Pete30/3dtiskarna/Home.md

Welcome to the **i3 Berlin** wiki!

These pages contain the full assembly manual to build and adjust your i3 Berlin through the following chapters:  

[**Introduction**](https://github.com/laydrop/i3-Berlin/wiki/Section-1-Introduction) About the history of this design and the power of open hardware.

[**Assembly of the Y-Unit**](https://github.com/laydrop/i3-Berlin/wiki/Section-2-Assembly-of-the-Y-Unit) The lower unit which holds the print platform.

[**Assembly of the XZ-Unit**](https://github.com/laydrop/i3-Berlin/wiki/Section-3-Assembly-of-the-XZ-Unit) The vertical part that holds the extruder.  

[**Wiring**](https://github.com/laydrop/i3-Berlin/wiki/Section-4-Wiring) All the wires and where to put them, and you will join the two units.

[**Calibration**](https://github.com/laydrop/i3-Berlin/wiki/Section-5-Calibration) See if everything works correctly and adjust it perfectly.

[**Printing**](https://github.com/laydrop/i3-Berlin/wiki/Section-6-Printing) How to use your printer and some tips to get started.
