Pete30/3dtiskarna/Section-6.1-FilamentHolder.asciidoc

link:Section-6.2-Cura[Next]

|====
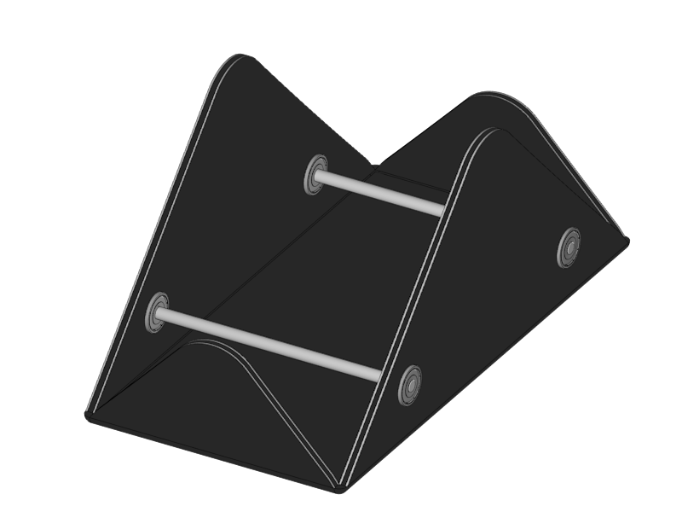
[picture p1: media/Section_6_0021.png]
1.3+||
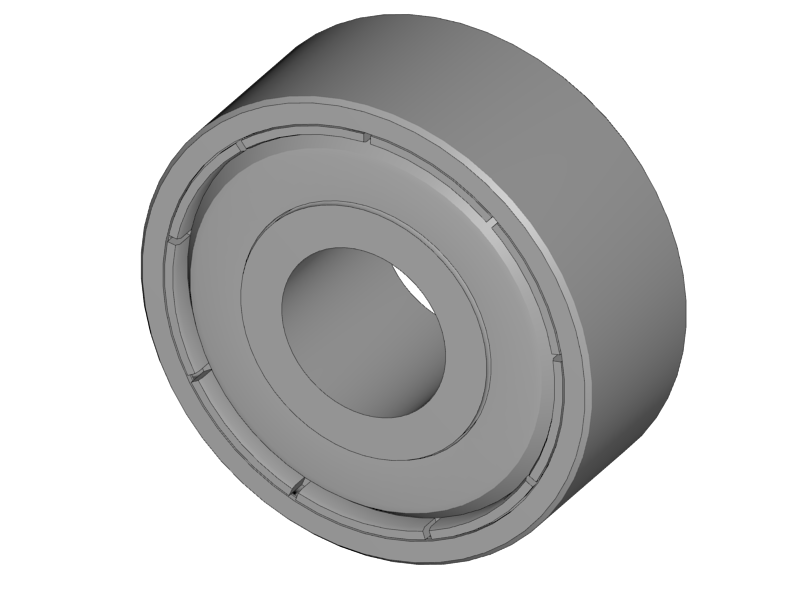
[picture p2: media/Section_1_0001.png]
 +
4x 624 Ball Bearing
|
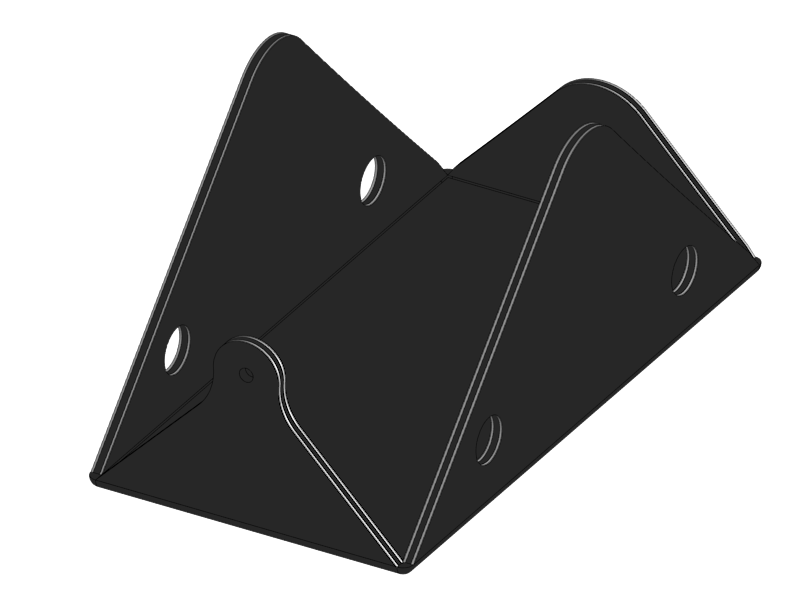
[picture p3: media/Section_1_0156.png]
 +
2x 4mm Rod
|
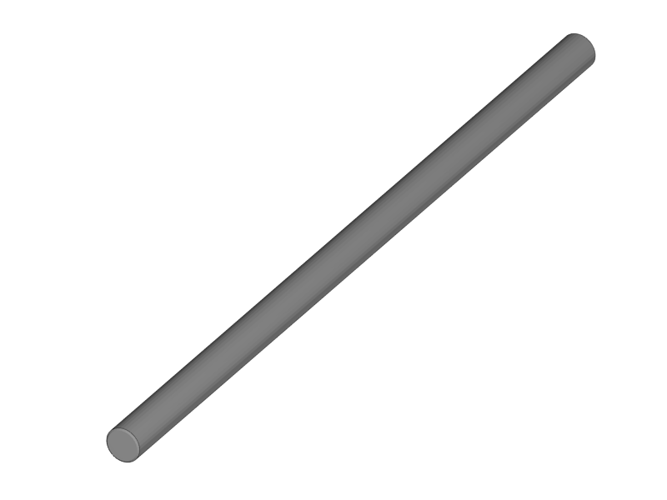
[picture p4: media/Section_1_0157.png]
 +
1x Filament Holder
|====

* Bend the sides of Filament Holder sandwich plate over the grooves. 
* Put the bearings on the 4mm rods
* Put the bearings into the holes of the filament holder
** Secure them with a drip of superglue.

''''''
<<<<<

|====
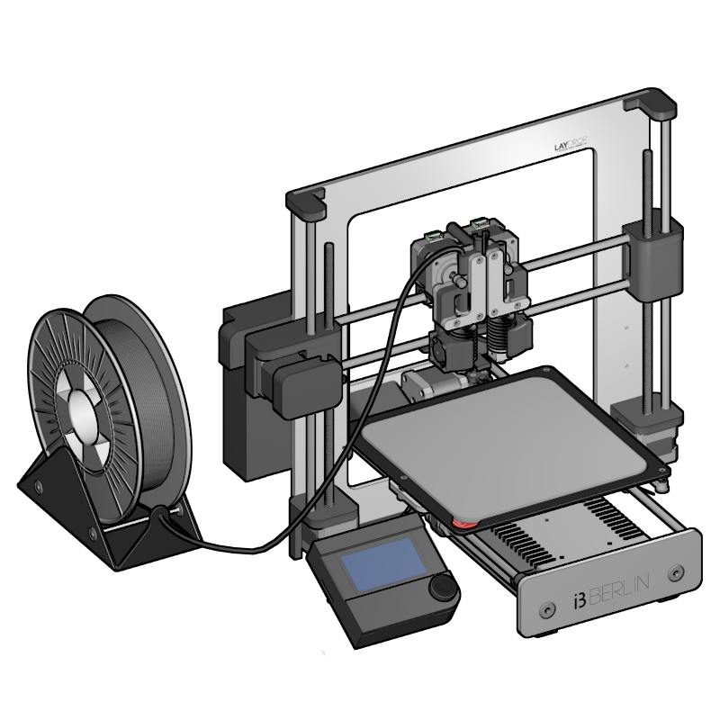
[picture p5: media/Section_6_0020.png]
1.1+||
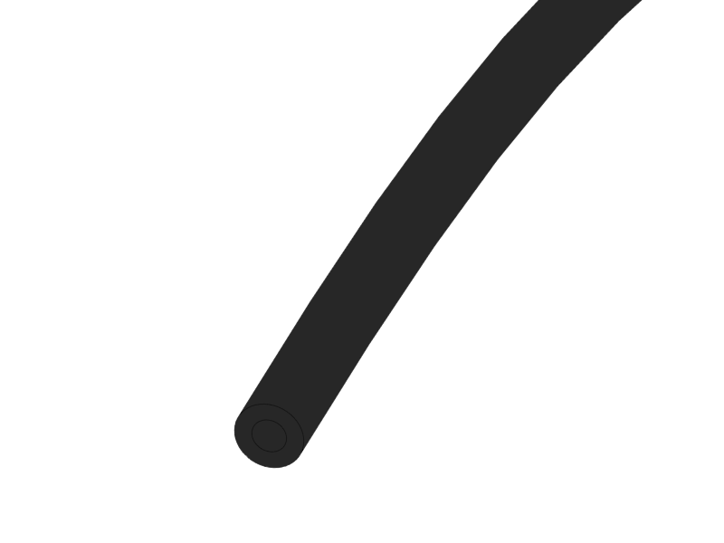
[picture p6: media/Section_1_0158.png]
 +
1x Teflon Hose
|====

* This is how the print set up should be. 
* Put the filament holder at a convenient position. Put the filament roll on top of the rods. Put the filament through the hole in the holder and through the Teflon pipe. 

link:Section-6.2-Cura[Next]
