Pete30/3dtiskarna/Section-4.8-Mounting-the-Heatbed.asciidoc

link:Section-5-Calibration[Next]

|====
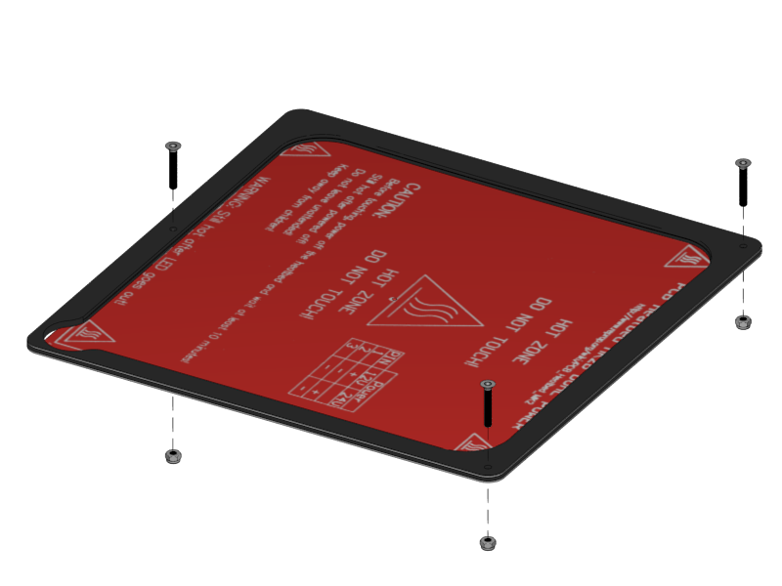
[picture p7: media/Section_4_0041.png]
1.4+||
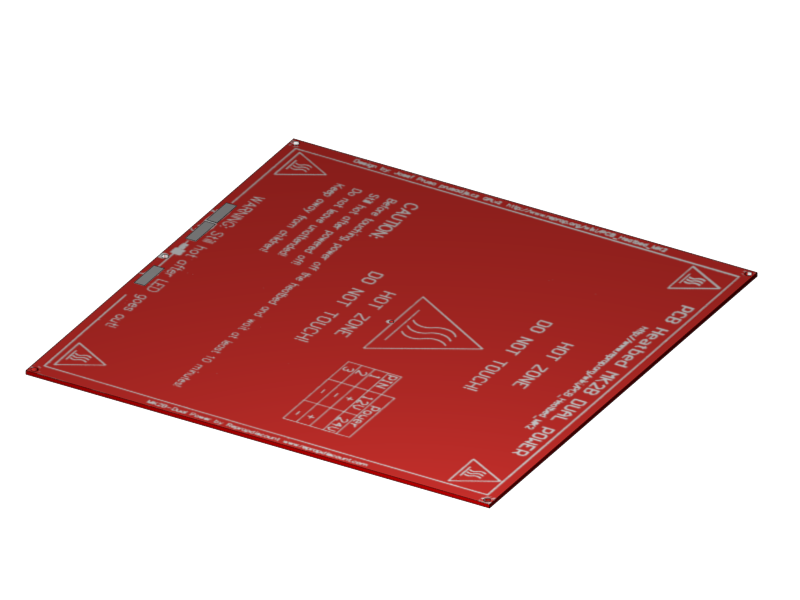
[picture p8: media/Section_1_0007.png]
 +
1x Heatbed
|
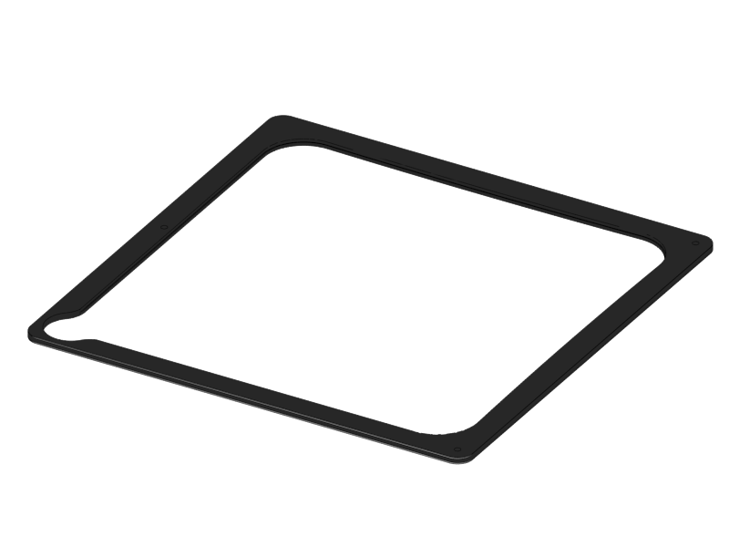
[picture p9: media/Section_1_0148.png]
 +
1x Mirror Clamp
|
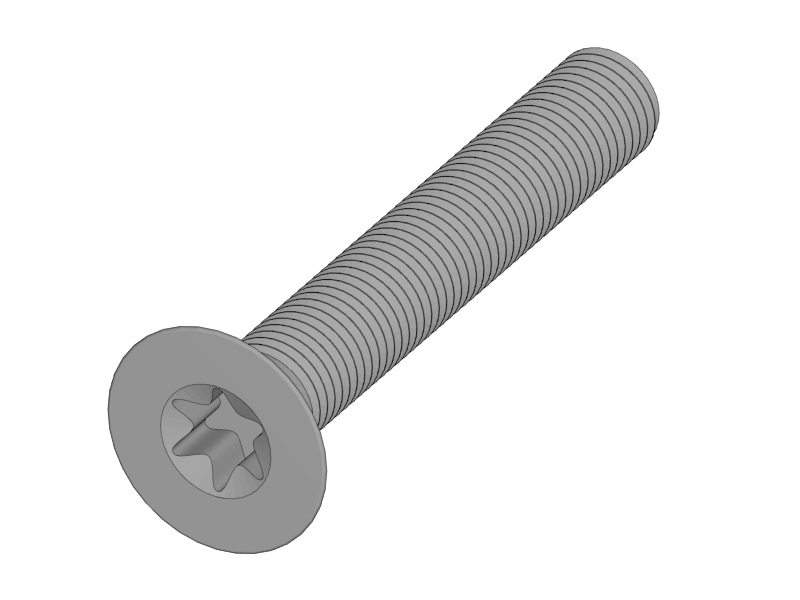
[picture p10: media/Section_1_0021.png]
 +
3x M3x20 CounterSunk
|
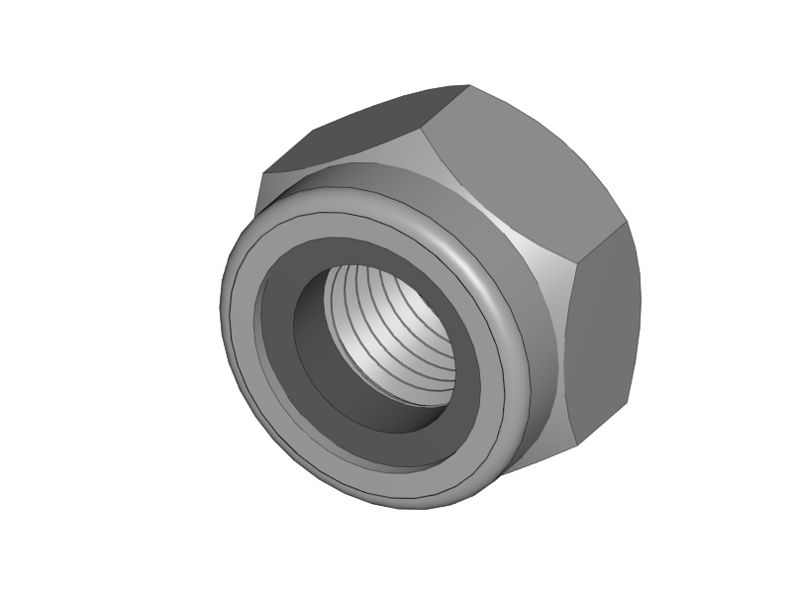
[picture p11: media/Section_1_0026.png]
 +
3x Lock Nut
|====

* Mount the Mirror Clamp onto the Heatbed with the screws and nuts.
** The matte side is mounted on top.
* Tighten the nuts until the head of the screws is being pulled smoothly into the material of the mirror clamp. 

''''
<<<<

|====
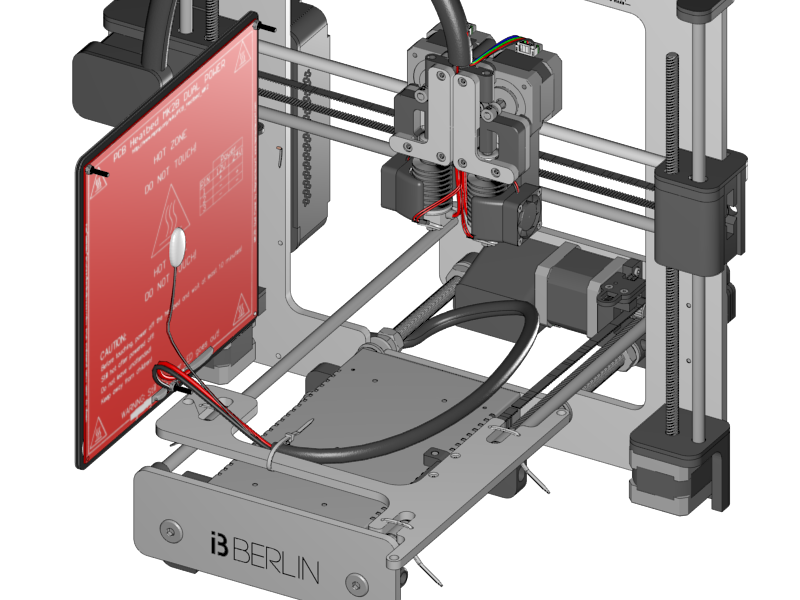
[picture p12: media/Section_4_0042.png]
1.1+||
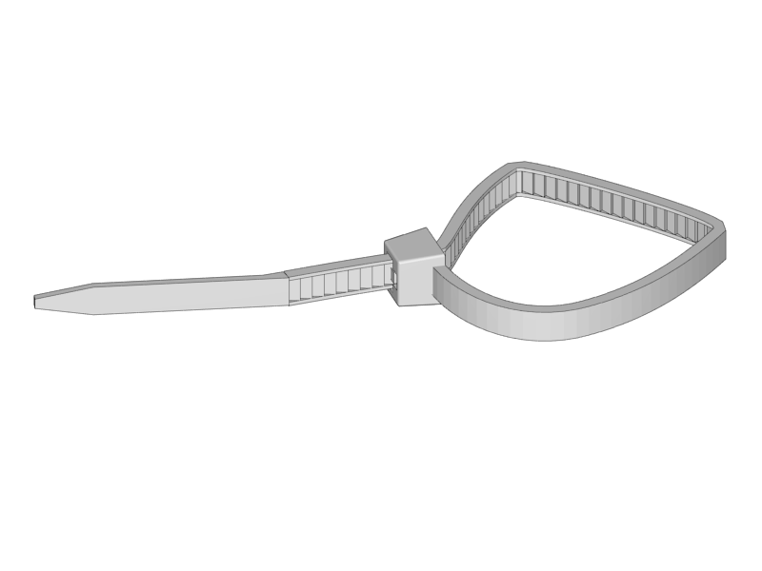
[picture p13: media/Section_1_0041.png]
 +
1x Ziptie
|====

* Hold the heatbed on the left side of the y-carriage as shown in the picture above
* Fix the braided sleeve of the heatbed cable to the back of the y-carriage with a zip tie
* Lay down the heatbed and organize the cable so that the wires are neatly underneath the heatbed. 

''''
<<<<

|====
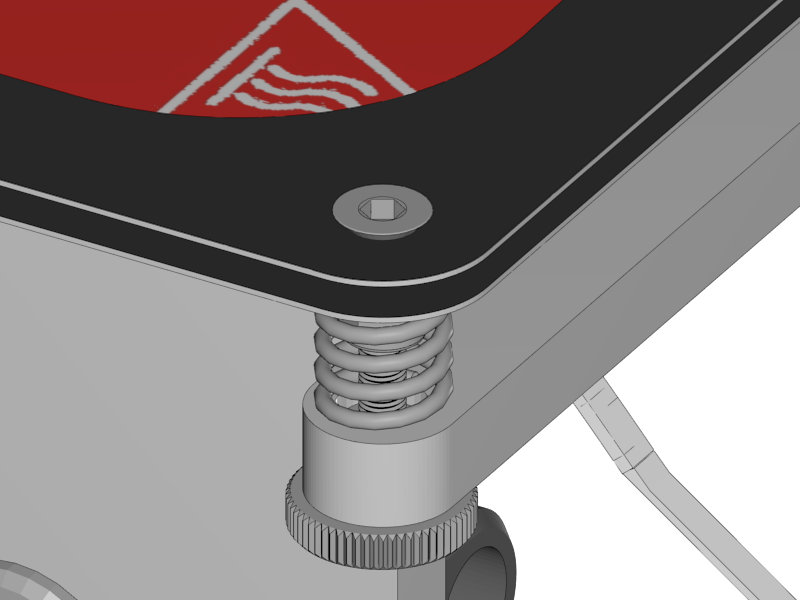
[picture p14: media/Section_4_0043.png]
1.2+||
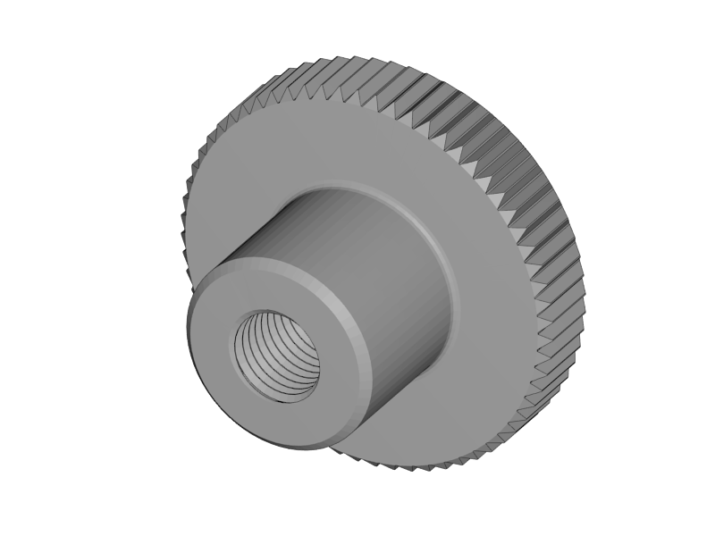
[picture p15: media/Section_1_0147.png]
 +
3x M3 Knurled Nut
|
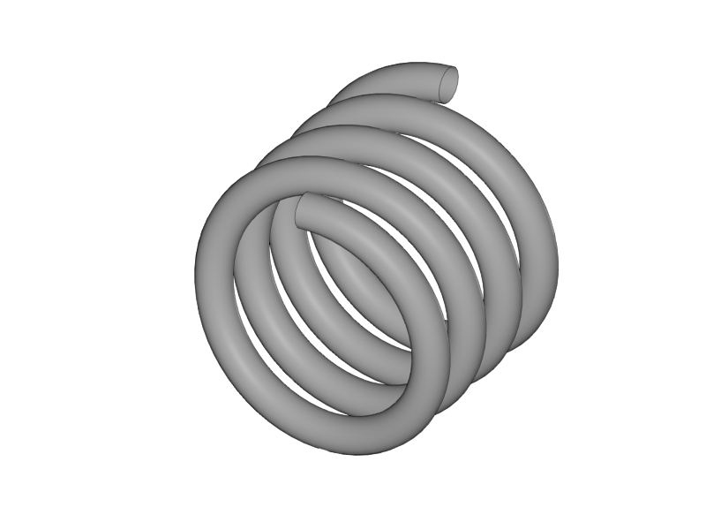
[picture p16: media/Section_1_0146.png]
 +
3x Spring
|====

* Put the springs over the screws.
* Tighten them with the knurled nuts.
* The adjusting of the heatbed happens in the next chapter so don't bother about it now.

''''
<<<<

|====
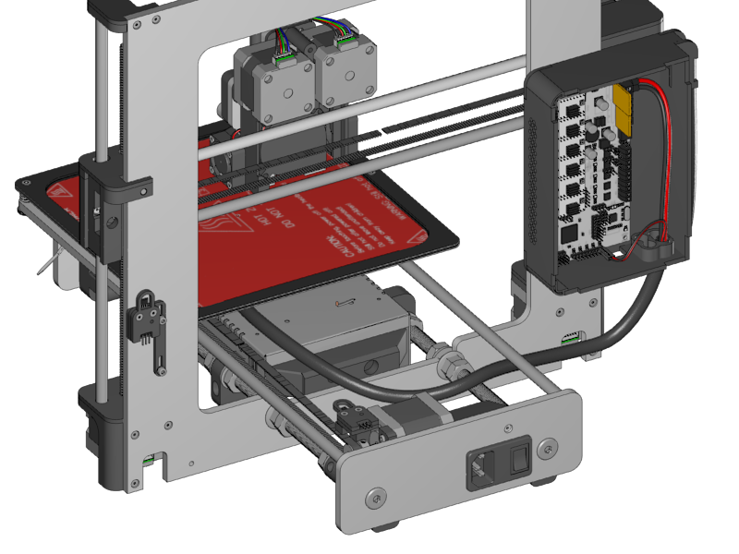
[picture p17: media/Section_4_0044.png]
1.2+||
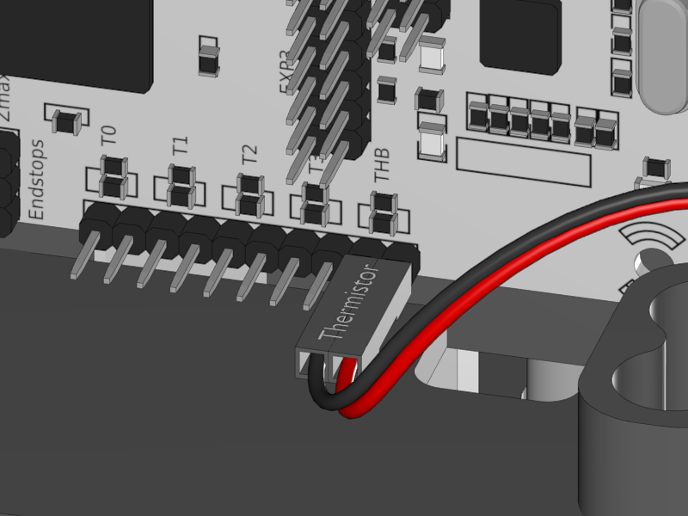
[picture p18: media/Section_4_0045.png]
 +
Heatbed Thermistor Connection
|
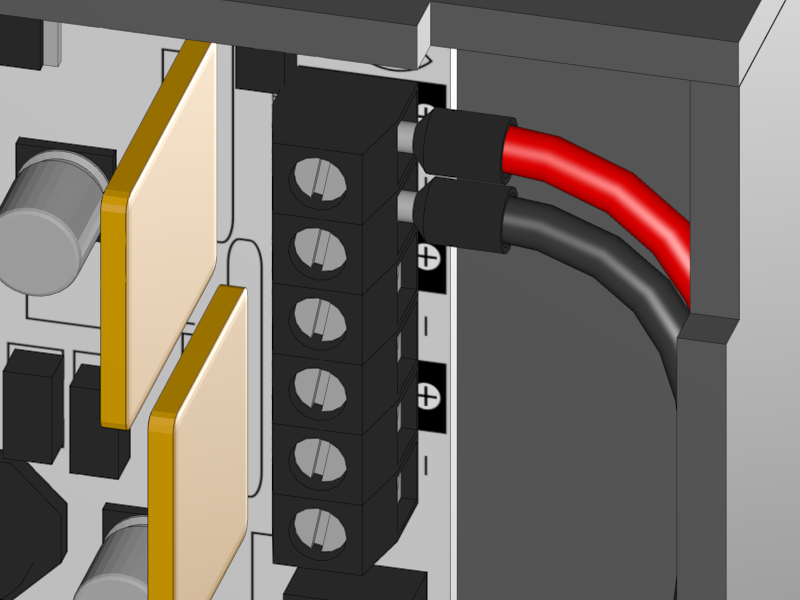
[picture p19: media/Section_4_0046.png]
 +
Heatbed Power Connection
|====

* Connect the heatbed to the RUMBA
** Fix the cable in such a way that it does not obstruct the movement of the Y-Axis. 
** The cable probably runs smoothest if guided between the M10 rod and the smooth rod. 
** Experiment with how to fix the cable with zipties for optimal movement. 

link:Section-5-Calibration[Next]
