Pete30/3dtiskarna/Section-1.3-Preparing-Casings.asciidoc

link:Section-2-Assembly-of-the-Y-Unit[Next]

link:Section-1-Introduction[Section Menu]

|====
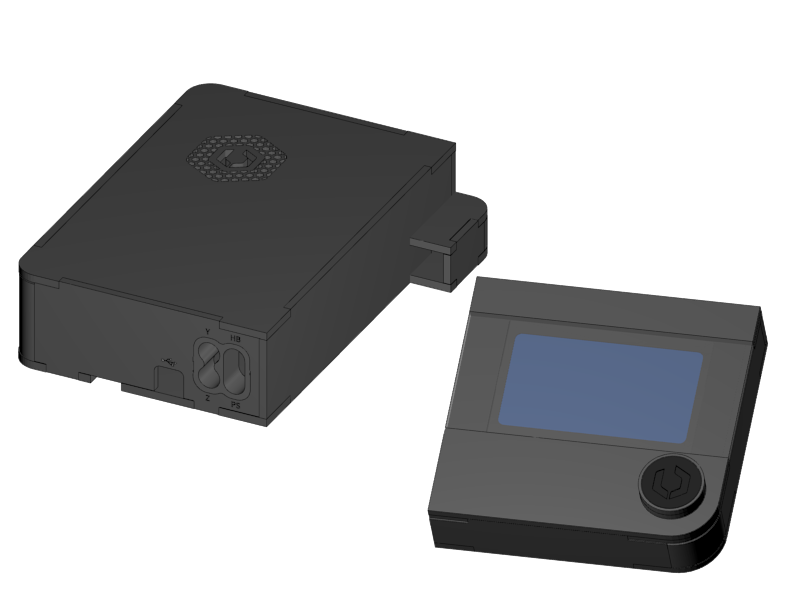
[picture p24: media/Section_6_0008.png]
|
|====

You will start the assembly with glueing the casings for the RUMBA controller electronics and the display. Since the glue needs time to dry it's to best to have this done now. 

Please don't use 1 second cyano-acrylat superglue for glueing the acrylic and printed parts, because they will probably cause ugly white stains.

''''
<<<<

|====
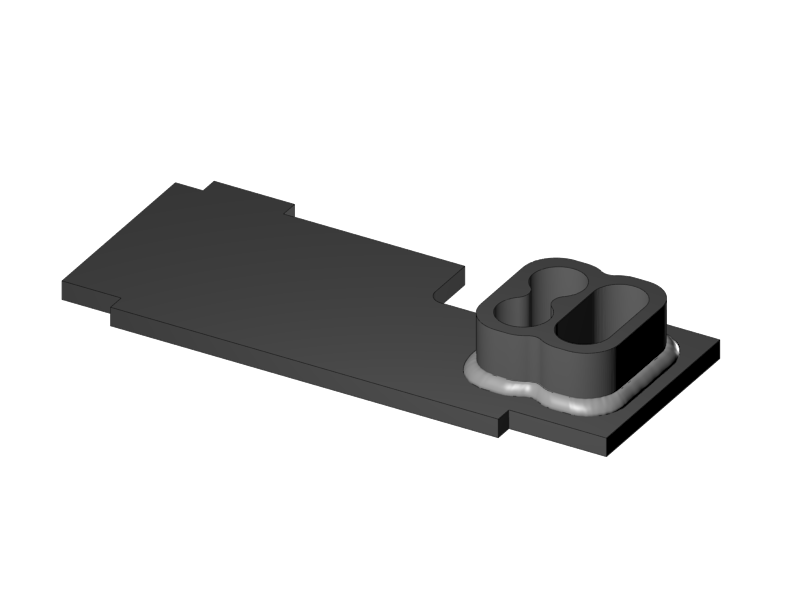
[picture p25: media/Section_6_0001.png]
1.2+||
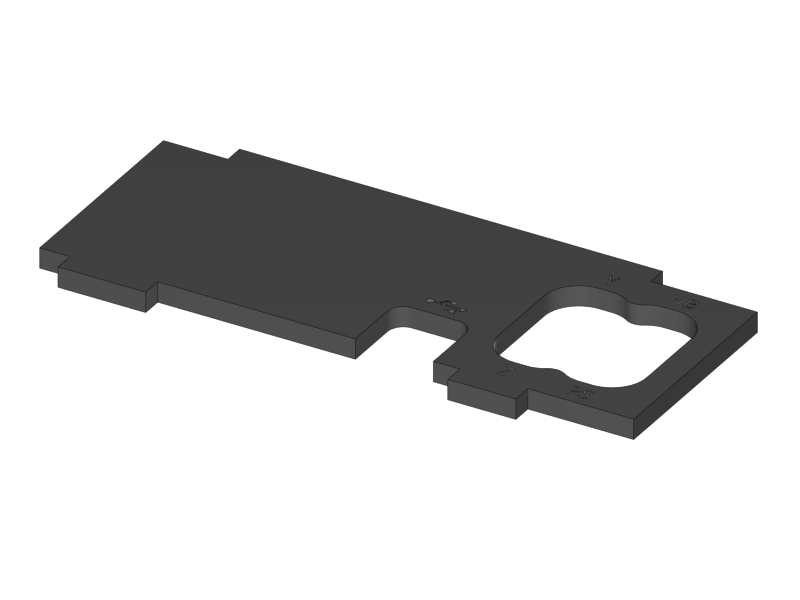
[picture p26: media/Section_1_0130.png]
 +
1x RUMBA Case Bottom
|
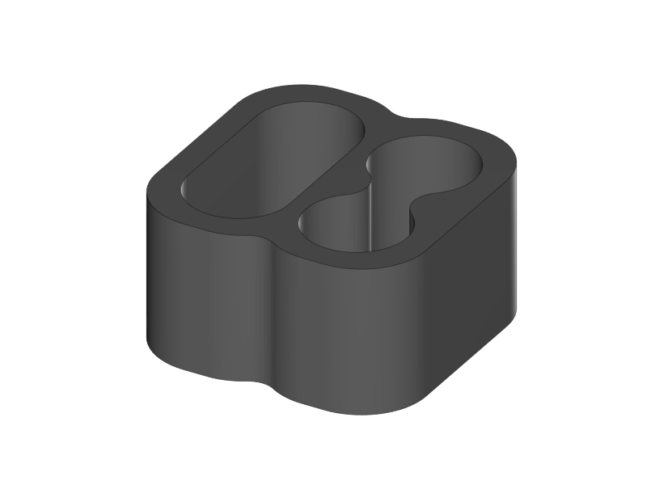
[picture p27: media/Section_1_0131.png]
 +
1x RUMBA Case Cable Inlet
|====

* Look for the RUMBA Case Bottom part in the bag of acrylic parts.
** Remove the protective film on the shiny side of the acrylic.
* The Cable Inlet can be found in the bag of printed parts. 
* Stick the parts together in such a way that the printed part is flush with the engraved side of the acrylic part. 
* If the parts are not fixed well, apply some plastic glue in the corners. 
** Mind that the matte side of the acrylic is going to be the visual outside of the casing, so prevent glue stains here. 

'''''
<<<

|====
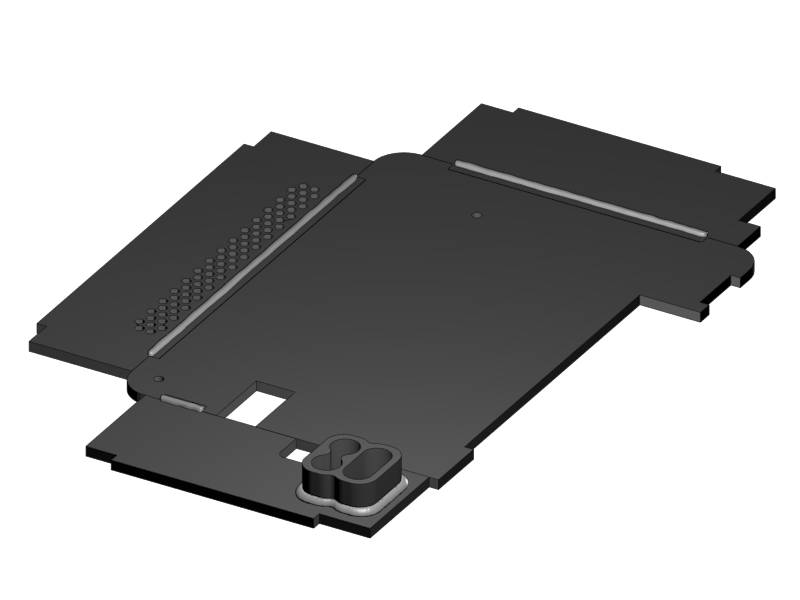
[picture p28: media/Section_6_0003.png]
1.3+||
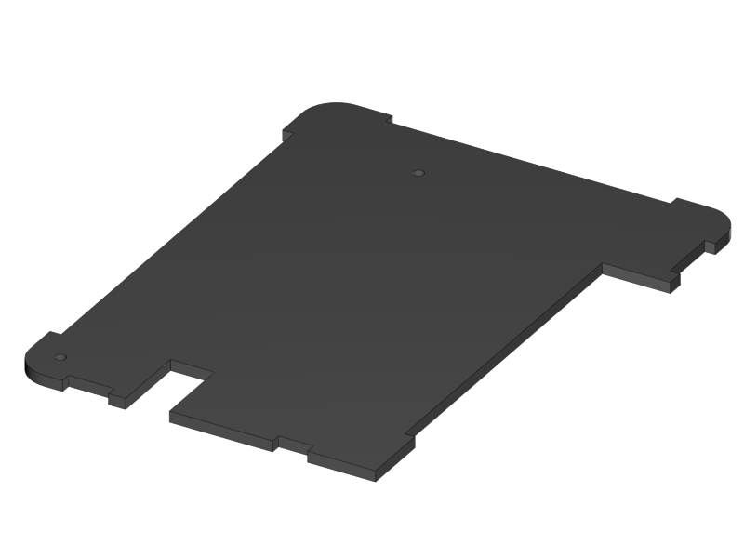
[picture p29: media/Section_1_0129.png]
 +
1x RUMBA Case Base
|
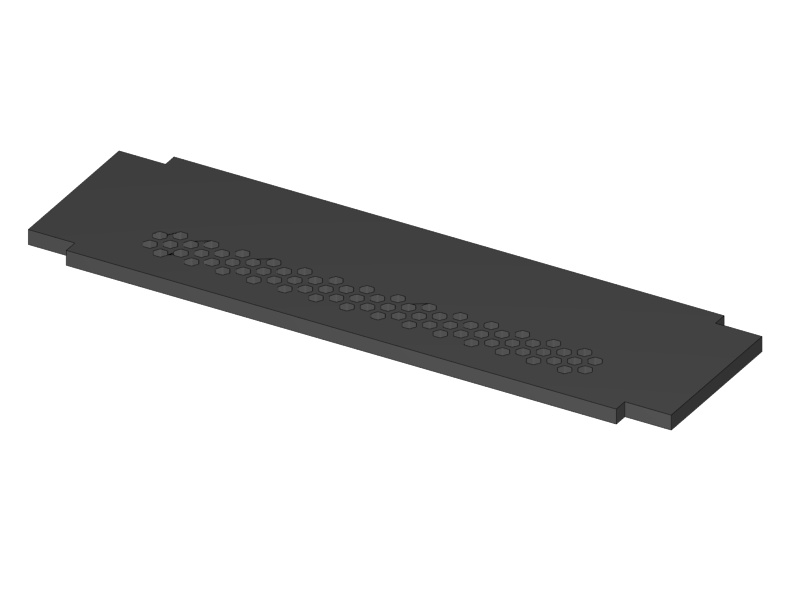
[picture p30: media/Section_1_0133.png]
 +
1x RUMBA Case Left Side
|
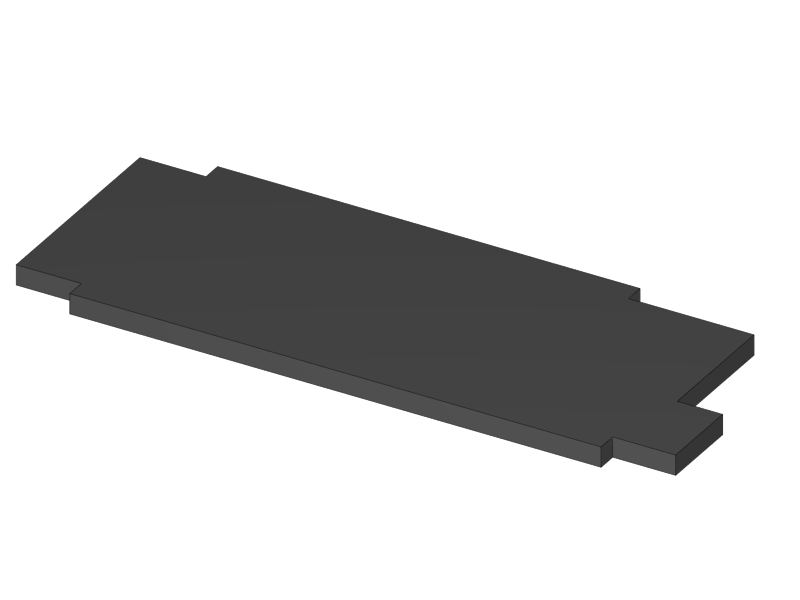
[picture p31: media/Section_1_0139.png]
 +
1x RUMBA Case Top
|====

* Remove the protection film on the shiny side of the acrylic.
** Leave the protection film of the matte side in place as much a possible to prevent scratches and glue stains.
* Connect the parts as shown above with the shiny part on top.
* Take a good look at the image. Apply a line of glue in such a way that it will always stay inside of the casing to prevent stains. 

''''
<<<

|====
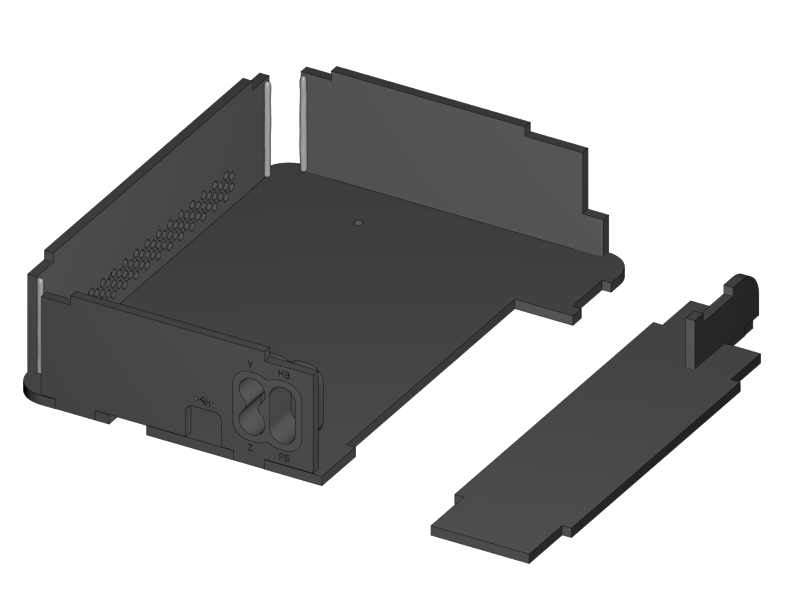
[picture p32: media/Section_6_0004.png]
1.1+||
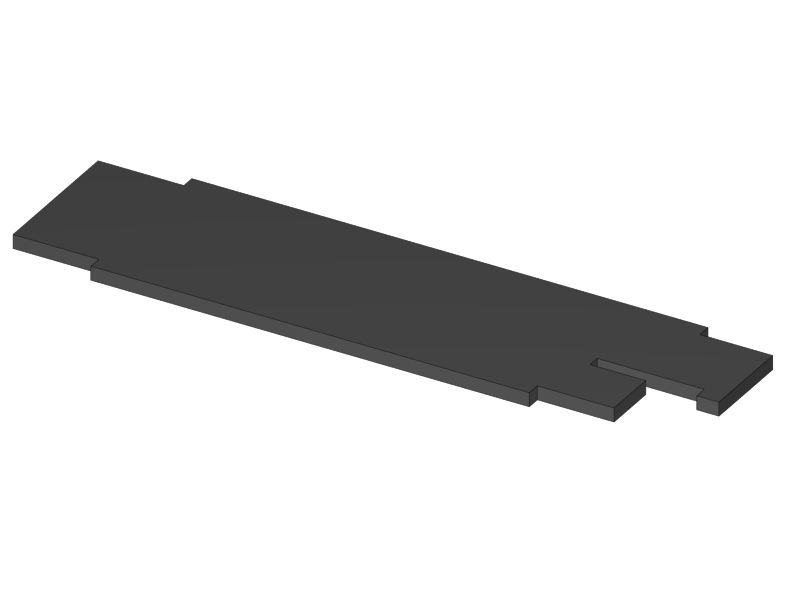
[picture p33: media/Section_1_0135.png]
 +
1x RUMBA Case Right Side
|
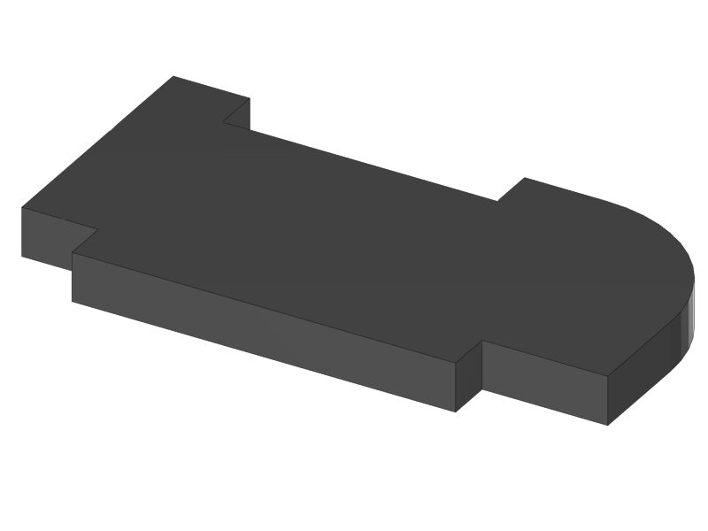
[picture p34: media/Section_1_0137.png]
 +
1x RUMBA Case Side Top
|====

* Flip up the 3 sides as shown in the picture above, and push them well in place. 
* Prepare a line of glue on the two left corners.
* Remove the protective film of the acrylic parts.
* Push in the small piece as shown.
** Apply glue if necessary.
* Put 3 lines of glue on the shiny side of the big part as preparation. 

''''
<<<<

|====
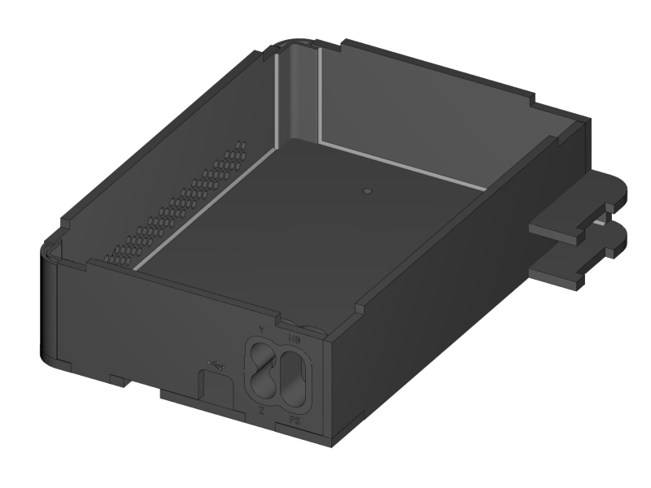
[picture p35: media/Section_6_0005.png]
1.1+||
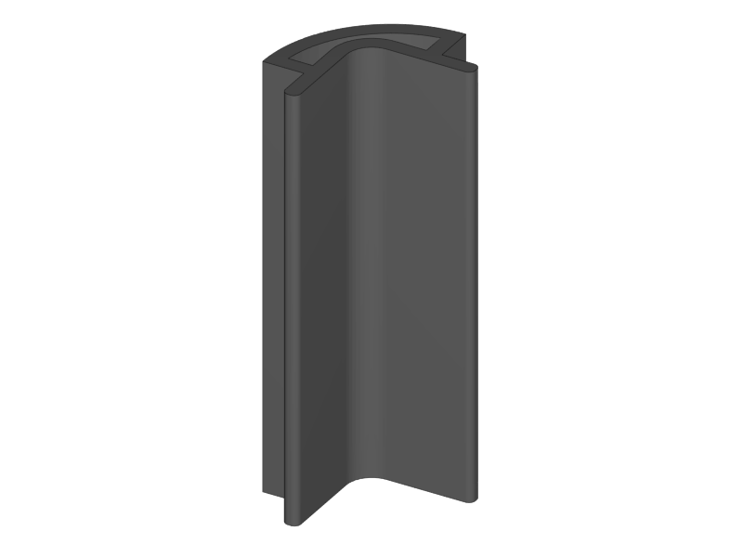
[picture p36: media/Section_1_0132.png]
 +
2x RUMBA Case Corner
|====

* Put the Right Side of the case into position
** It's done easiest by placing the lower corner in position first and then turning the part in a counter clockwise direction looking from the top. 
* Slide in the 3D printed corners. 
* Put extra glue into all the corners to secure strength.
* Fix all the parts with some tape where needed and leave it to dry. 

''''
<<<<

|====
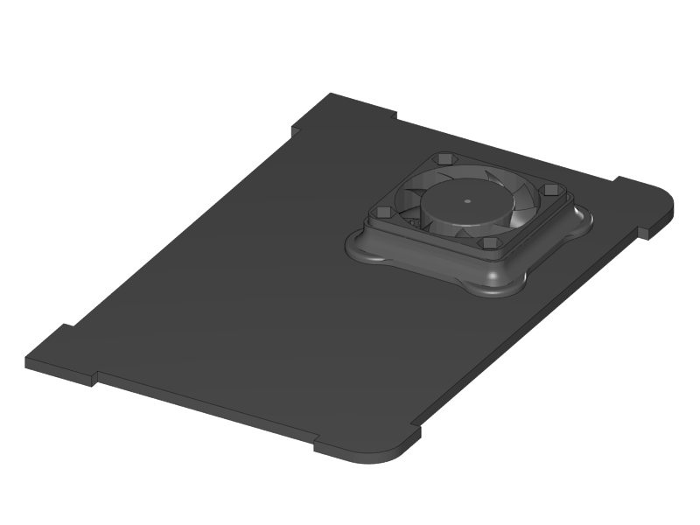
[picture p37: media/Section_6_0006.png]
1.3+||
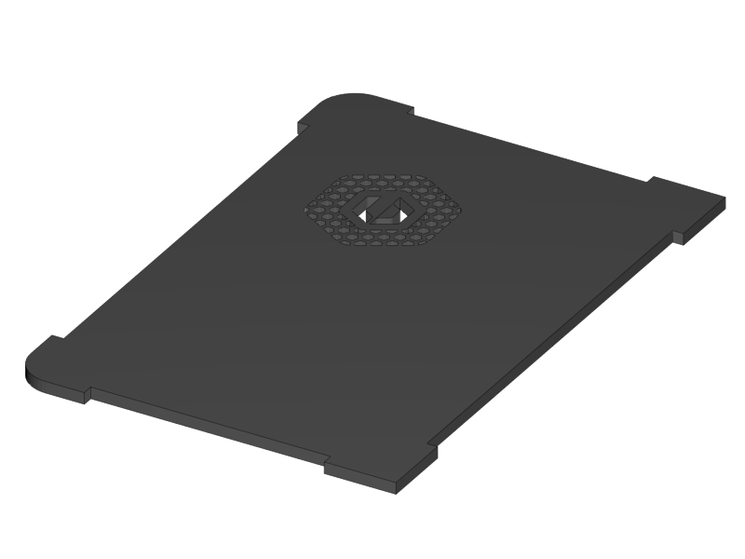
[picture p38: media/Section_1_0134.png]
 +
1x RUMBA Case Lid
|
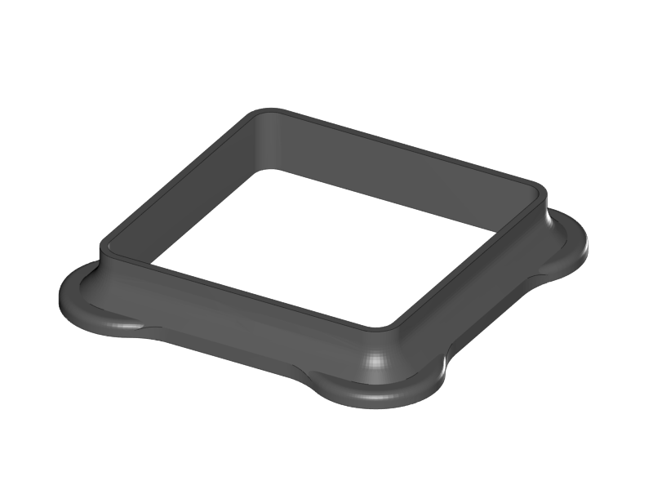
[picture p39: media/Section_1_0140.png]
 +
1x RUMBA Case FanHolder
|
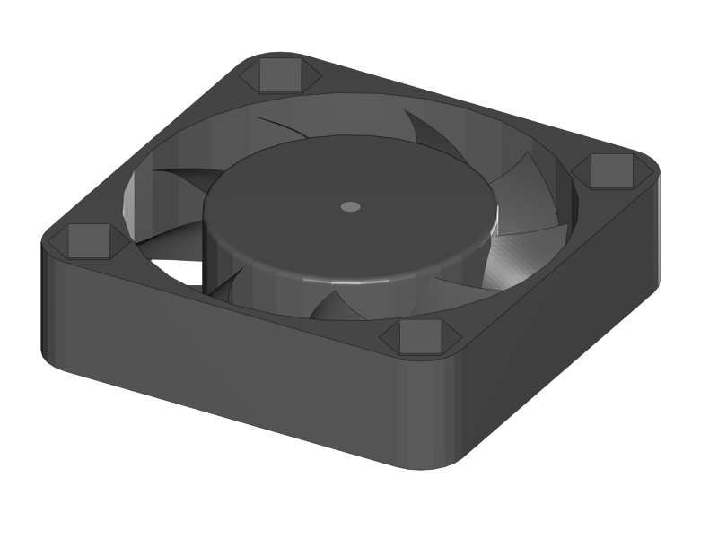
[picture p40: media/Section_1_0141.png]
 +
1x 40mm Fan
|====

* Glue the FanHolder on the shiny side of the RUMBA Case Lid. 
** Putting the fan first helps with aligning the position of the fan holder
** Note that the fan should NOT be glued to anything
** The fan can be found in the box of the RAMPS electronics
** Putting the sticker of the fan towards the outlet is recommended. Like that it will suck air out of the casing instead of blowing it in. An airstream like this reduces dust accumulations. 
** You can leave the fan. 
* The casing is now finished. The remaining parts will be glued later in the wiring section. 

''''
<<<<

|====
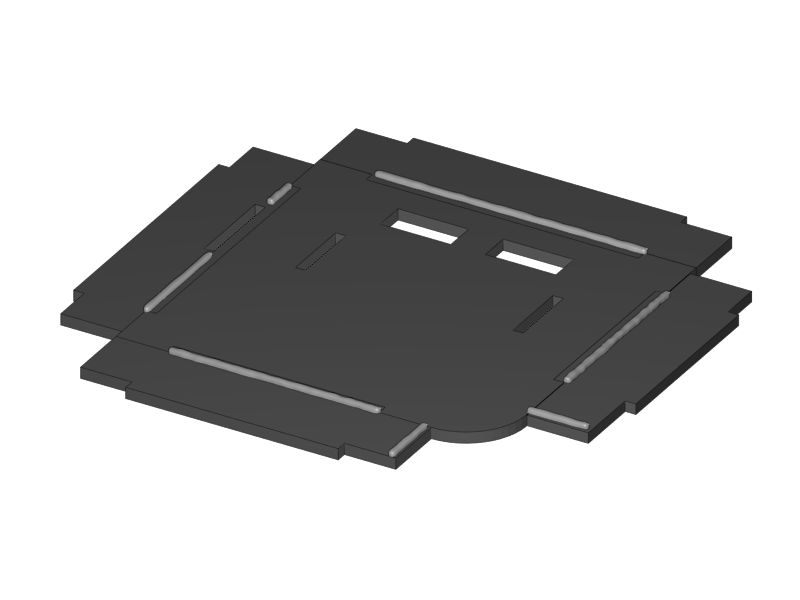
[picture p41: media/Section_6_0010.png]
1.5+||
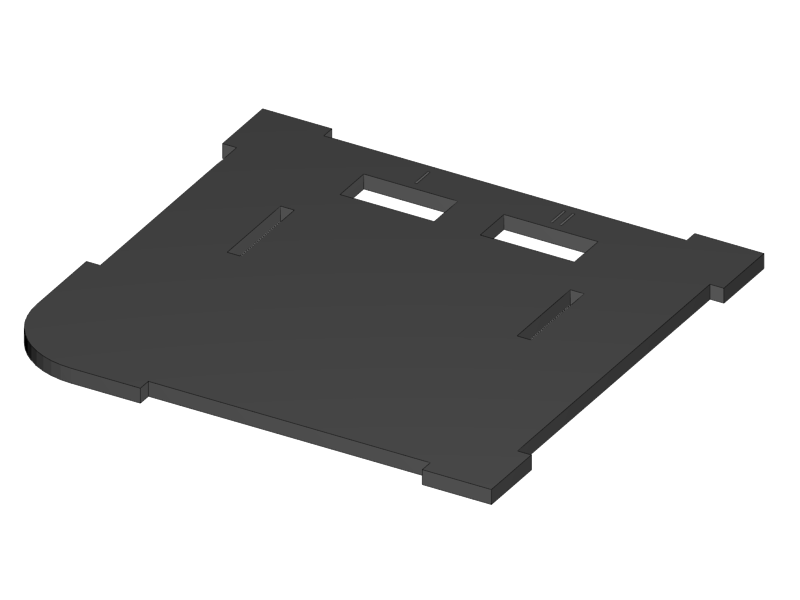
[picture p42: media/Section_1_0114.png]
 +
1x Display Case Base
|
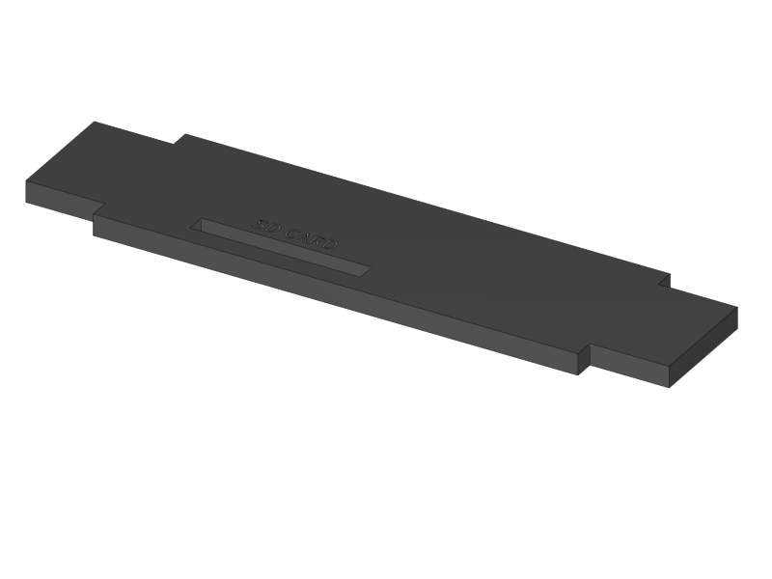
[picture p43: media/Section_1_0122.png]
 +
1x Display Case Left
|
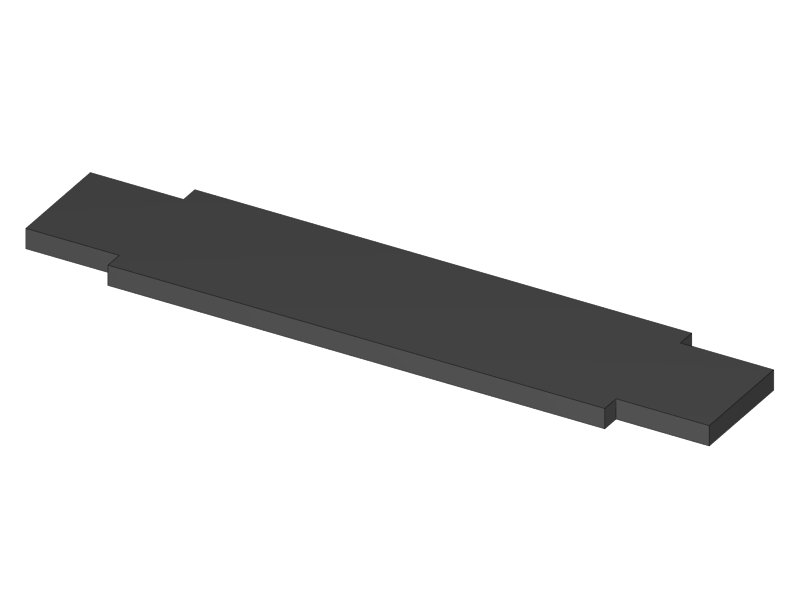
[picture p44: media/Section_1_0115.png]
 +
1x Display Case Back
|
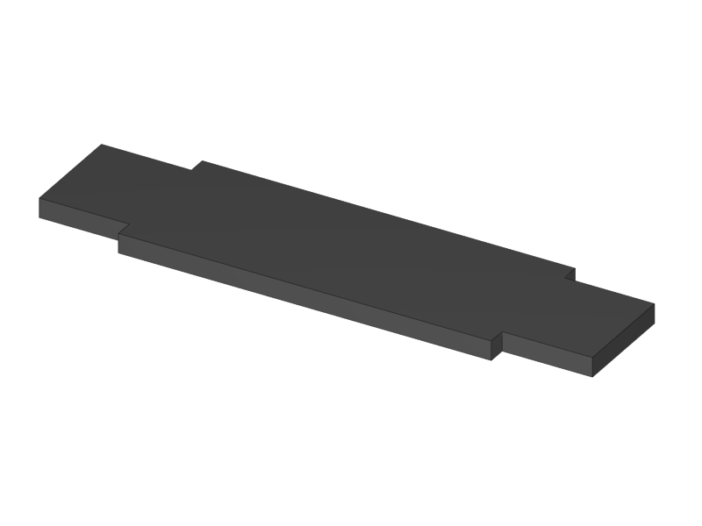
[picture p45: media/Section_1_0118.png]
 +
1x Display Case Front
|
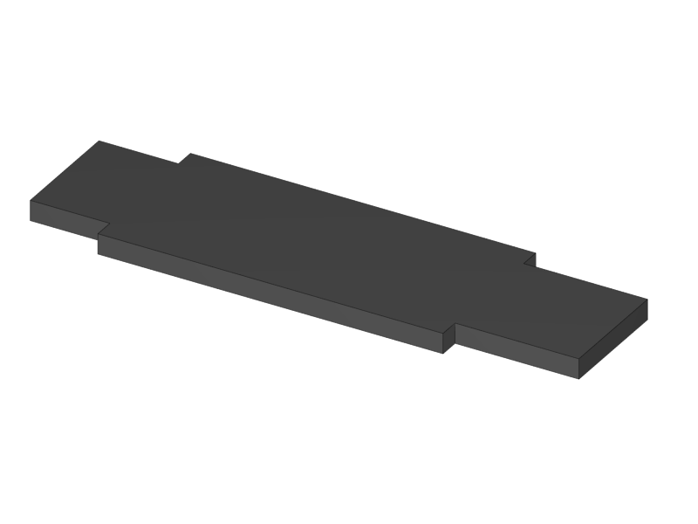
[picture p46: media/Section_1_0123.png]
 +
1x Display Case Right
|====

* Remove the protective film from the shiny side of the acrylic parts.
** It's best to leave the protective film on the matte side.
* Put them together as shown above.
* Apply a line of glue on the exact place as shown above.

''''
<<<<

|====
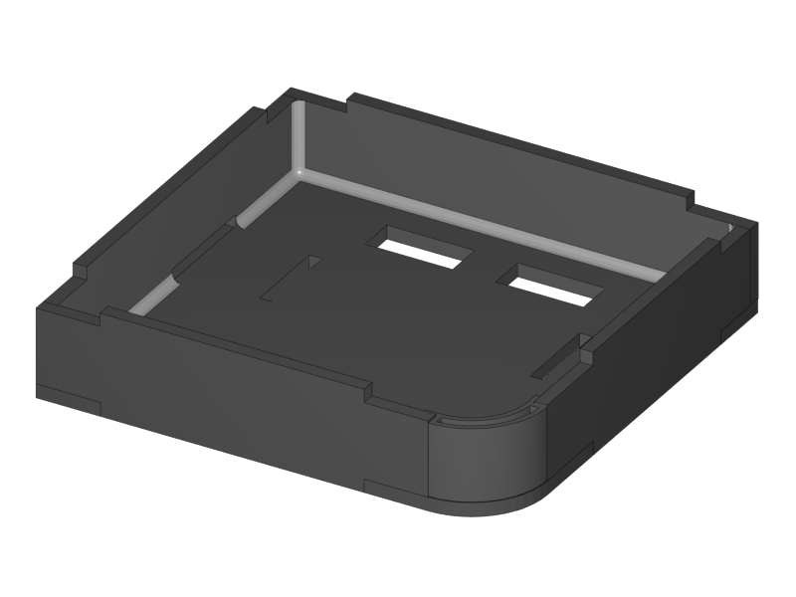
[picture p47: media/Section_6_0011.png]
1.1+||
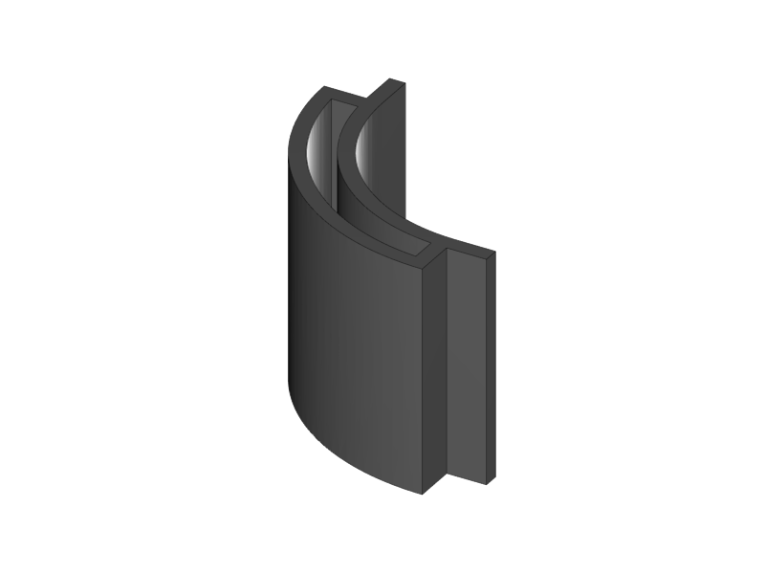
[picture p48: media/Section_1_0116.png]
 +
1x Display Case Corner
|====

* Flip up the sides. 
* Put in the corner and glue it
* Apply some extra glue in the inner corners of the case to secure strength
* Put tape where needed and let the case dry. 

''''
<<<<

|====
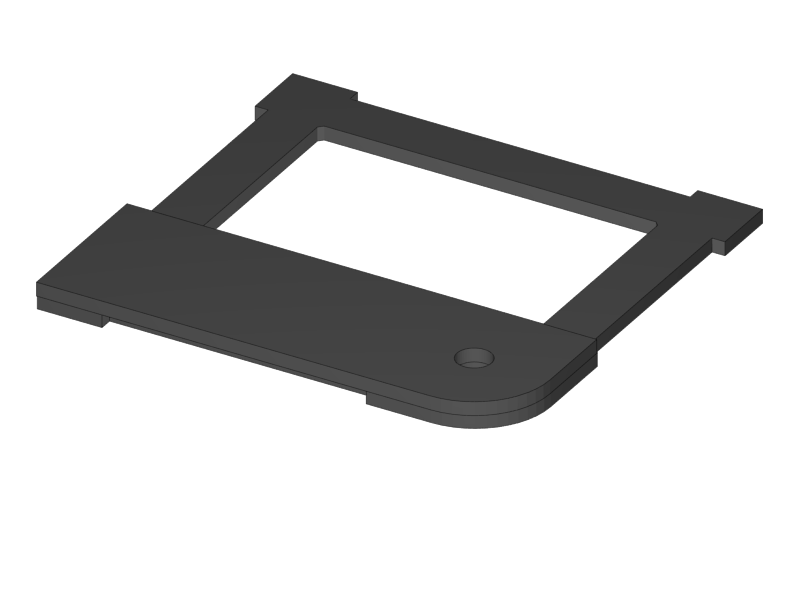
[picture p49: media/Section_6_0012.png]
1.2+||
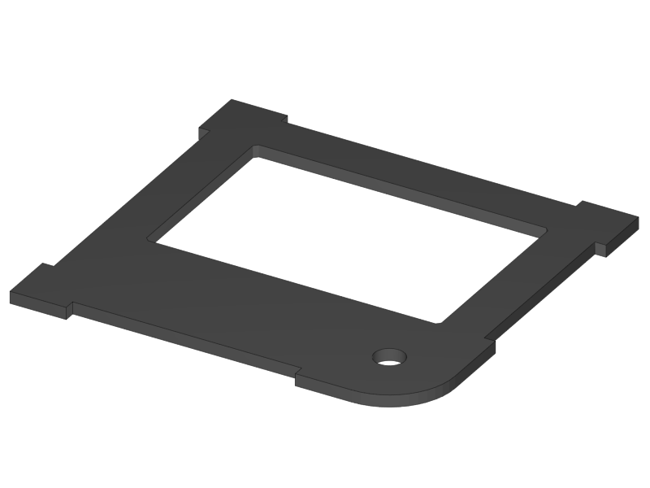
[picture p50: media/Section_1_0125.png]
 +
1x Display Case Top Base
|
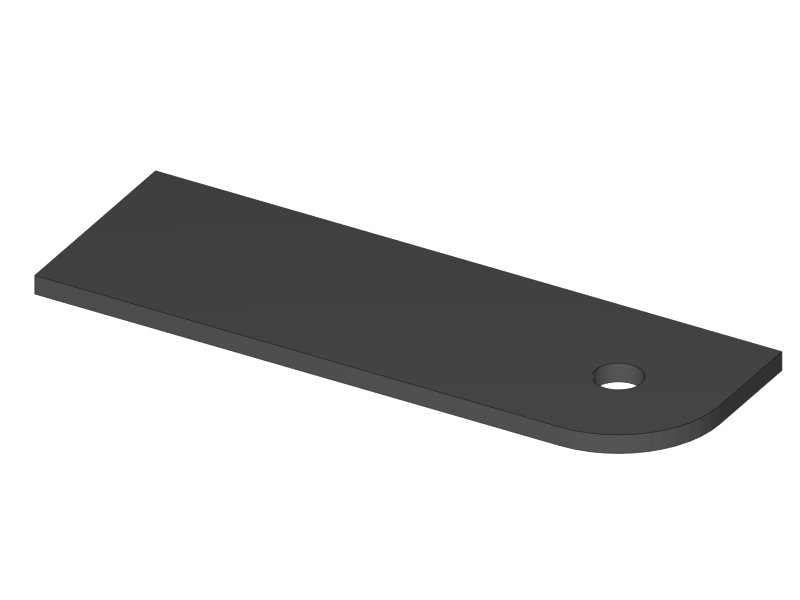
[picture p51: media/Section_1_0126.png]
 +
1x Display Case Top Bottom
|====

* Remove all the protective films, but leave the film on the matte side of the Top Bottom part. 
* Glue the two parts together, take care of alignment.

''''
<<<<

|====
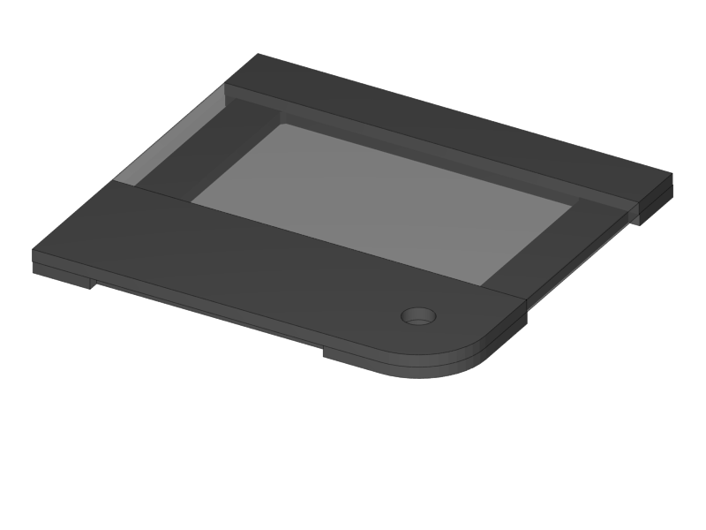
[picture p52: media/Section_6_0013.png]
1.2+||
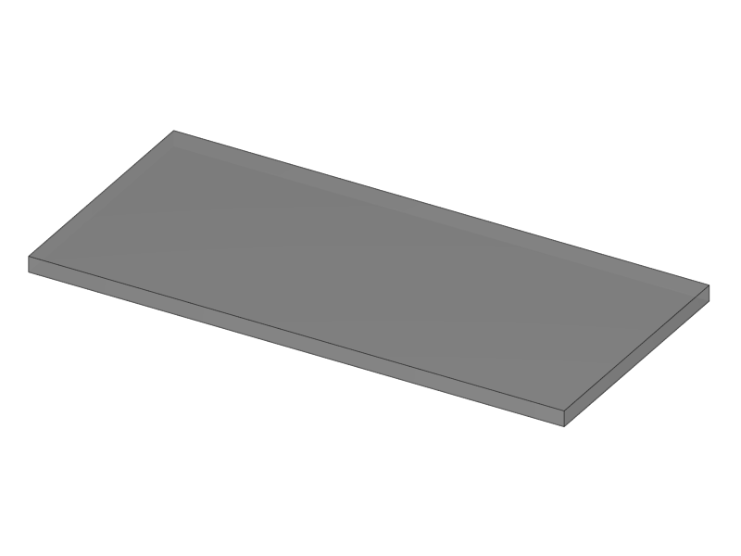
[picture p53: media/Section_1_0127.png]
 +
1x Display Case Window
|
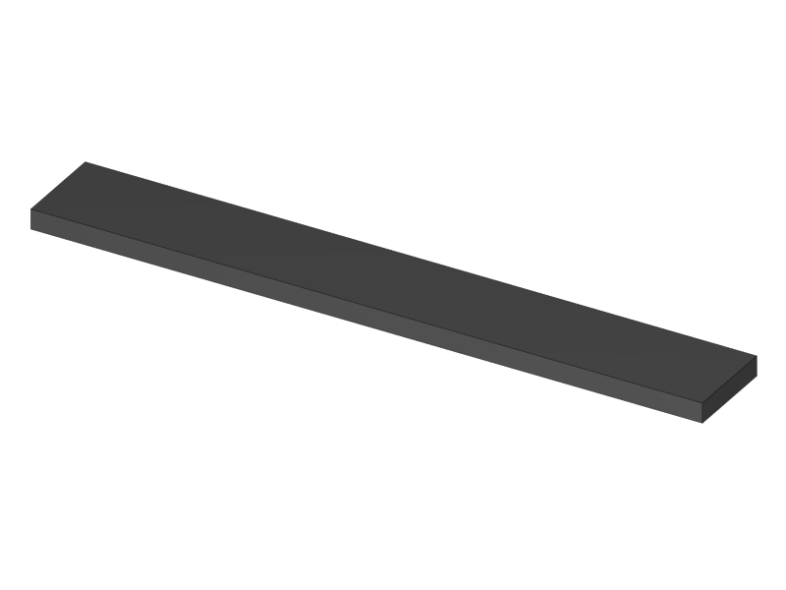
[picture p54: media/Section_1_0128.png]
 +
1x Display Case Top
|====

* Remove only the protective film from the shiny side of the top part
* Put the window part in without glueing it.
* Glue the top part to the base, take care of the alignment.
* Remove the protective film from one side of the window part and glue it to the base.
* Double check alignment of all the parts and leave it to dry. 

''''
<<<<

|====
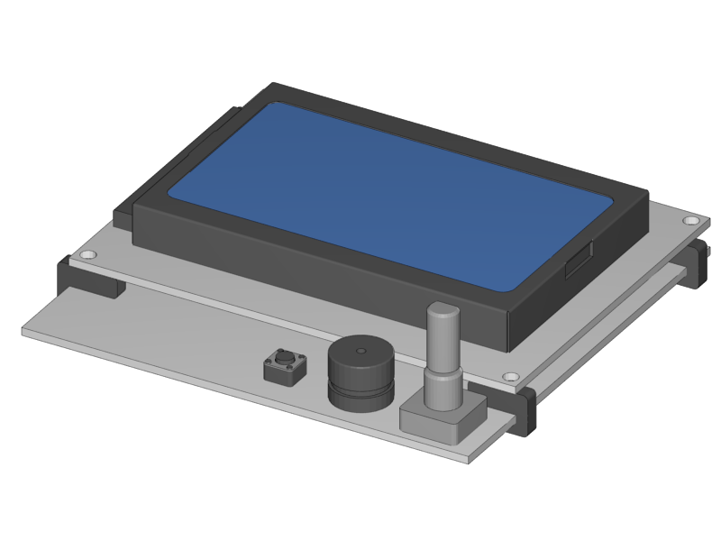
[picture p55: media/Section_6_0014.png]
1.2+||
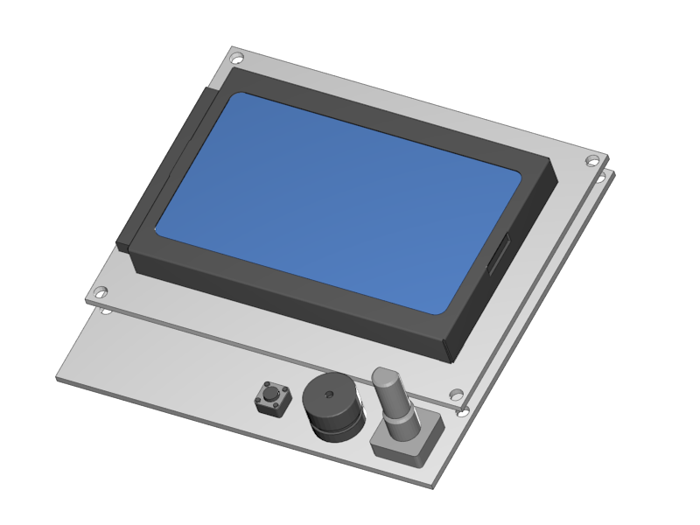
[picture p56: media/Section_1_0005.png]
 +
1x Graphic LCD Controller
|
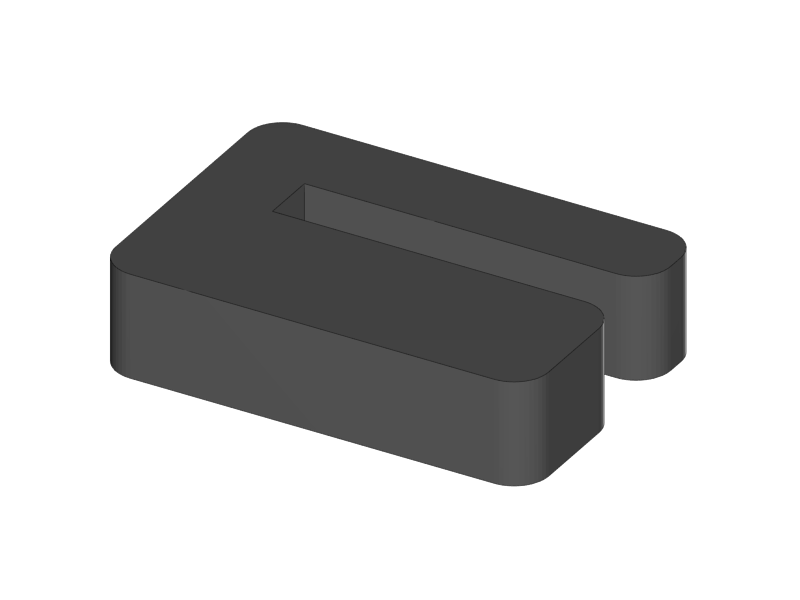
[picture p57: media/Section_1_0142.png]
 +
4x Display spacer
|====

* The following steps should only be done when the glue is dry, some hours after the previous step.
* Put the Display Spacers onto the display. 
* Slide the Display into the casing as shown below.
* Close the casing with the lid, but don't glue it. 

|====
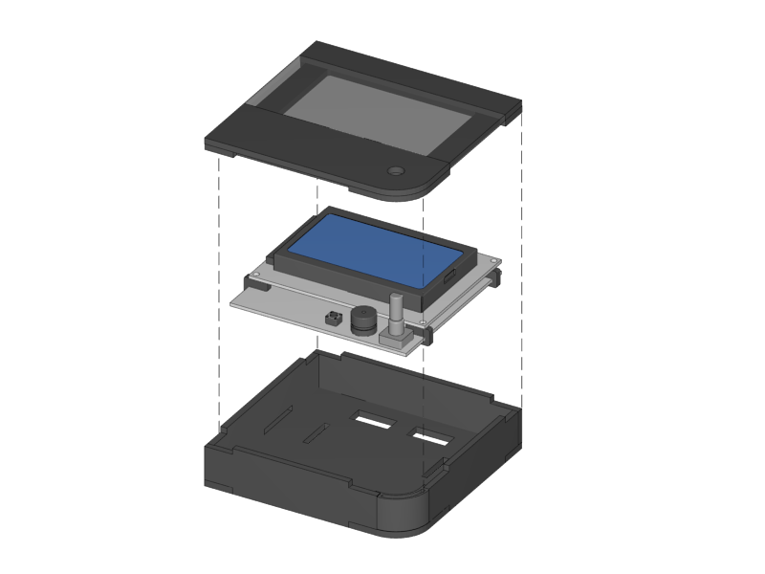
[picture p58: media/Section_6_0015.png]
|
|====

''''
<<<<

|====
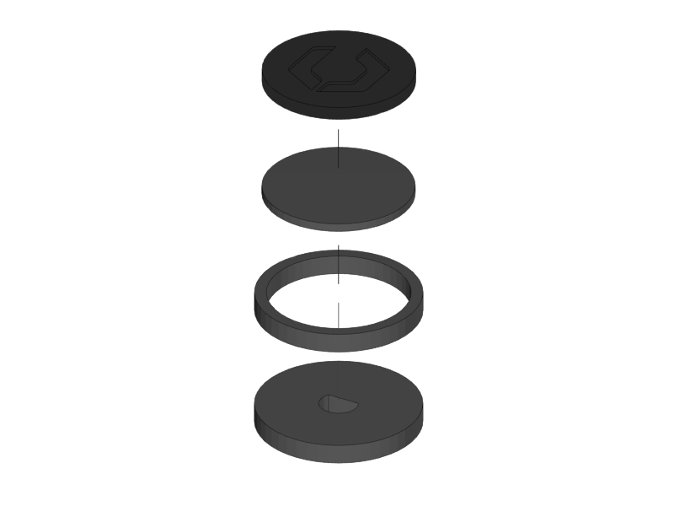
[picture p59: media/Section_6_0016.png]
1.4+||
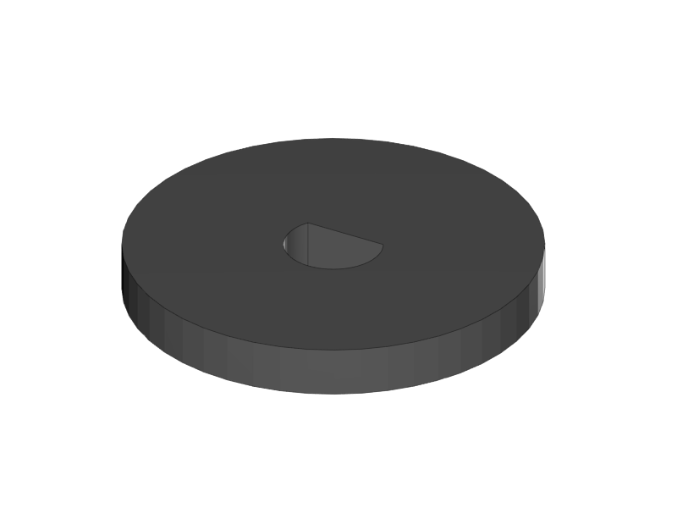
[picture p60: media/Section_1_0119.png]
 +
1x Knob Base
|
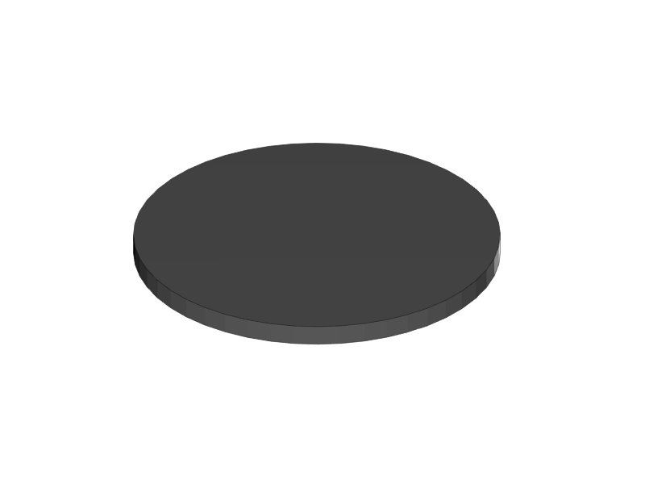
[picture p61: media/Section_1_0124.png]
 +
1x Knob Support
|
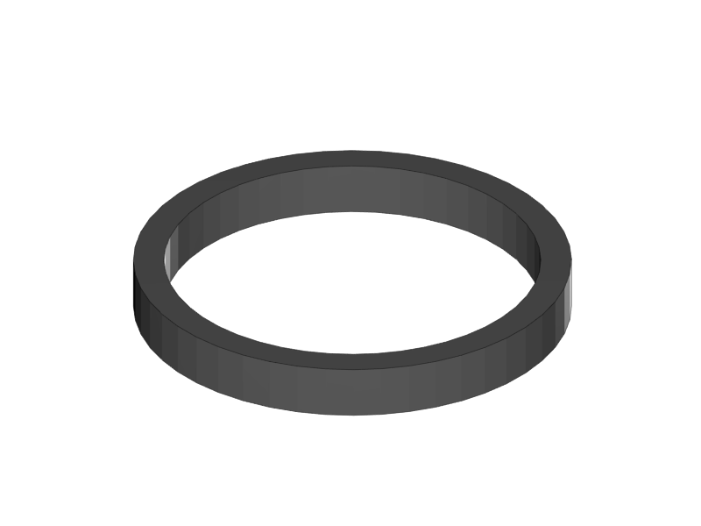
[picture p62: media/Section_1_0121.png]
 +
1x Knob Rim
|
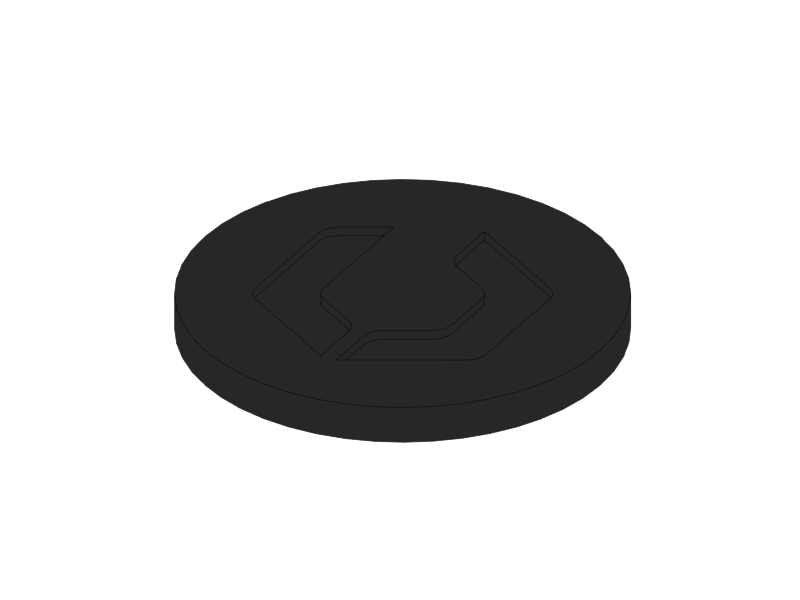
[picture p63: media/Section_1_0120.png]
 +
1x Knob Cushion
|====

* Put the Rim onto the Base and apply some little drips of 1 second super glue to the inner corner. 
** Make sure that you don't leave glue stains
* Glue the Support to the Base with some drips of 1 second super glue
* Glue the Cushion to the Support with super glue.

''''
<<<<

|====
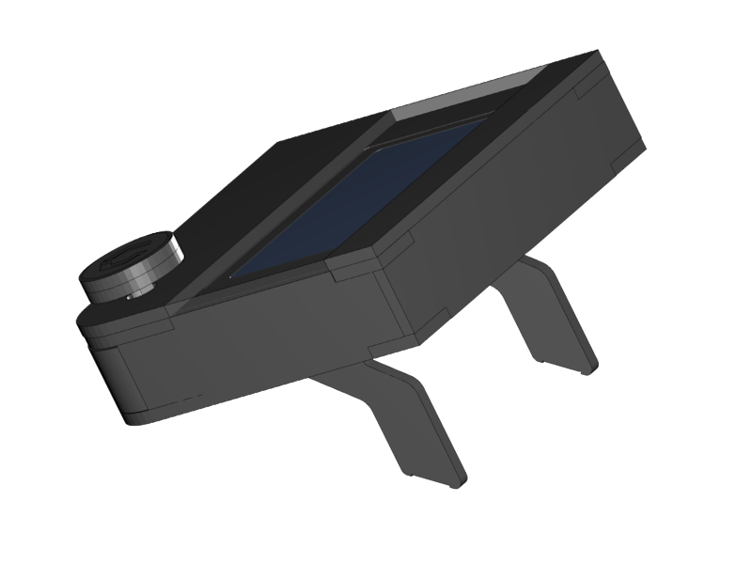
[picture p64: media/Section_6_0017.png]
1.2+||
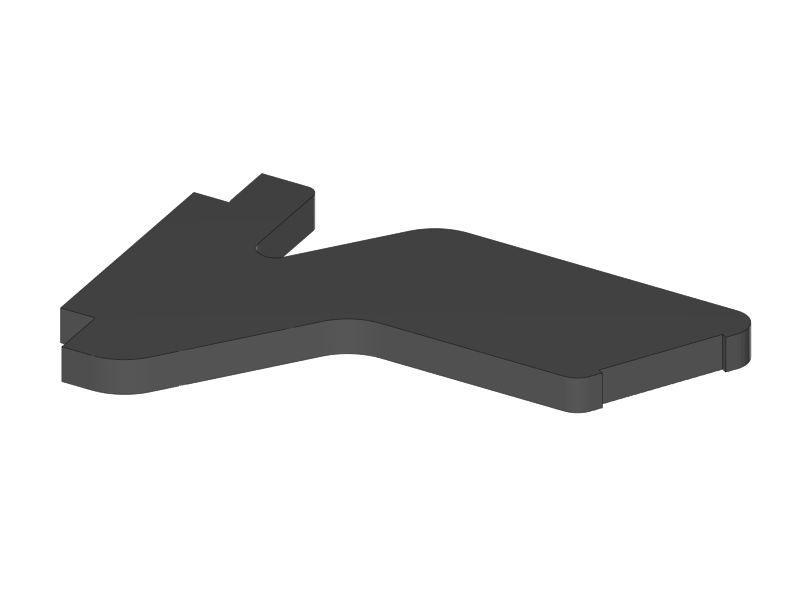
[picture p65: media/Section_1_0117.png]
 +
2x Display Case Foot
|====

* Push the Knob onto the shaft of the Display Controller.
* Push the feet into the casing. Apply plastic glue if necessary.

That's it for this section. In the next section you will start mounting the Y-Axis.

link:Section-2-Assembly-of-the-Y-Unit[Next]
