Pete30/3dtiskarna/Section-4-Cable-Lengths-RUMBA.asciidoc

.Cable Lengths
|=======================
|*Cable* |*Length (cm)*    
|X Endstop |60
|X Motor |53
|Y Endstop |60 
|Y Motor |55
|Z Endstop |65 
|Z Motor L |30 
|Z motor R |65 
|Extruder motor	|100 
|Extruder thermistor |110
|Extruder fan passive |110
|Extruder fan active |100
|Extruder HeatCartridge |100 
|Heatbed Power Cable |73
|Heatbed Thermistor |70	
|PSU-Power 12V |44
|PSU-Power 220V |29
|Timing Belt X |83,6
|Timing Belt Y |72,8
|=======================
