Pete30/3dtiskarna/_Sidebar.md

##i3 Berlin   
 [**1 Introduction**](https://github.com/laydrop/i3-Berlin/wiki/Section-1-Introduction)  
 [1.1](https://github.com/laydrop/i3-Berlin/wiki/Section-1.1-History): History  
 [1.2](https://github.com/laydrop/i3-Berlin/wiki/Section-1.2-Tools-and-Parts): Tools and Parts  
 [1.3](https://github.com/laydrop/i3-Berlin/wiki/Section-1.3-Preparing-Casings): Preparing the Casings  
  
[**2 Assembly of the Y-Unit**](https://github.com/laydrop/i3-Berlin/wiki/Section-2-Assembly-of-the-Y-Unit)  
 [2.1](https://github.com/laydrop/i3-Berlin/wiki/Section-2.1-Assembly-of-the-Y-Unit-Mounting-the-threaded-Rods-and-Power-Supply): Rods and Power Supply  
 [2.2](https://github.com/laydrop/i3-Berlin/wiki/Section-2.2-Assembly-of-the-Y-Unit-Mounting-the-Front-and-Back-Plate): Front- and Back- Plate  
 [2.3](https://github.com/laydrop/i3-Berlin/wiki/Section-2.3-Assembly-of-the-Y-Unit-Mounting-the-Y-Carriage-and-Timing-Belt): Mounting Y-Carriage and Belt  
  
[**3 Assembly of the XZ-Unit**](https://github.com/laydrop/i3-Berlin/wiki/Section-3-Assembly-of-the-XZ-Unit)  
 [3.1](https://github.com/laydrop/i3-Berlin/wiki/Section-3.1-Assembly-of-the-XZ-Unit-Mounting-the-X-Axis): Mounting the X-Axis  
 [3.2](https://github.com/laydrop/i3-Berlin/wiki/Section-3.2-Assembly-of-the-XZ-Unit-Mounting-the-Z-Axis): Mounting the Z-Axis  
 [3.3](https://github.com/laydrop/i3-Berlin/wiki/Section-3.3-Assembly-of-the-XZ-Unit-Mounting-the-Timing-Belt): Mounting the Timing Belt  
 [3.4](https://github.com/laydrop/i3-Berlin/wiki/Section-3.4-Assembling-the-Extruder): Assembling the Extruder  
  
[**4 Wiring**](https://github.com/laydrop/i3-Berlin/wiki/Section-4-Wiring)  
 [4.1](https://github.com/laydrop/i3-Berlin/wiki/Section-4.1-Wiring-the-Power-Supply): Wiring the Power Supply  
 [4.2](https://github.com/laydrop/i3-Berlin/wiki/Section-4.2-Wiring-the-Z-Unit): Wiring the Z-Unit  
 [4.3](https://github.com/laydrop/i3-Berlin/wiki/Section-4.3-Wiring-the-Y-Unit): Wiring the Y-Unit  
 [4.4](https://github.com/laydrop/i3-Berlin/wiki/Section-4.4-Wiring-the-X-Axis): Wiring the X-Axis  
 [4.5](https://github.com/laydrop/i3-Berlin/wiki/Section-4.5-Gluing-the-Endstop-Magnets): Gluing the Endstop Magnets  
 [4.6](https://github.com/laydrop/i3-Berlin/wiki/Section-4.6-Uploading-Firmware): Uploading Firmware  
 [4.7](https://github.com/laydrop/i3-Berlin/wiki/Section-4.7-Wiring-the-Extruder): Wiring the Extruder  
 [4.8](https://github.com/laydrop/i3-Berlin/wiki/Section-4.8-Mounting-the-Heatbed): Mounting the Heatbed  
  
[Cable Lengths Rumba](https://github.com/laydrop/i3-Berlin/wiki/Section-4-Cable-Lengths-RUMBA)  
  
[**5 Calibration**](https://github.com/laydrop/i3-Berlin/wiki/Section-5-Calibration)  
 [5.1](https://github.com/laydrop/i3-Berlin/wiki/Section-5.1-Testing-Functionality): Testing Functionality  
 [5.2](https://github.com/laydrop/i3-Berlin/wiki/Section-5.2-Calibrating-the-Y-Axis): Calibrating the Y Axis  
 [5.3](https://github.com/laydrop/i3-Berlin/wiki/Section-5.3-Calibrate-the-X-Axis): Calibrating the X Axis  
 [5.4](https://github.com/laydrop/i3-Berlin/wiki/Section-5.4-Calibrating-the-Print-Platform): Calibrating the Print Platform  
  
[**6 Printing**](https://github.com/laydrop/i3-Berlin/wiki/Section-6-Printing)  
 [6.1](https://github.com/laydrop/i3-Berlin/wiki/Section-6.1-FilamentHolder): Filament Holder  
 [6.2](https://github.com/laydrop/i3-Berlin/wiki/Section-6.2-Cura): Cura  
 [6.3](https://github.com/laydrop/i3-Berlin/wiki/Section-6.3-Kisslicer): Kisslicer  
 [6.4](https://github.com/laydrop/i3-Berlin/wiki/Section-6.4-Dual-Printing): Dual Printing
