Pete30/3dtiskarna/media/Section_1_0003.png

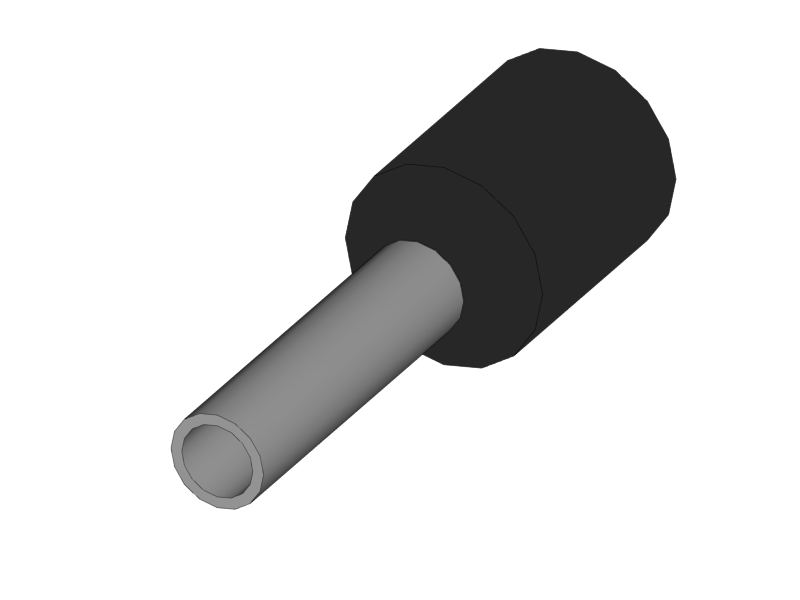
media/Section_1_0003.png
