Pete30/3dtiskarna/media/Section_1_0004.png

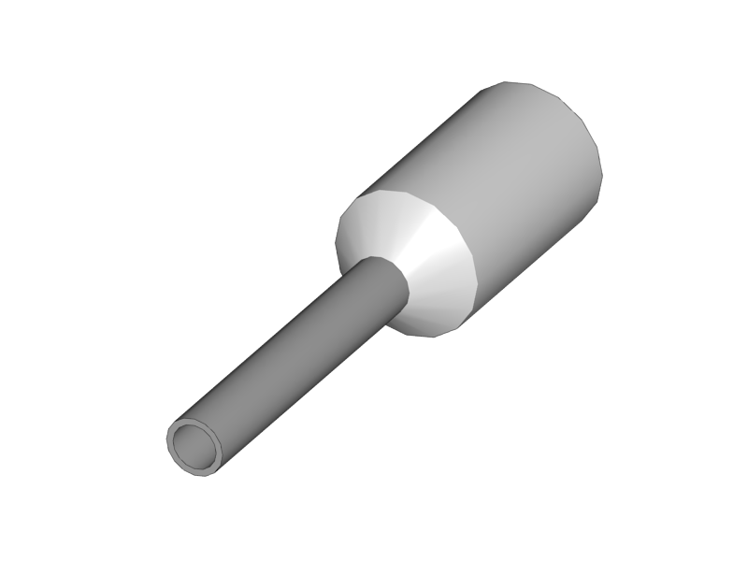
media/Section_1_0004.png
