Pete30/3dtiskarna/media/Section_1_0038.png

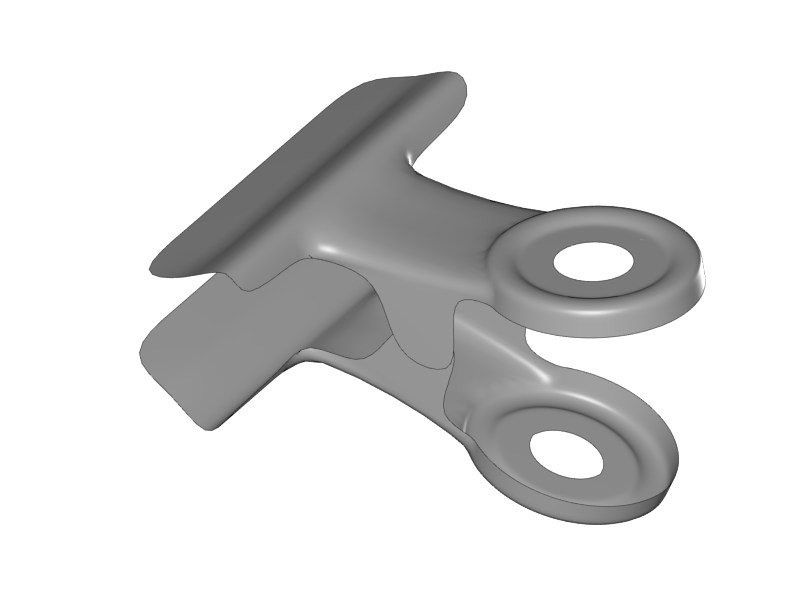
media/Section_1_0038.png
