Pete30/3dtiskarna/media/Section_1_0039.png

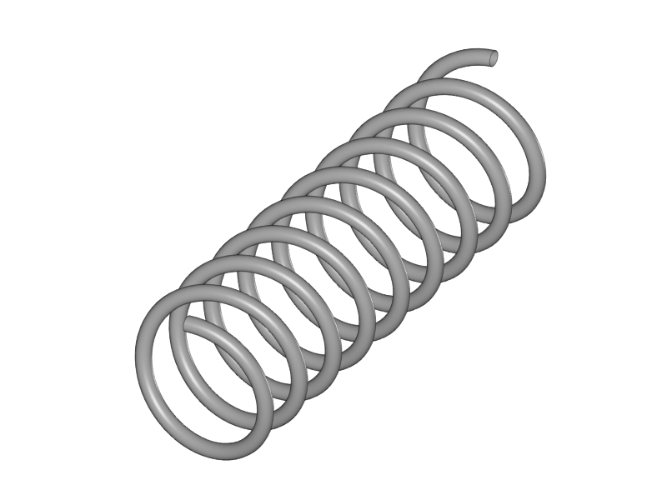
media/Section_1_0039.png
