Pete30/3dtiskarna/media/Section_1_0040.png

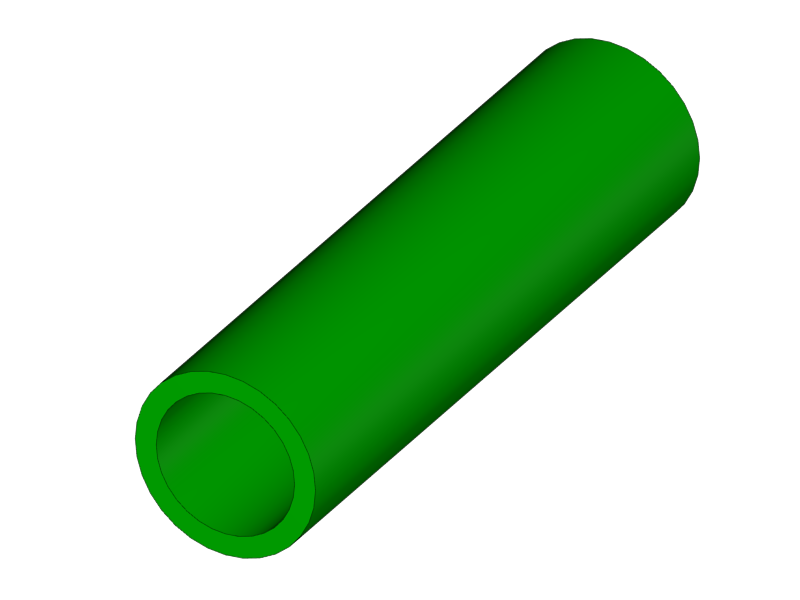
media/Section_1_0040.png
