Pete30/3dtiskarna/media/Section_1_0043.png

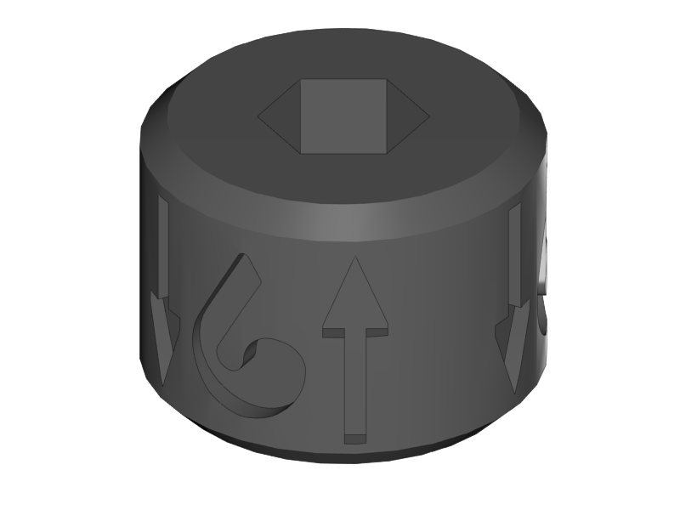
media/Section_1_0043.png
