Pete30/3dtiskarna/media/Section_1_0046.png

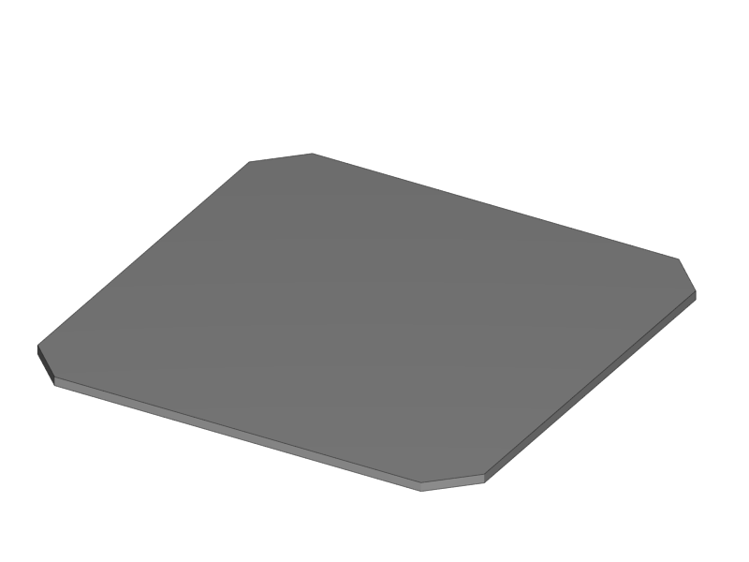
media/Section_1_0046.png
