Pete30/3dtiskarna/media/Section_1_0047.png

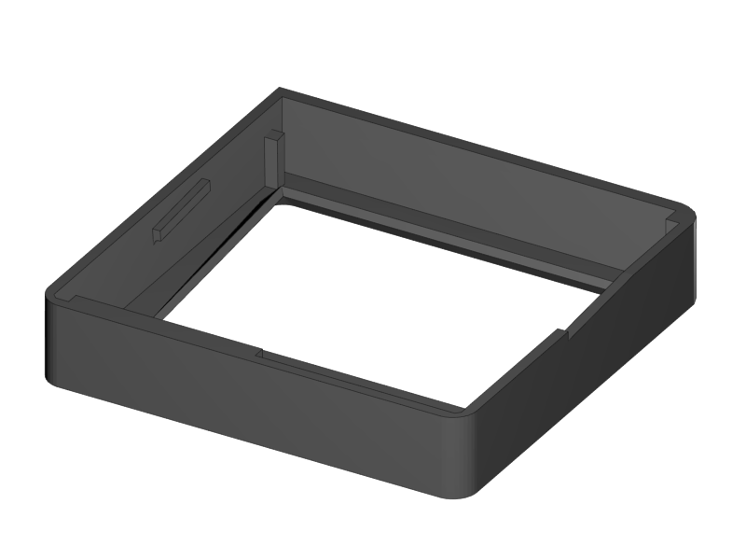
media/Section_1_0047.png
