Pete30/3dtiskarna/media/Section_1_0048.png

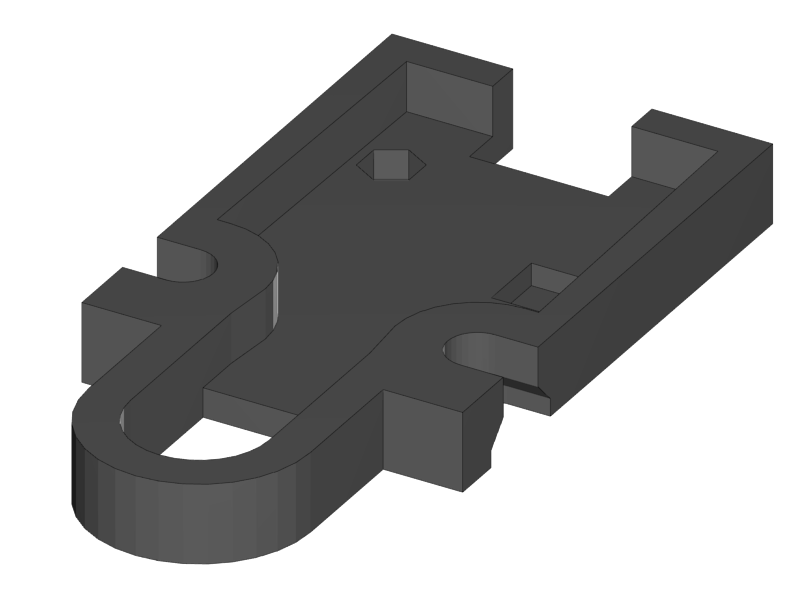
media/Section_1_0048.png
