Pete30/3dtiskarna/media/Section_1_0051.png

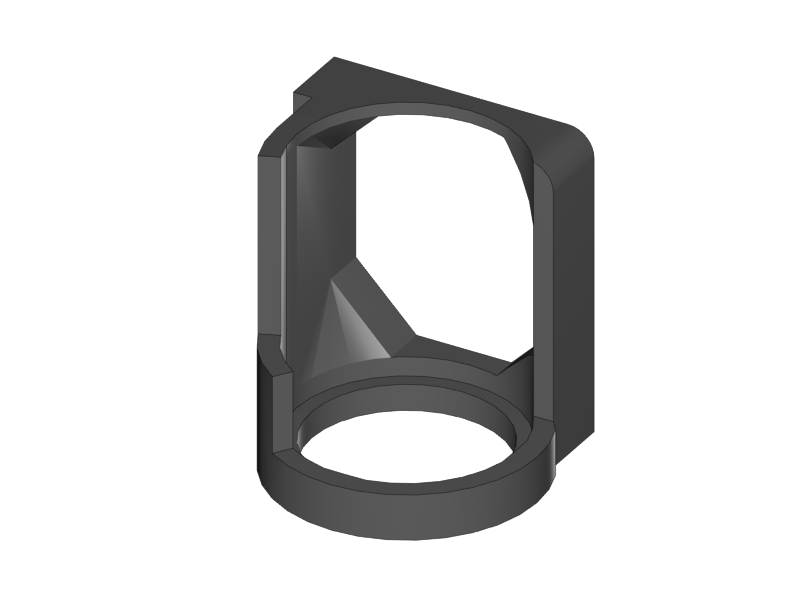
media/Section_1_0051.png
