Pete30/3dtiskarna/media/Section_1_0052.png

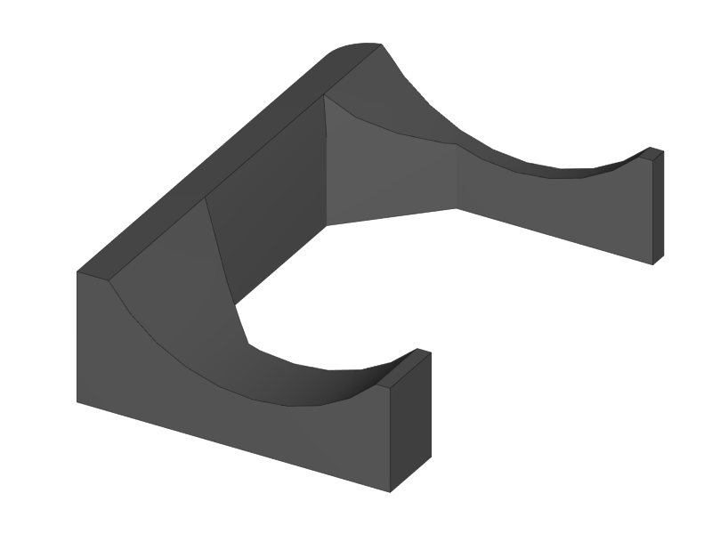
media/Section_1_0052.png
