Pete30/3dtiskarna/media/Section_1_0055.png

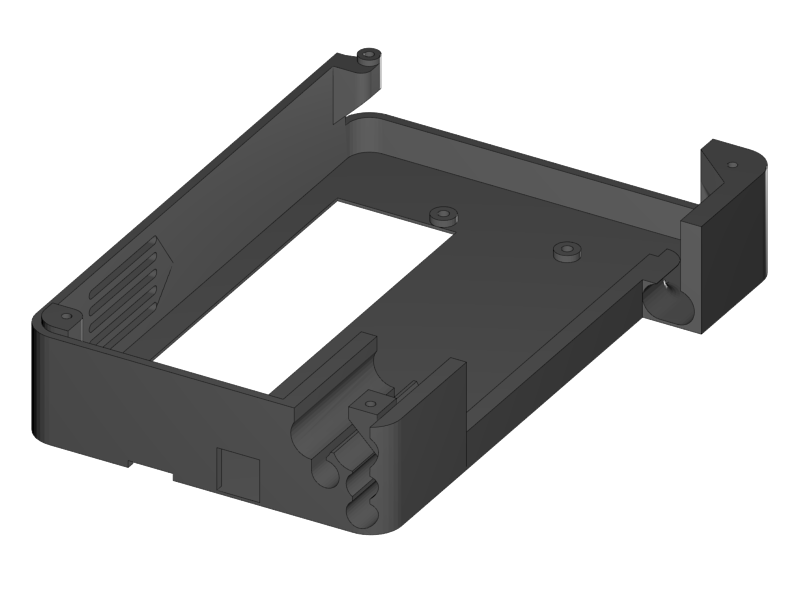
media/Section_1_0055.png
