Pete30/3dtiskarna/media/Section_1_0056.png

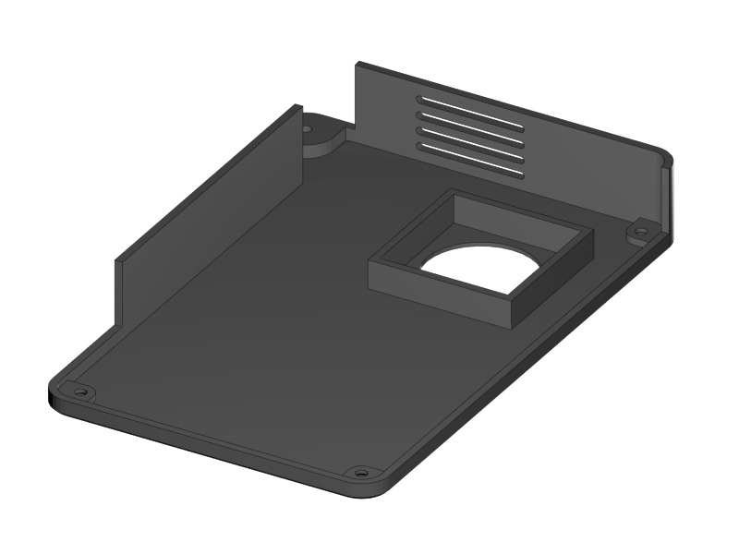
media/Section_1_0056.png
