Pete30/3dtiskarna/media/Section_1_0057.png

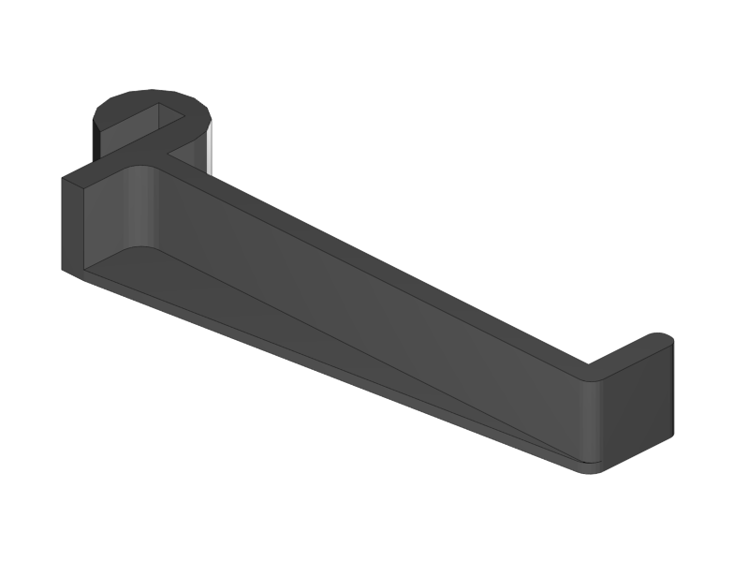
media/Section_1_0057.png
