Pete30/3dtiskarna/media/Section_1_0075.png

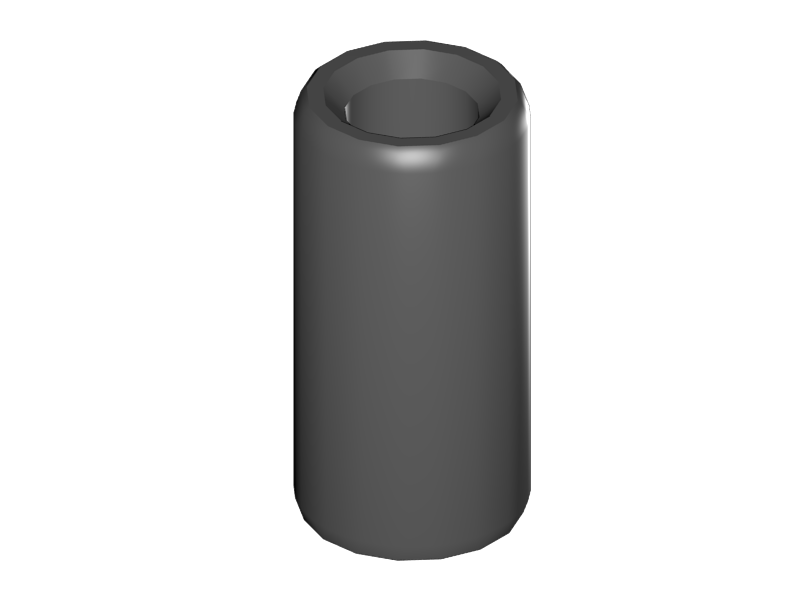
media/Section_1_0075.png
