Pete30/3dtiskarna/media/Section_1_0078.png

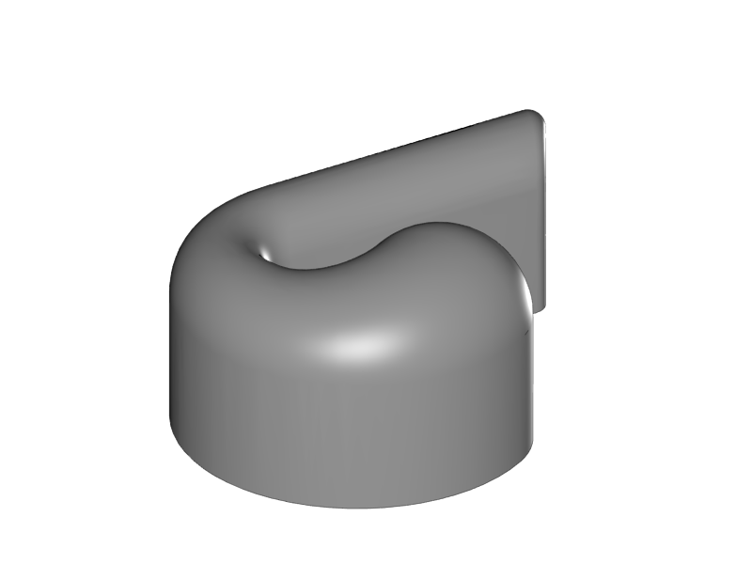
media/Section_1_0078.png
