Pete30/3dtiskarna/media/Section_1_0086.png

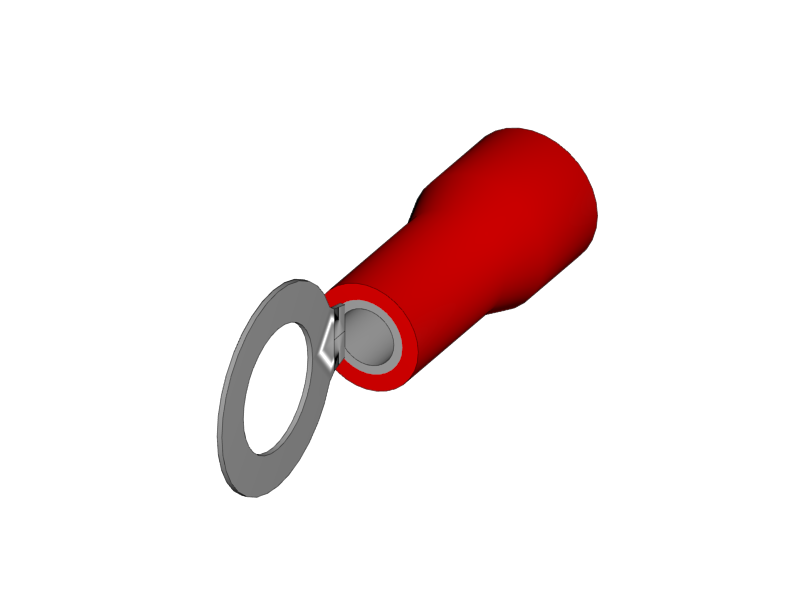
media/Section_1_0086.png
