Pete30/3dtiskarna/media/Section_1_0088.png

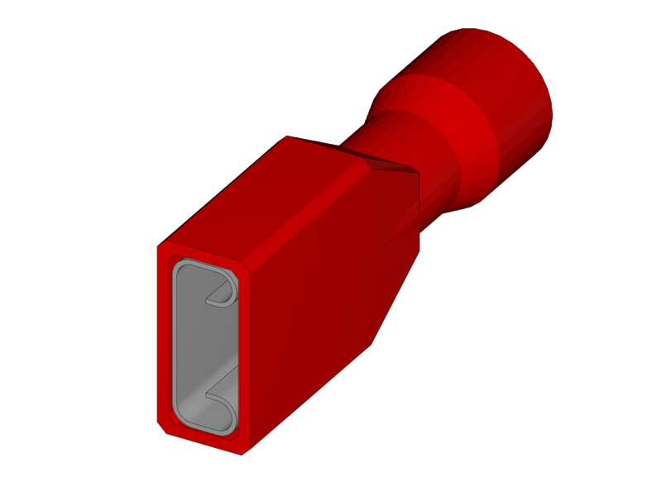
media/Section_1_0088.png
