Pete30/3dtiskarna/media/Section_1_0090.png

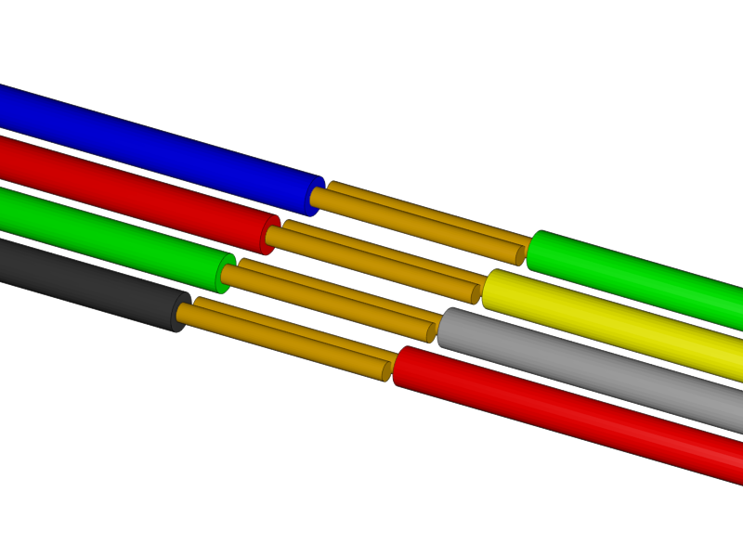
media/Section_1_0090.png
