Pete30/3dtiskarna/media/Section_4_0004.png

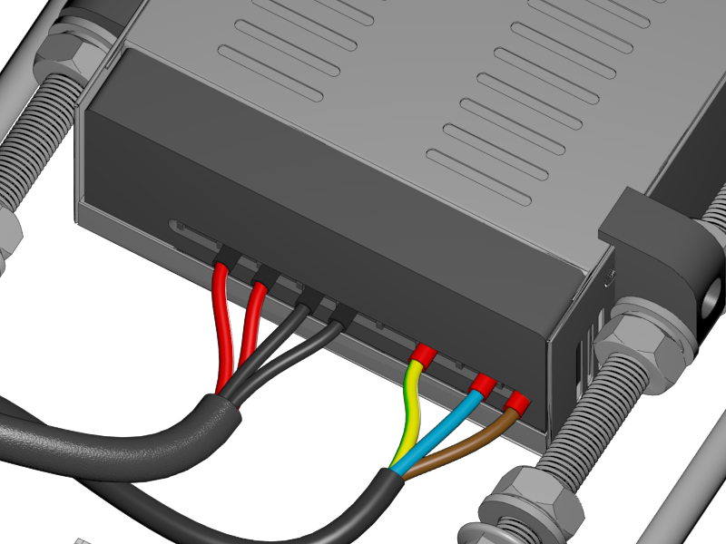
media/Section_4_0004.png
