Pete30/3dtiskarna/media/Section_5_0013.png

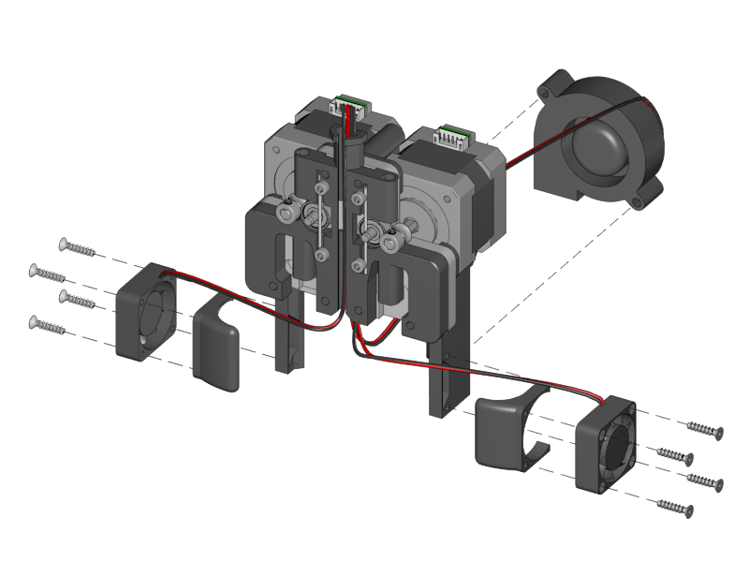
media/Section_5_0013.png
