Pete30/3dtiskarna/media/Section_5_0014.png

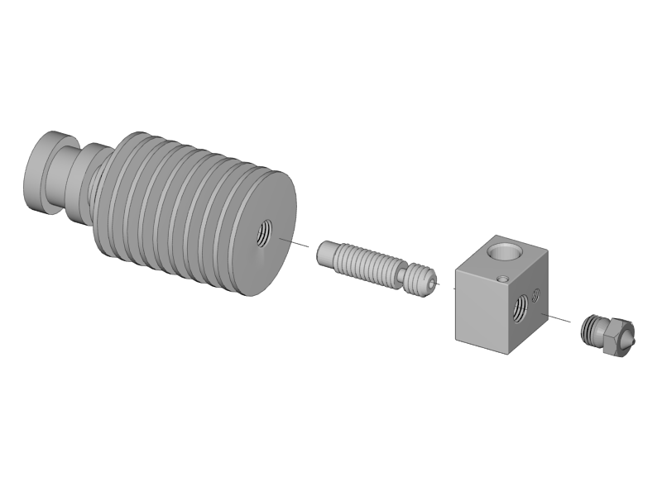
media/Section_5_0014.png
