Pete30/3dtiskarna/media/Section_5_0015.png

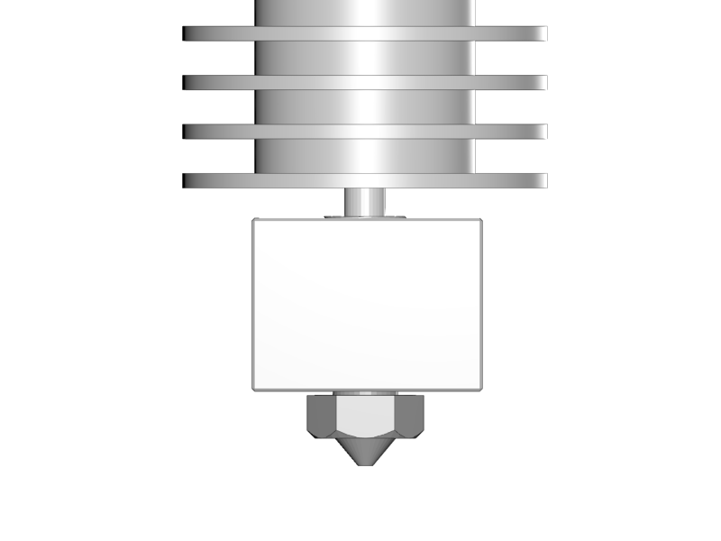
media/Section_5_0015.png
