Pete30/3dtiskarna/media/Section_5_0020.png

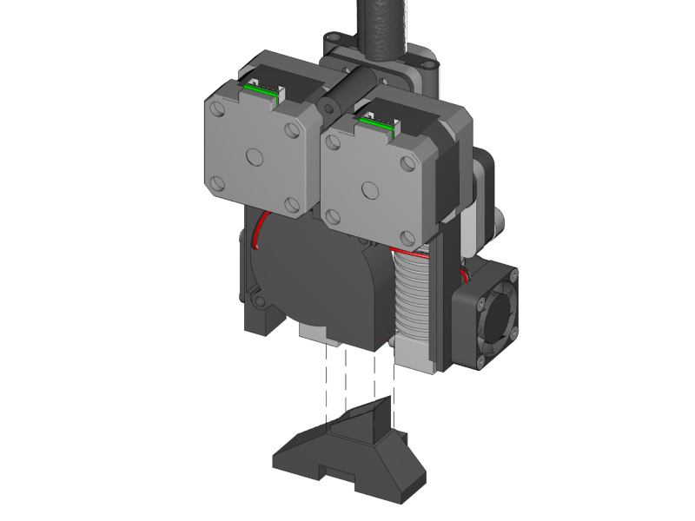
media/Section_5_0020.png
