Pete30/3dtiskarna/media/Section_5_0021.png

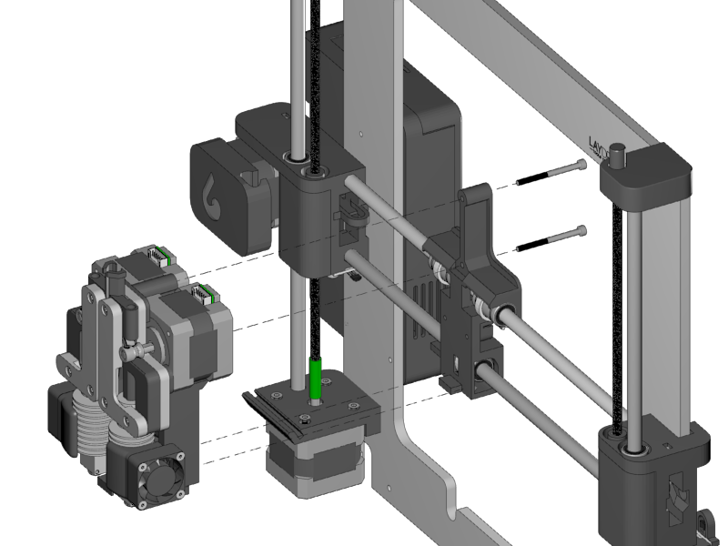
media/Section_5_0021.png
