Pete30/3dtiskarna/Section-1.2-Tools-and-Parts.asciidoc

link:Section-1.3-Preparing-Casings[Next]

.Tools
|=======================
|   Normal Laptop with OSX, Linux or Windows 
|  Open End Spanners sized 17mm/15mm/8mm 
|   Torx 8 Screwdriver 
|   Allen keys 1.5, 2.5, 3.0 and 6.0 mm
|  Utility Knife
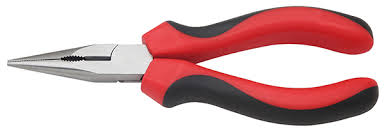
[picture p96: staticmedia/Longnose.jpeg]
|  Long Nose Pliers
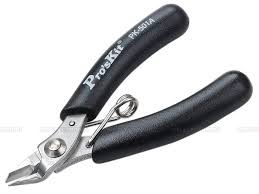
[picture p97: staticmedia/clipping.jpeg]
|  Clipping Pliers
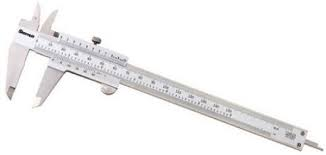
[picture p98: staticmedia/Calipers.jpeg]
|  Calipers
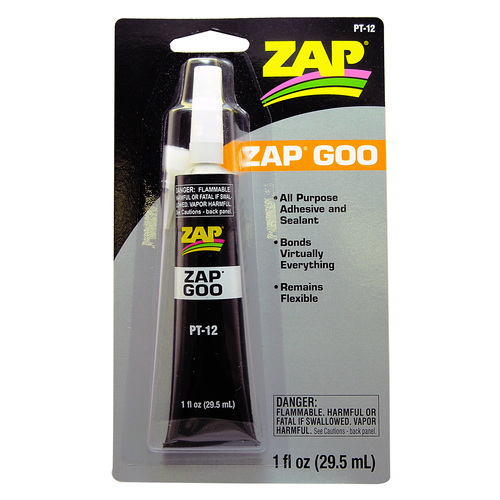
[picture p99: staticmedia/ZapGlue.jpg]
|  Zap Goo PT12 or UHU Allplast '*'
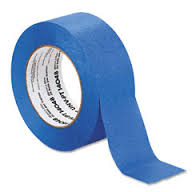
[picture p100: staticmedia/BlueScotch.jpeg]
|  (Blue) Painters Tape '*'
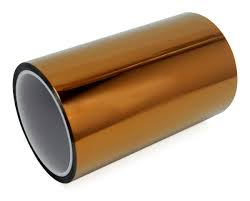
[picture p101: staticmedia/kapton.jpeg]
|  Kapton '*'
|=======================

'*' Included in the Workshop, NOT included in the Kit.

This is the list of all the parts you will find in the box if you bought a kit or workshop through http://www.i3berlin.com/[i3Berlin.com]. A full Bill of Materials can be found https://github.com/laydrop/i3_Berlin/blob/master/BOM.csv[here]

Tip: you can enlarge the images by right click and then view the image. 

.Acrylic Parts	
|=======================
|□  +
1x RUMBA Case Base |□  +
1x RUMBA Case Bottom |□  +
1x RUMBA Case Left Side	|□  +
1x RUMBA Case Top |□  +
1x RUMBA Case Right Side 
|□  +
1x Case Lid |□  +
1x Display Case Base |□  +
1x Display Case Left |□  +
1x Display Case Back |□  +
1x Display Case Front	
|□  +
1x Display Case Right |□  +
1x Display Case Top Base |□  +
1x Display Case Top Bottom |□  +
1x Display Case Window |□  +
1x Display Case Window	
|□  +
1x Display Case Top |□  +
4x Display spacer |□  +
1x Knob Base |□  +
1x Knob Support |□  +
1x Knob Rim	
|□  +
1x Knob Cushion |□  +
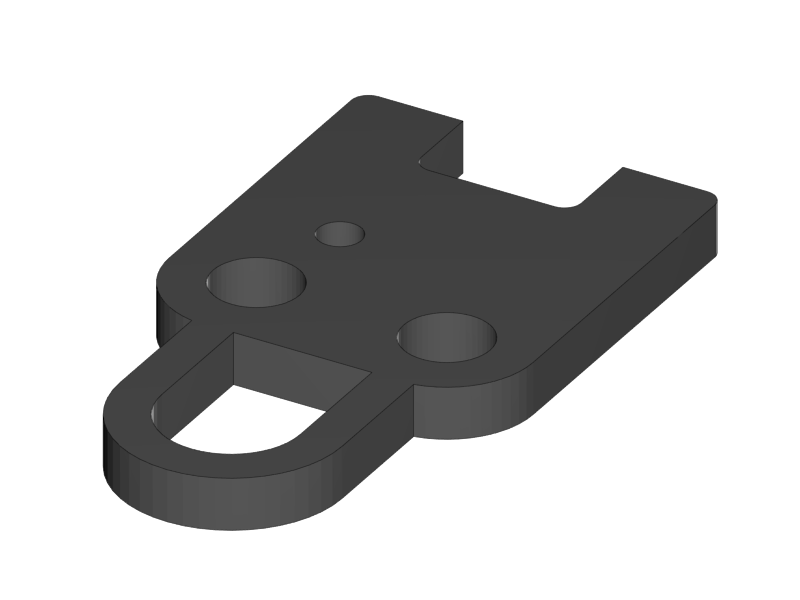
[picture p102: media/Section_1_0108.png]
2x Display Case Foot |□  +
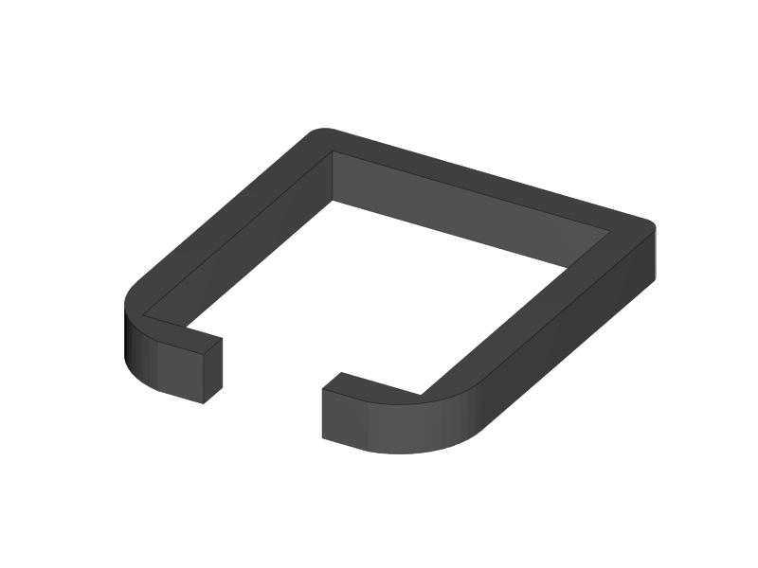
[picture p103: media/Section_1_0109.png]
3x End-stop Cover Top |□  +
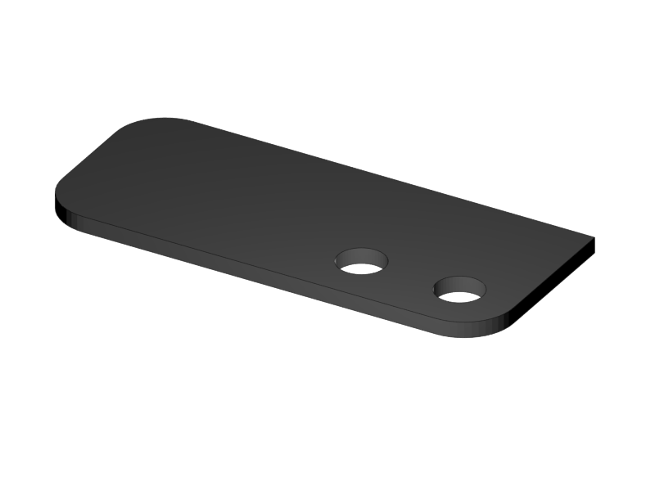
[picture p104: media/Section_1_0110.png]
3x End-stop Cover Rim |□  +
1x X-Motor Cover Acrylic
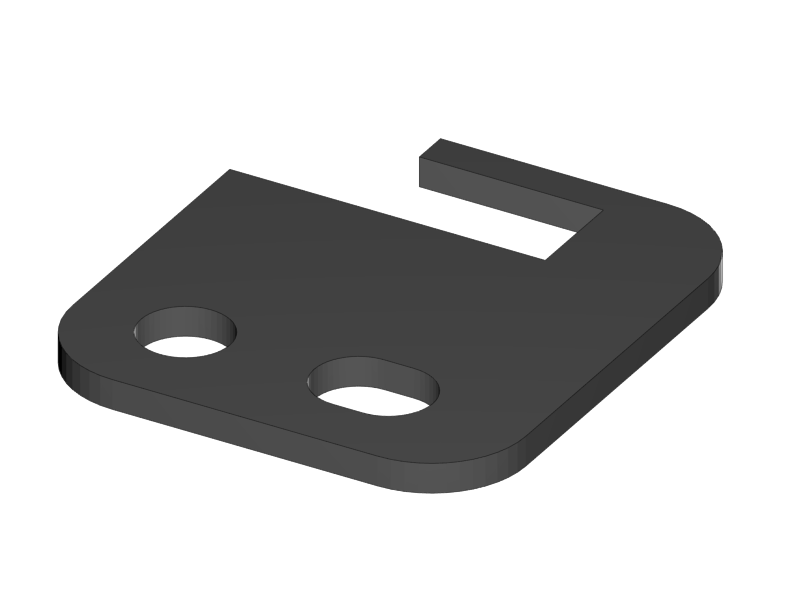
[picture p105: media/Section_1_0111.png]
|□  +
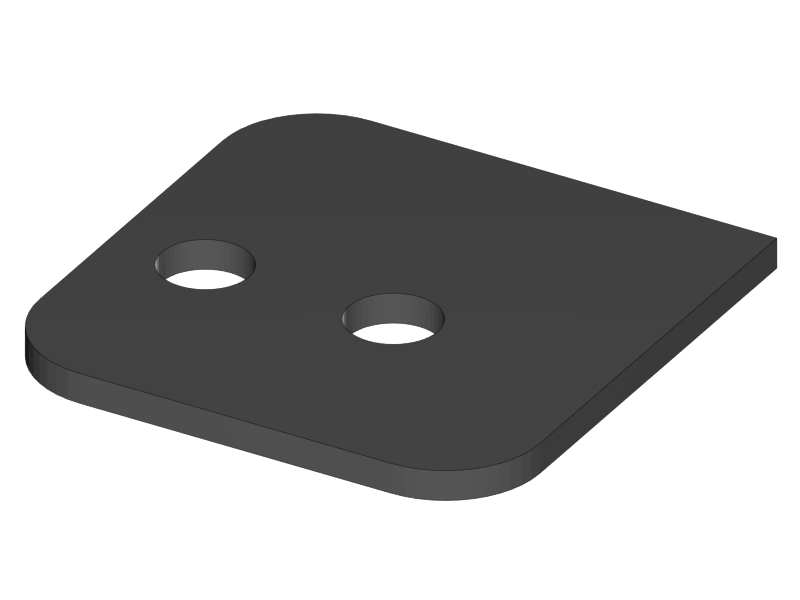
[picture p106: media/Section_1_0112.png]
1x X-Idler Cover Acrylic |□  +
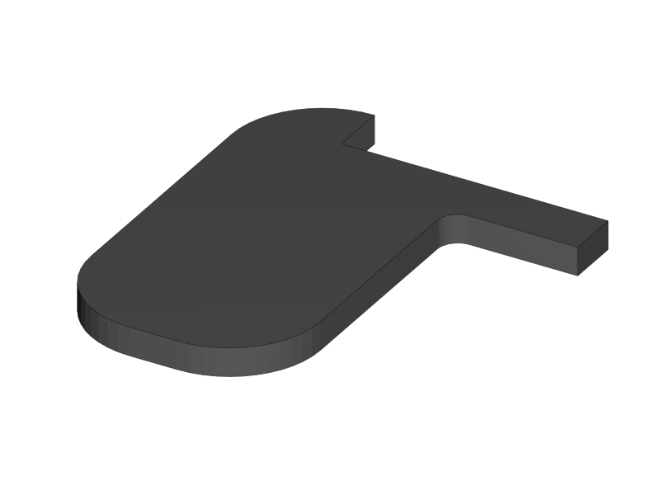
[picture p107: media/Section_1_0113.png]
2x Z-Motor Cover Acrylic |□  +
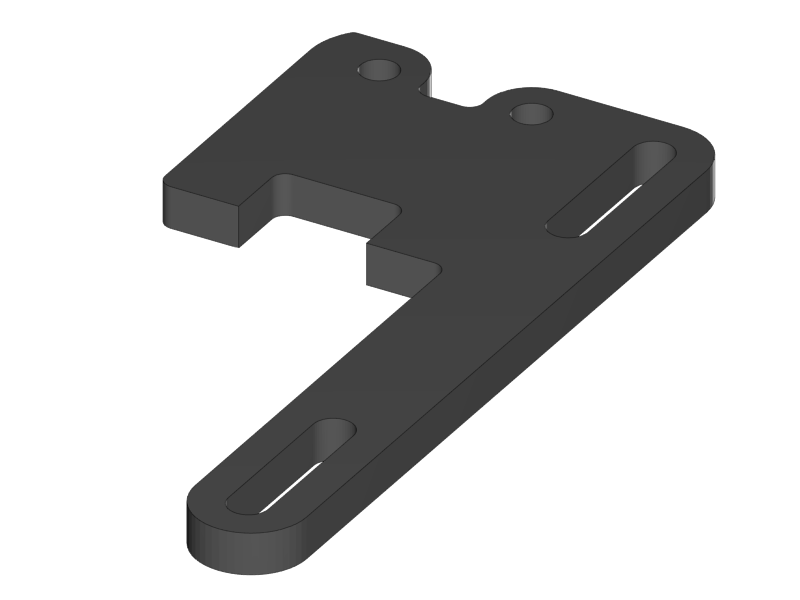
[picture p108: media/Section_1_0074.png]
2x Z-Top Cover Acrylic |□  +
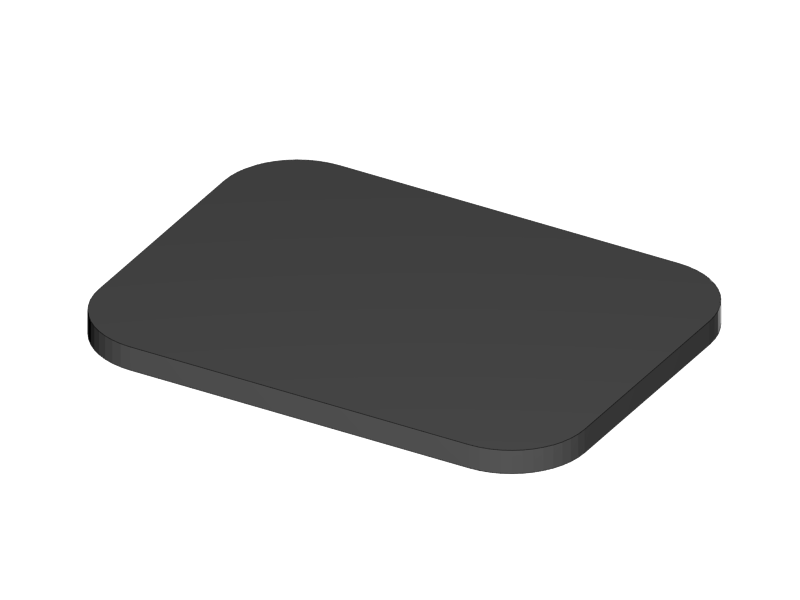
[picture p109: media/Section_1_0145.png]
1x Z-Endstop Holder |□  +
1x Cable Holder Cover
|□  +
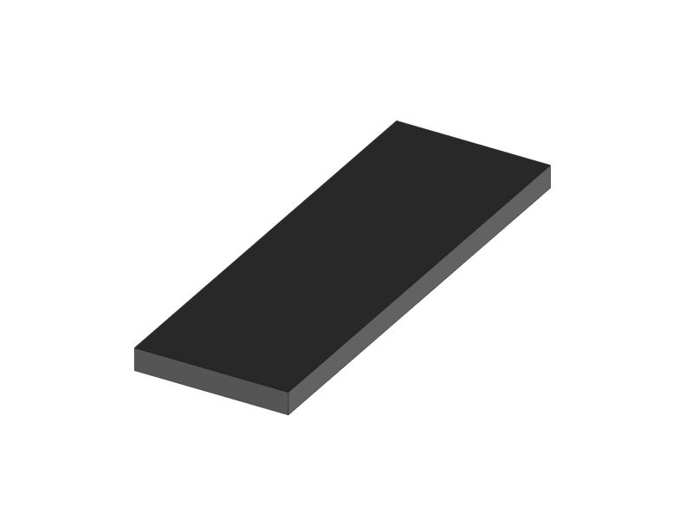
[picture p110: media/Section_1_0149.png]
1x RUMBA Case Inlet Side |□  +
2x X-Idler Cover |   |   |   
|=======================

.Printed Parts Casings
|=======================
|□  +
1x RUMBA Case Cable Inlet |□  +
2x RUMBA Case Corner |□  +
1x RUMBA Case FanHolder	|□  +
1x Display Case Corner	
|=======================

.Printed Parts Y	
|=======================
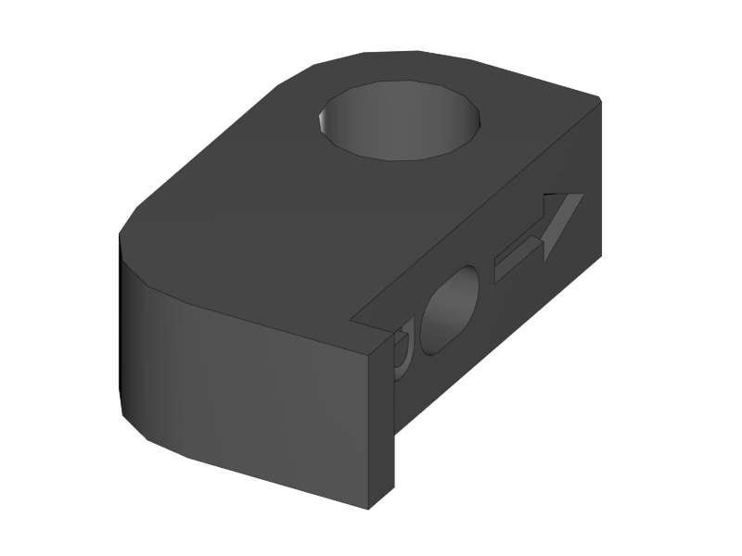
[picture p111: media/Section_1_0069.png]
|□  +
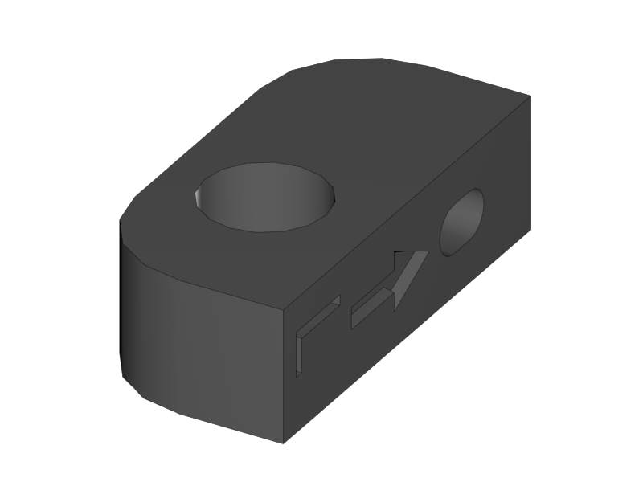
[picture p112: media/Section_1_0068.png]
1x Y-Middle Right |□  +
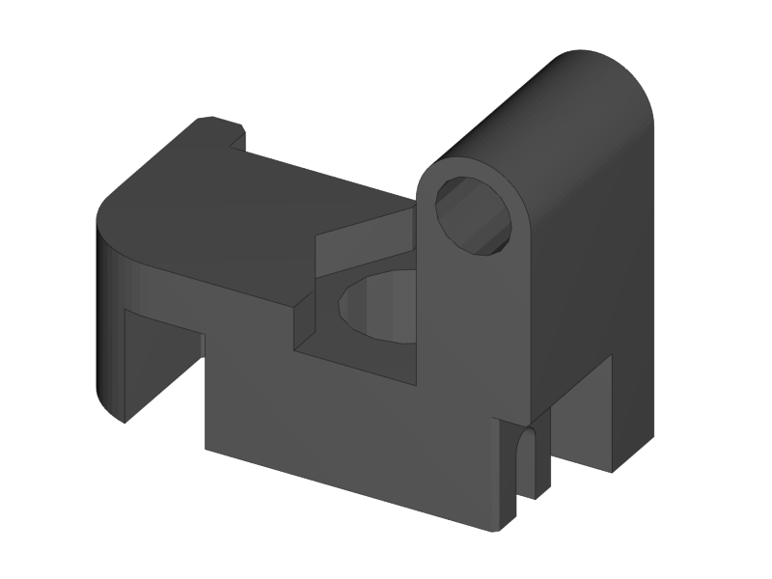
[picture p113: media/Section_1_0065.png]
1x Y-Middle Left |□  +
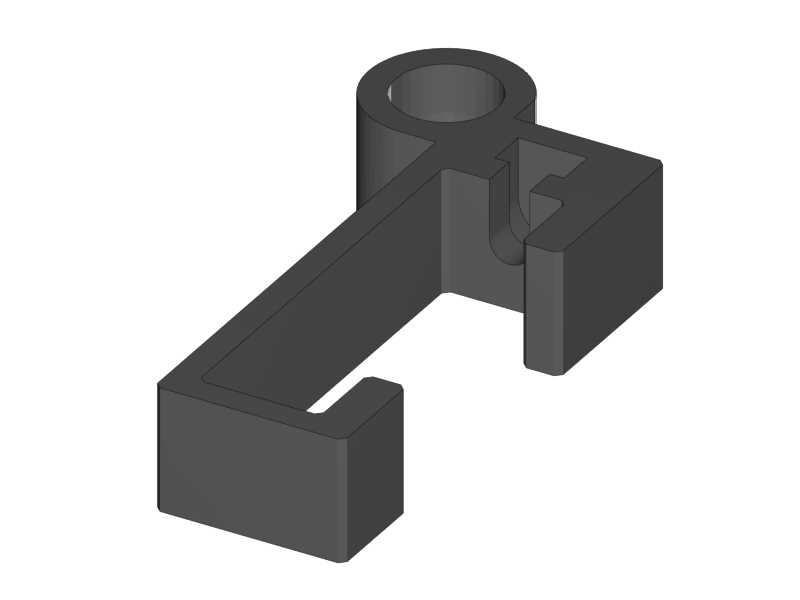
[picture p114: media/Section_1_0067.png]
1x Y-Front Left |□  +
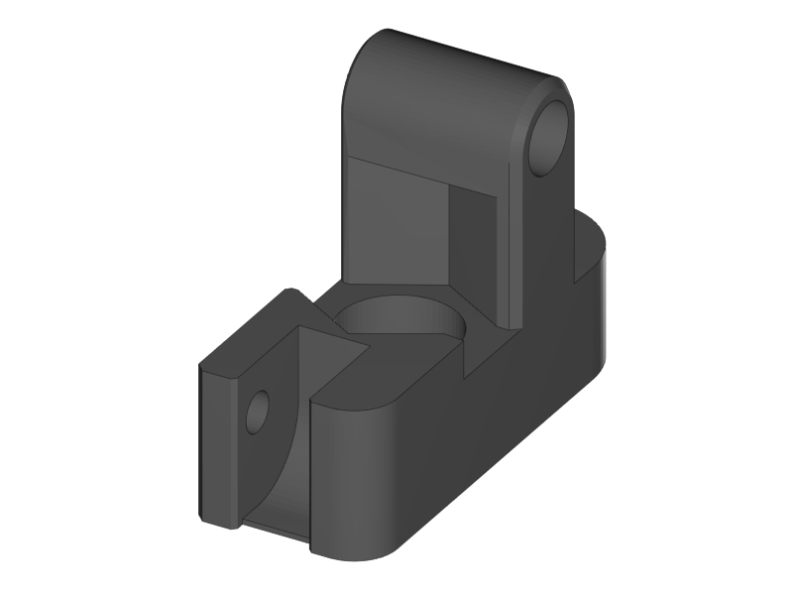
[picture p115: media/Section_1_0066.png]
1x Y-Height Adjuster |□  +
1x Y-Front Right
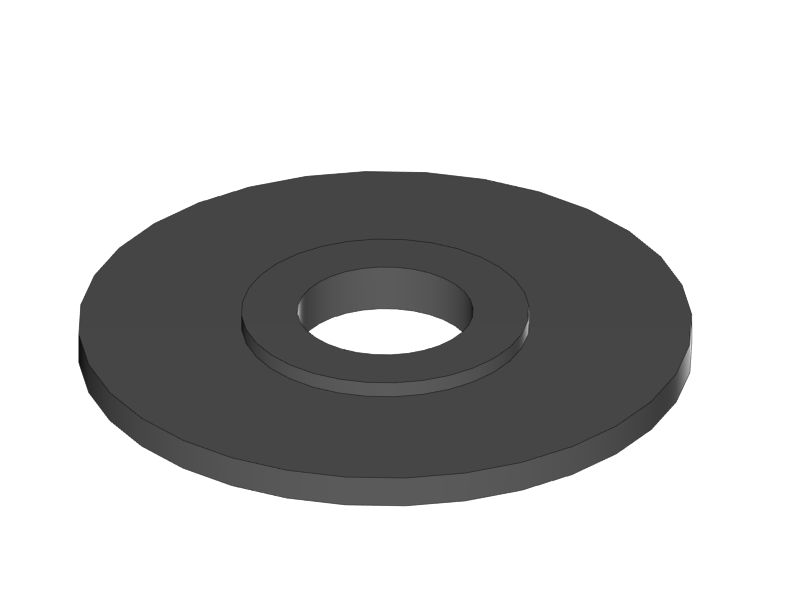
[picture p116: media/Section_1_0044.png]
|□  +
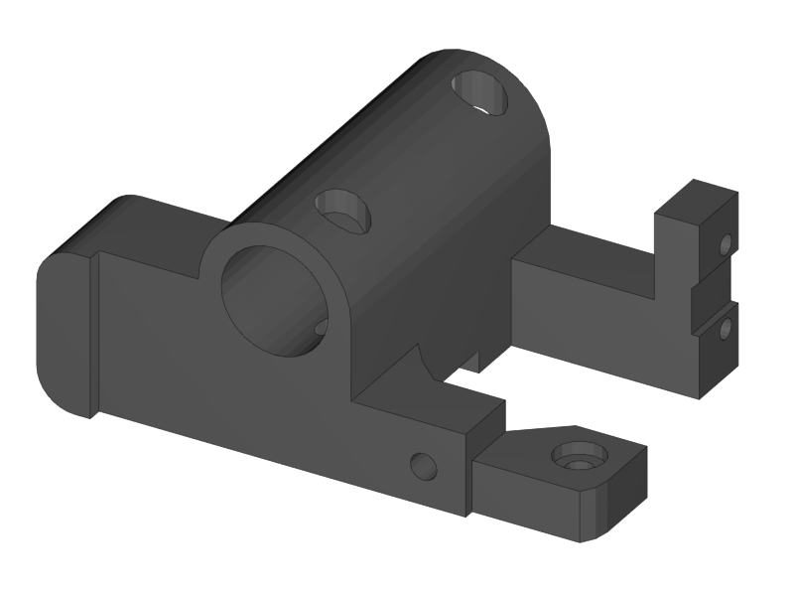
[picture p117: media/Section_1_0070.png]
2x Belt Guiding Disk|□  +
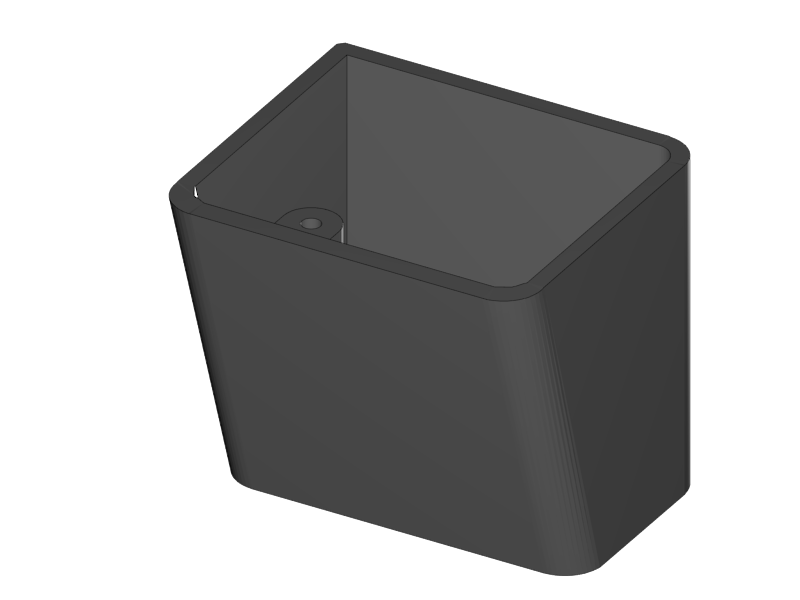
[picture p118: media/Section_1_0053.png]
1x Y-Motor mount |□  +
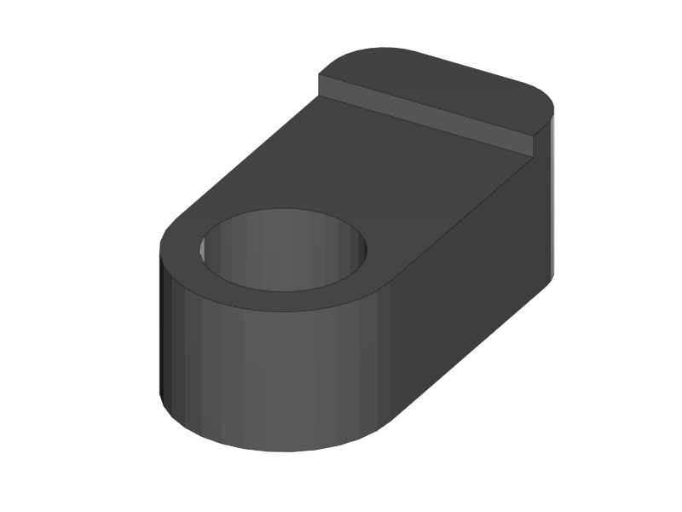
[picture p119: media/Section_1_0064.png]
1x Power Connector Cover |□  +
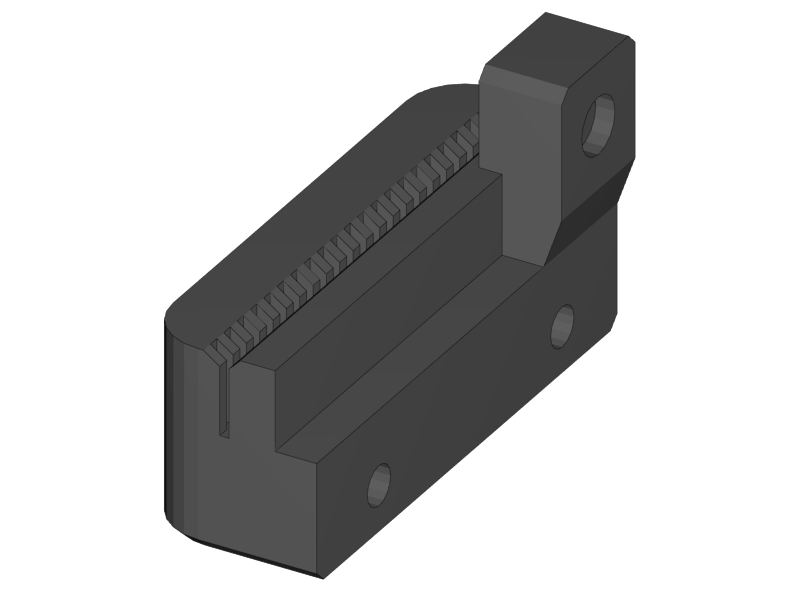
[picture p120: media/Section_1_0071.png]
1x Y-Back Left |□  +
1x Y-Teeth
|=======================

.Printed Parts XZ	
|=======================
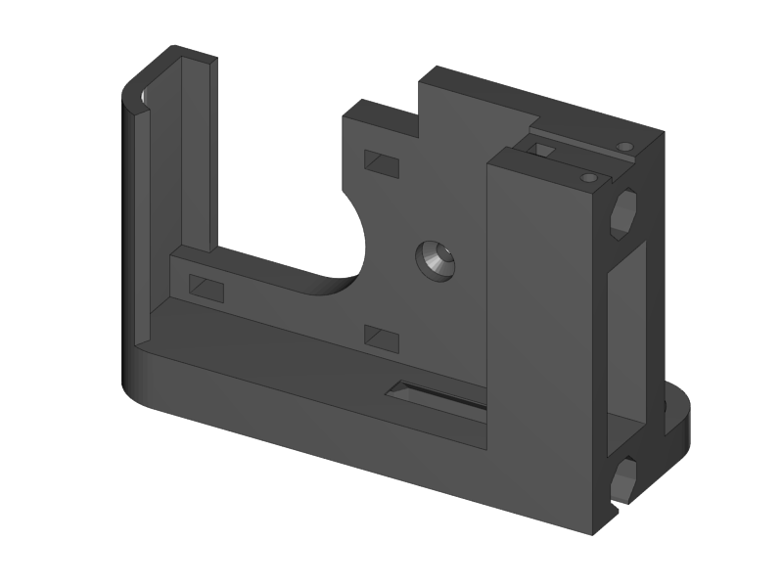
[picture p121: media/Section_1_0060.png]
|□  +
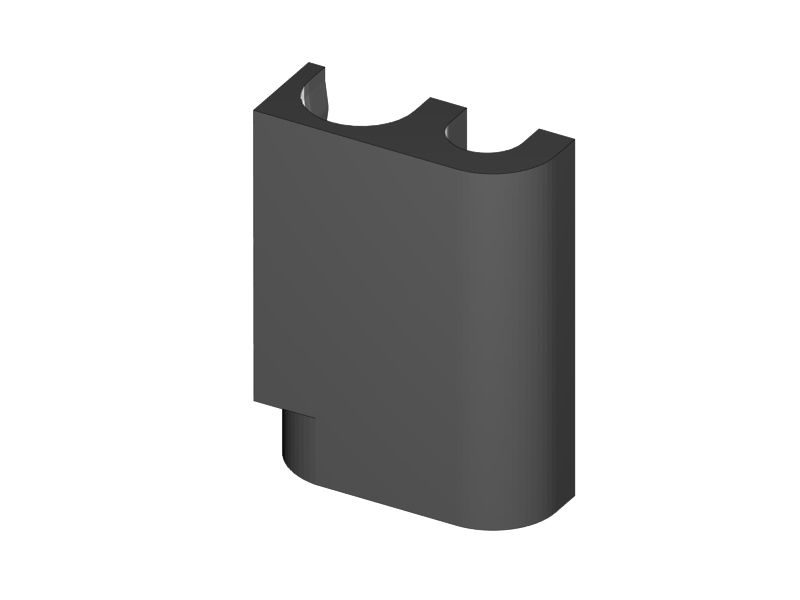
[picture p122: media/Section_1_0061.png]
1x X-Motor |□  +
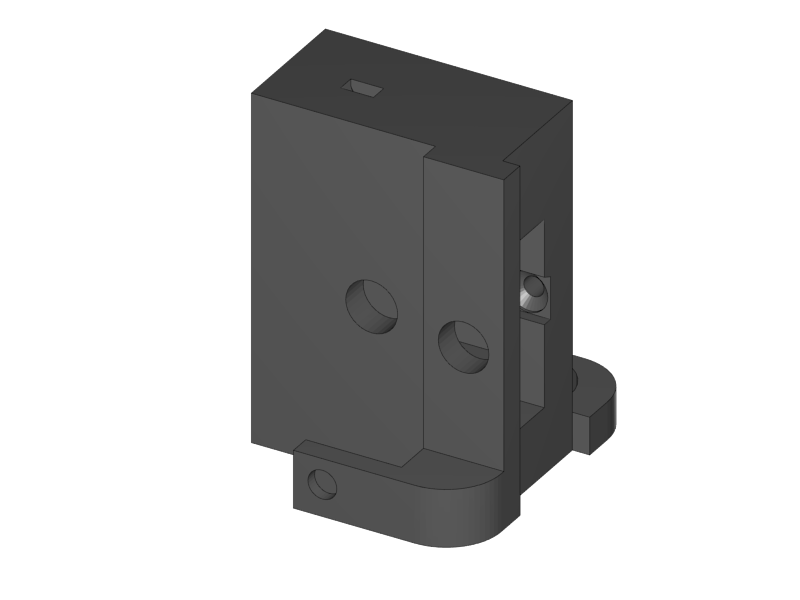
[picture p123: media/Section_1_0059.png]
1x X-Bearing Holder Left |□  +
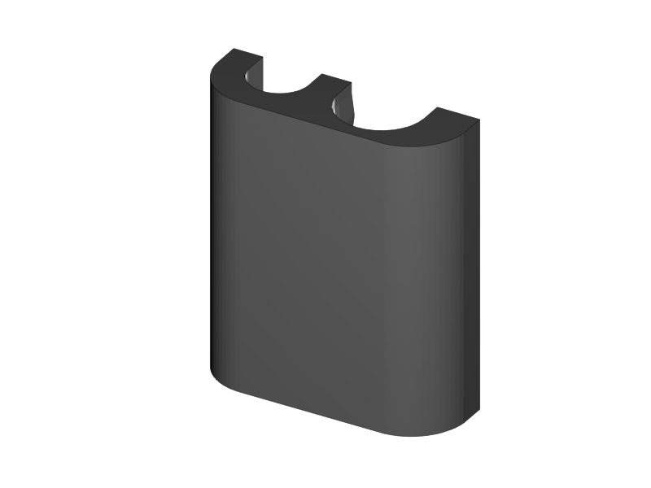
[picture p124: media/Section_1_0062.png]
1x X-Idler |□  +
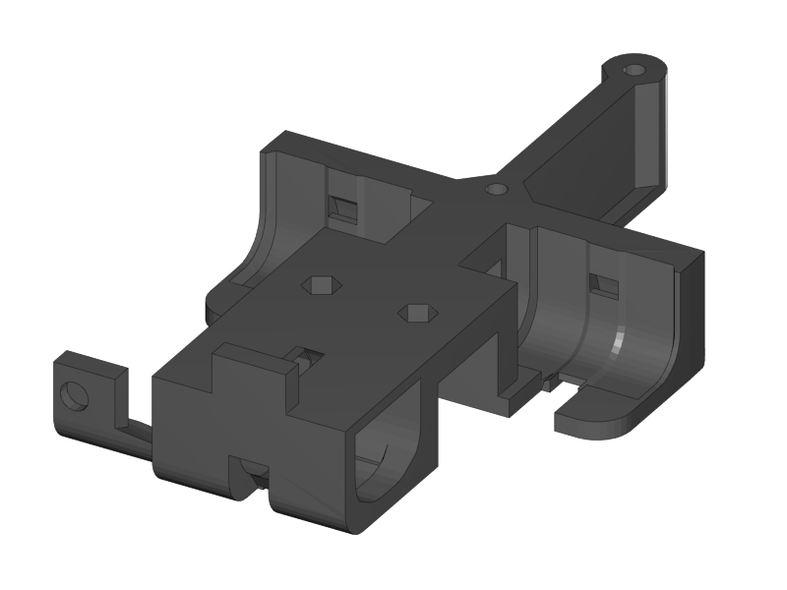
[picture p125: media/Section_1_0058.png]
1x X-Bearing Holder Right |□  +
1x X-Carriage
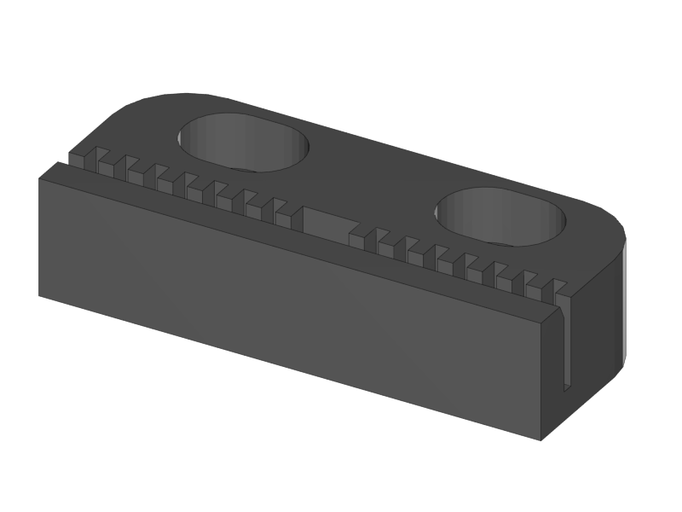
[picture p126: media/Section_1_0063.png]
|□  +
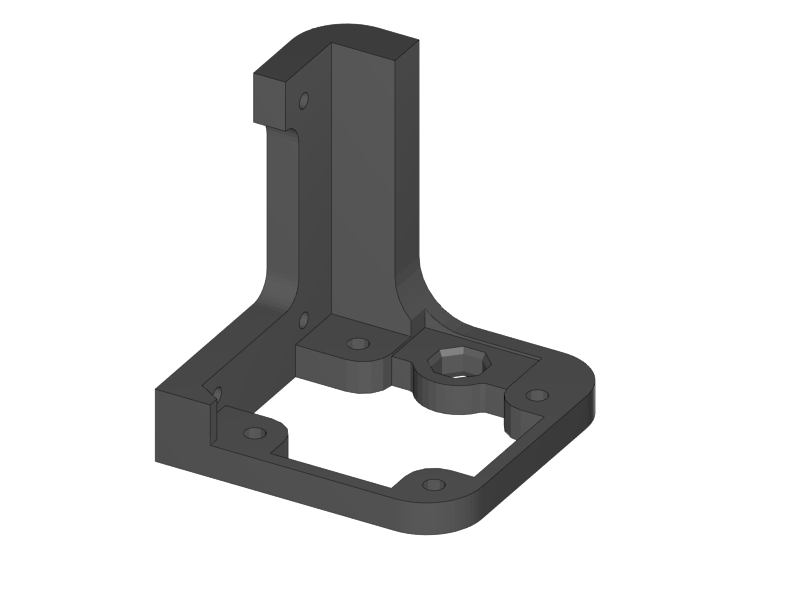
[picture p127: media/Section_1_0072.png]
1x X-Teeth |□  +
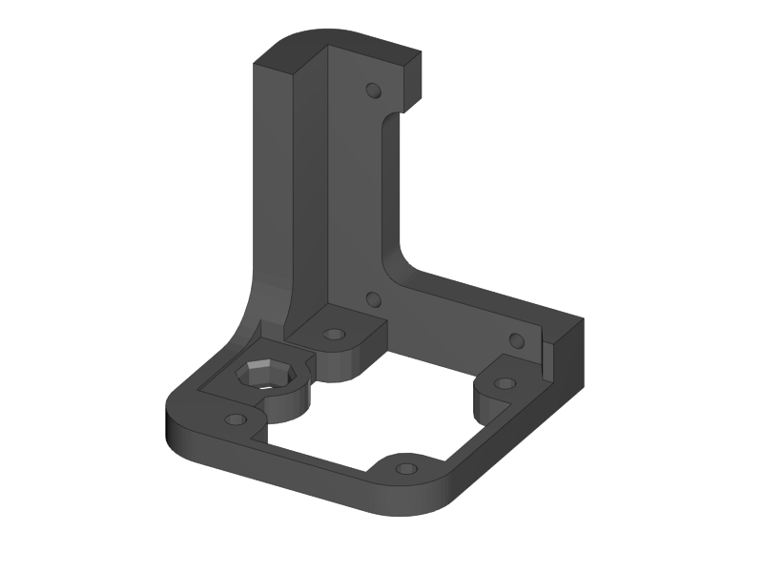
[picture p128: media/Section_1_0073.png]
1x Z-Motor Left |□  +
1x Z-Motor Right |□  +
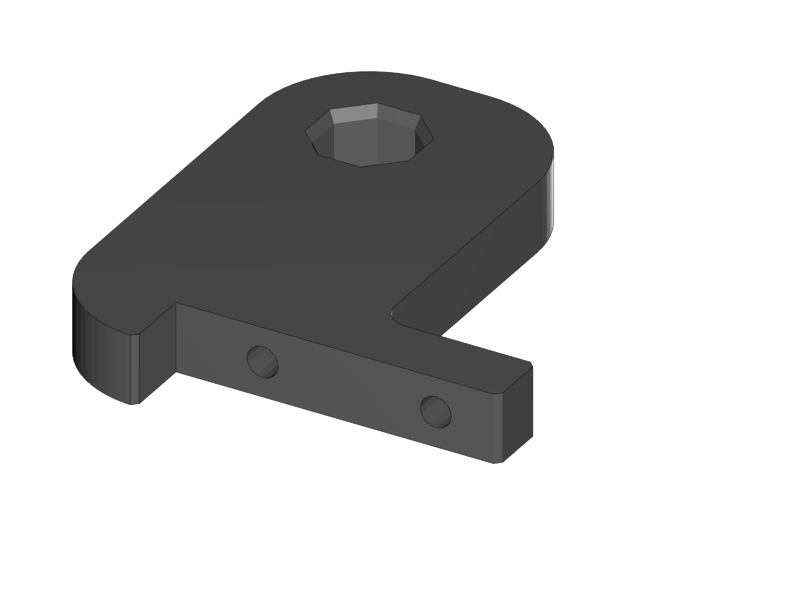
[picture p129: media/Section_1_0076.png]
2x Belt Guiding Disk |□  +
1x Z-Top Left
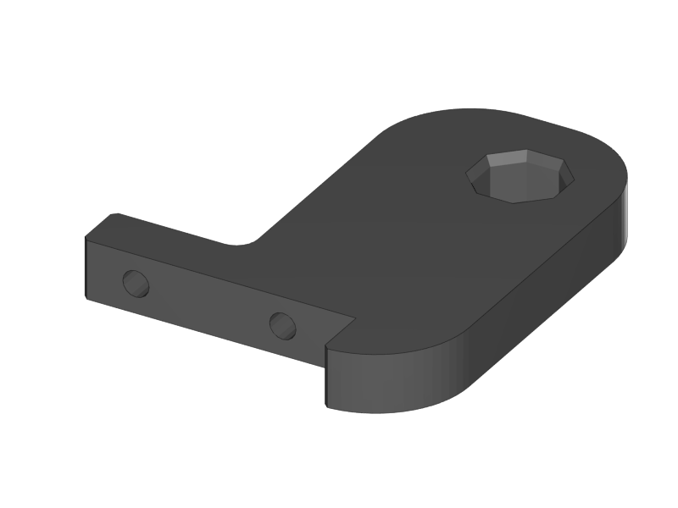
[picture p130: media/Section_1_0077.png]
|□  +
1x Z-Top Right |   |   |   |
|=======================

.Printed Parts Extruder	
|=======================
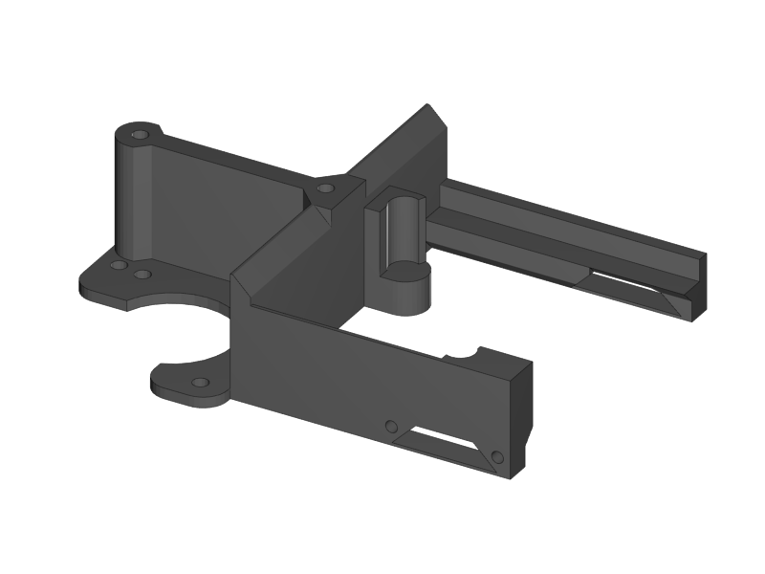
[picture p131: media/Section_1_0049.png]
|□  +
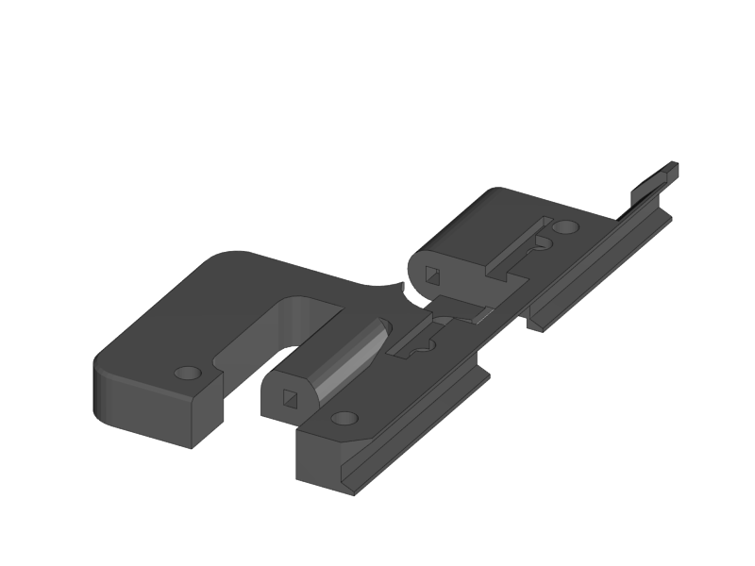
[picture p132: media/Section_1_0100.png]
1x Extruder Fan Holder |□  +
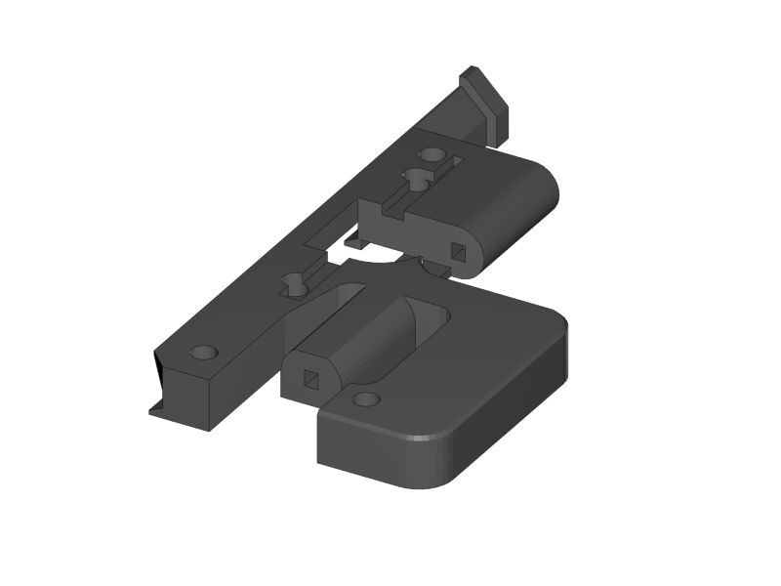
[picture p133: media/Section_1_0105.png]
1x Extruder Center Left |□  +
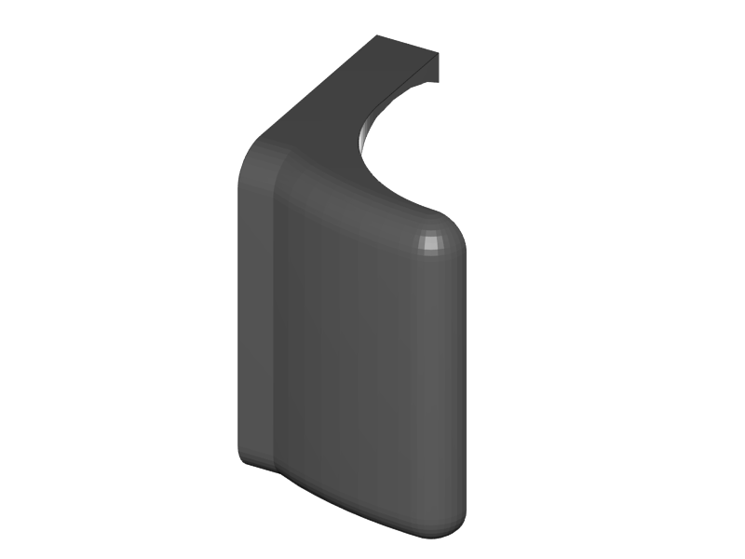
[picture p134: media/Section_1_0107.png]
1x Extruder Center Right |□  +
2x E3D Fan Duct |
|=======================

.Printed Parts Wiring
|=======================
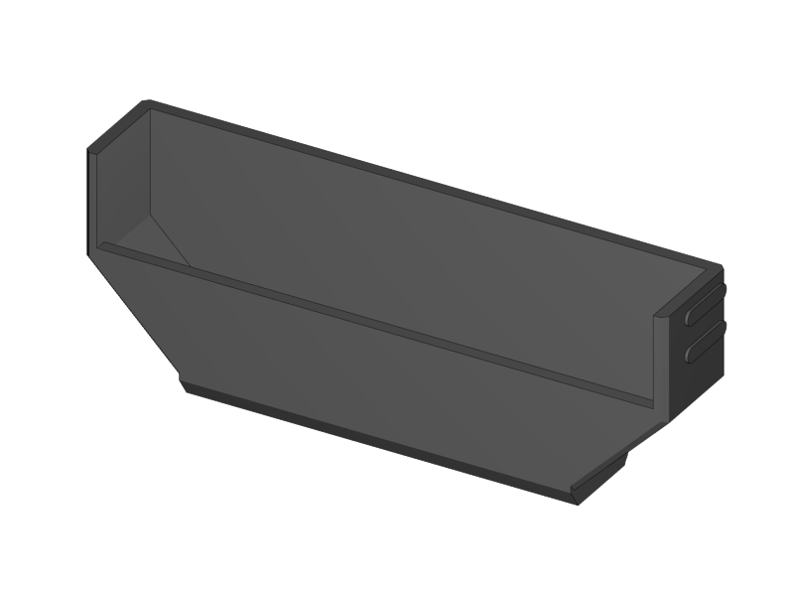
[picture p135: media/Section_1_0054.png]
|□  +
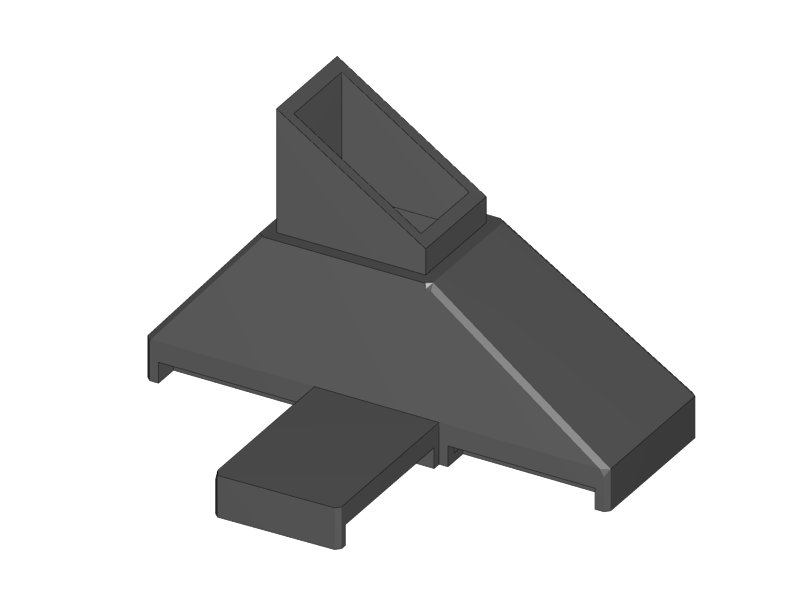
[picture p136: media/Section_1_0050.png]
1x Power Supply Cover |□  +
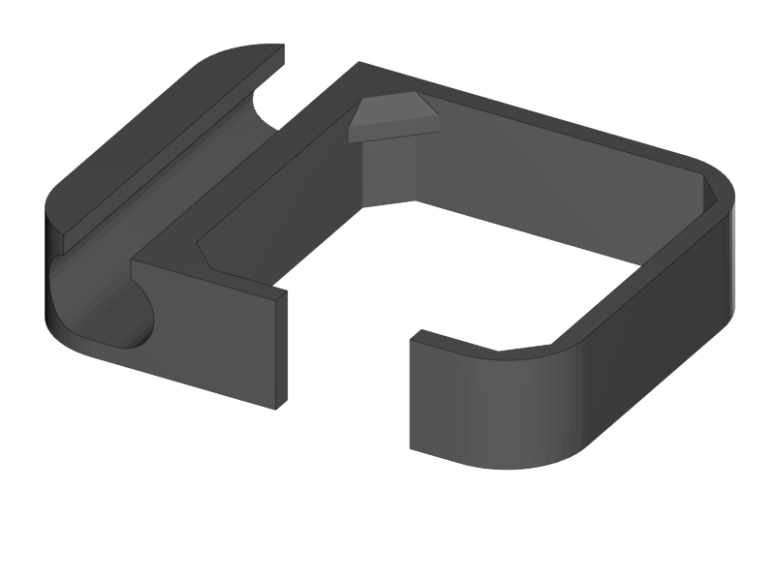
[picture p137: media/Section_1_0045.png]
1x Active Cooling |□  +
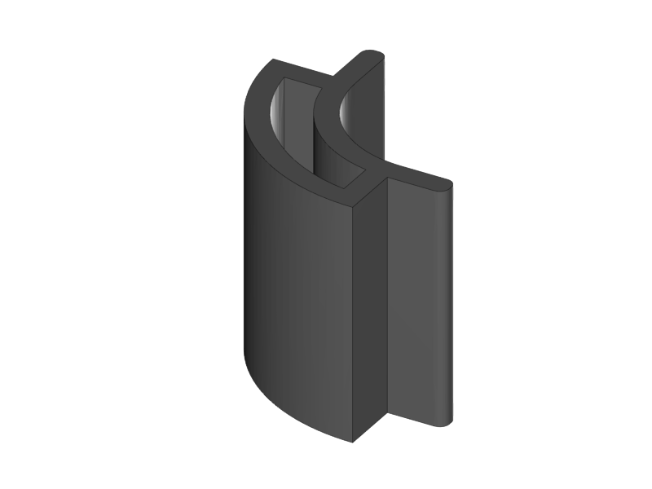
[picture p138: media/Section_1_0138.png]
1x Cable Holder |□  +
1x RUMBA Case Small Corner 
|=======================

.Frame	
|=======================
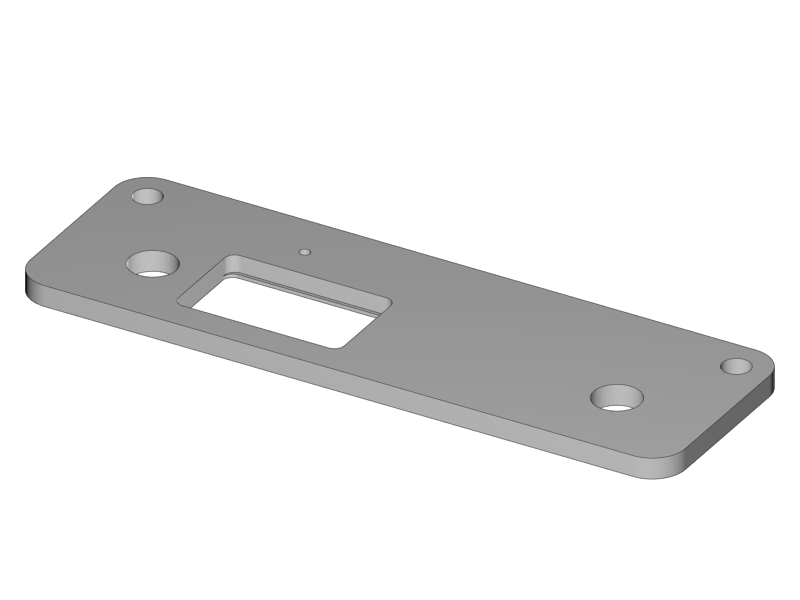
[picture p139: media/Section_1_0011.png]
|□  +
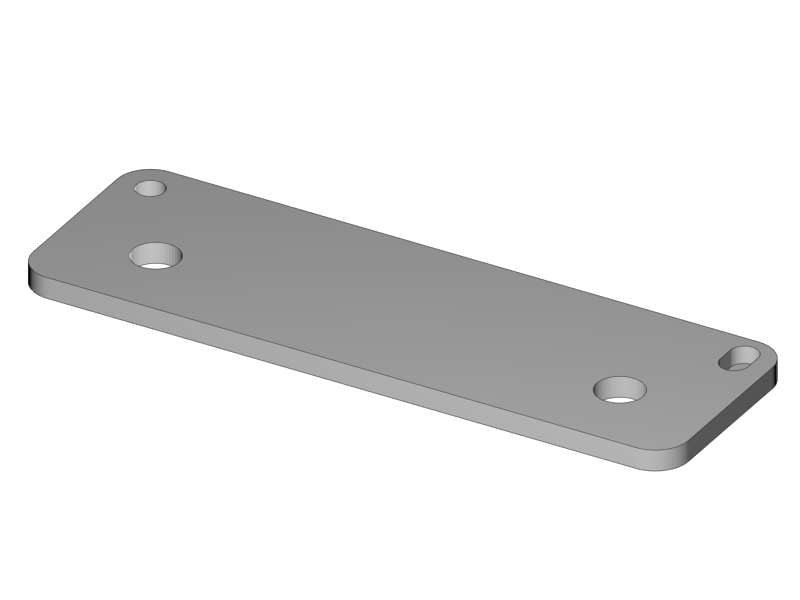
[picture p140: media/Section_1_0012.png]
1x Back Plate |□  +
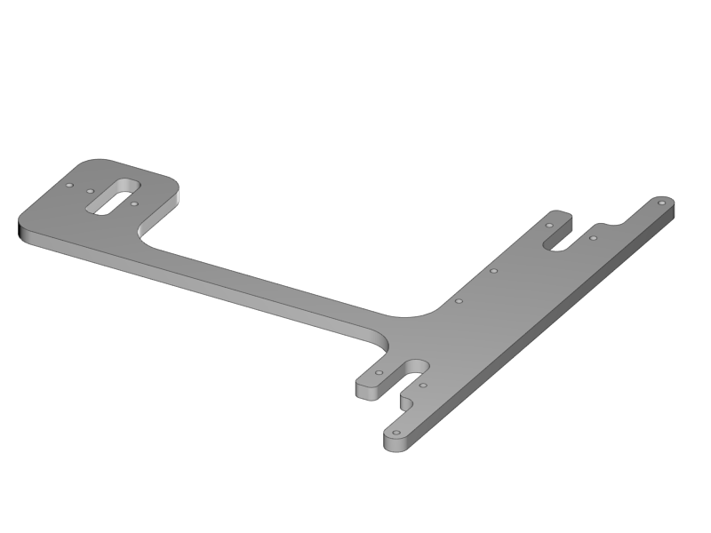
[picture p141: media/Section_1_0013.png]
1x Front Plate |□  +
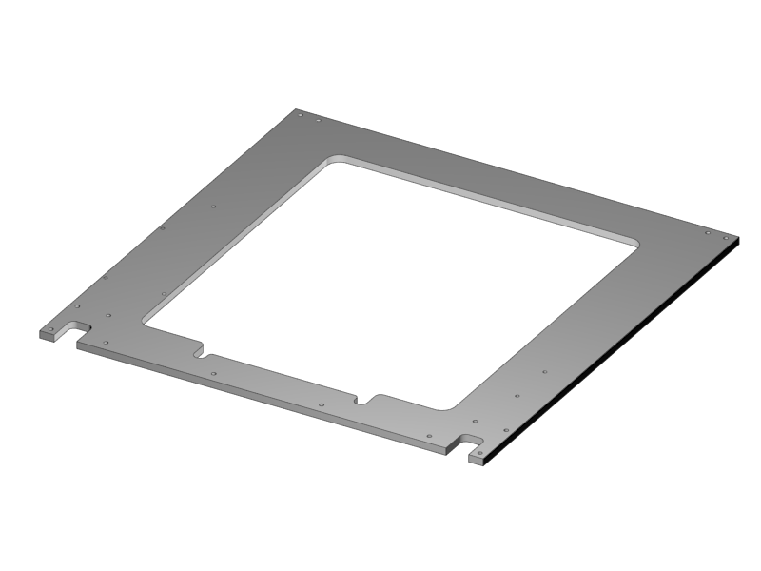
[picture p142: media/Section_1_0010.png]
1x Y-Carriage |□  +
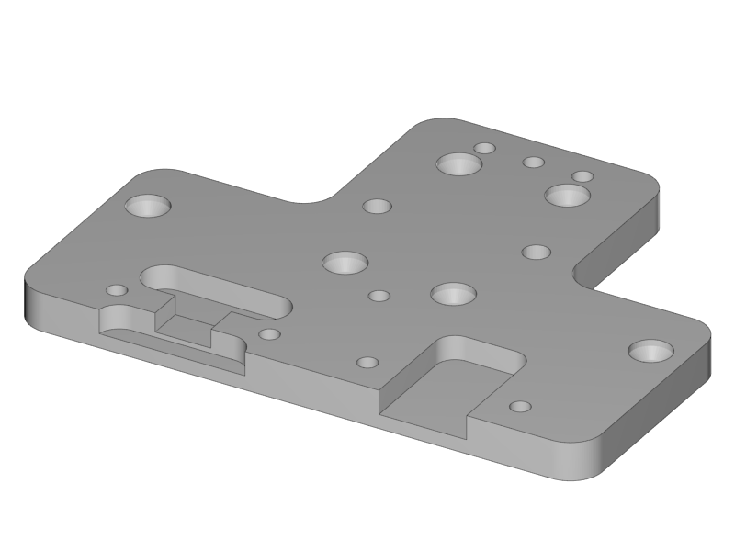
[picture p143: media/Section_1_0014.png]
1x XZ-Plate|□  +
1x Extruder Base Plate
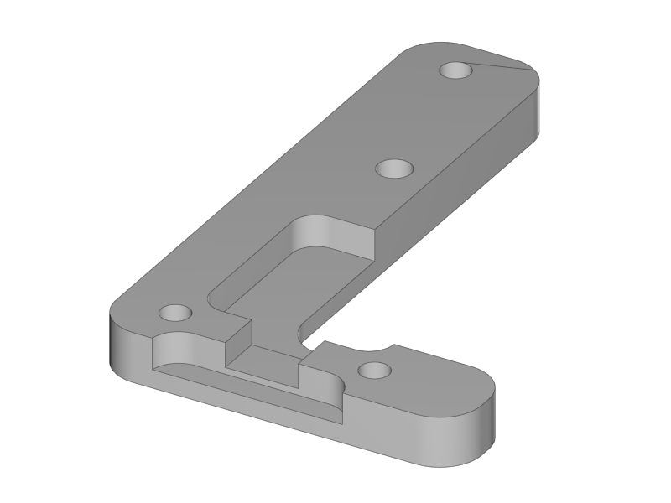
[picture p144: media/Section_1_0015.png]
|□  +
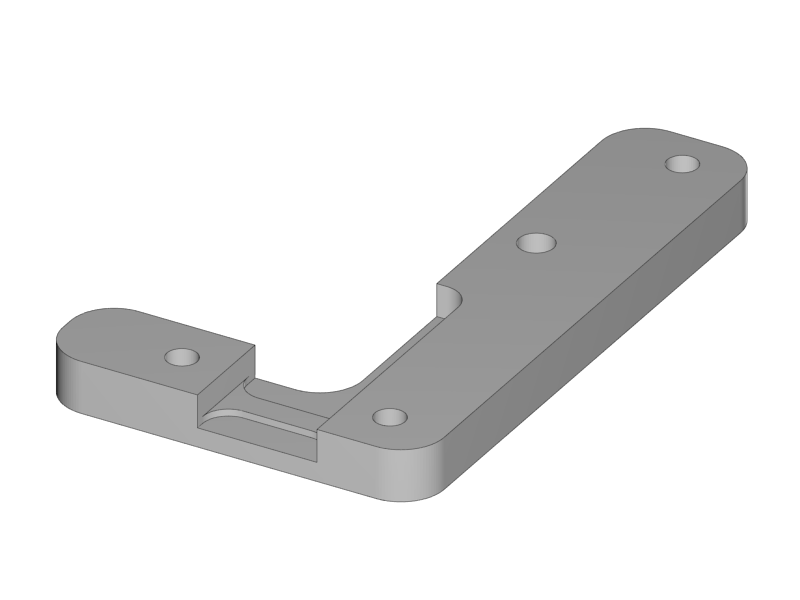
[picture p145: media/Section_1_0016.png]
1x Extruder Front Plate L |□  +
1x Extruder Front Plate R |   |   | 
|=======================

.RUMBA Box
|=======================
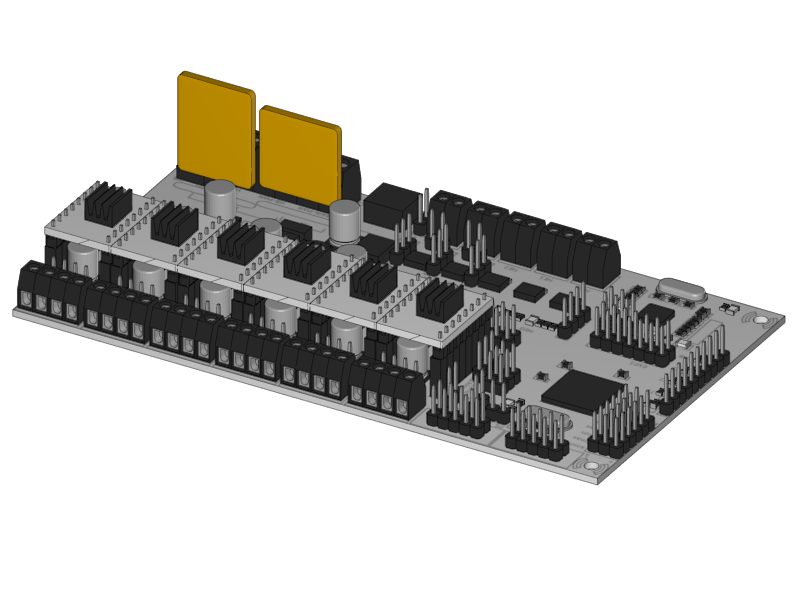
[picture p146: media/Section_1_0143.png]
|□  +
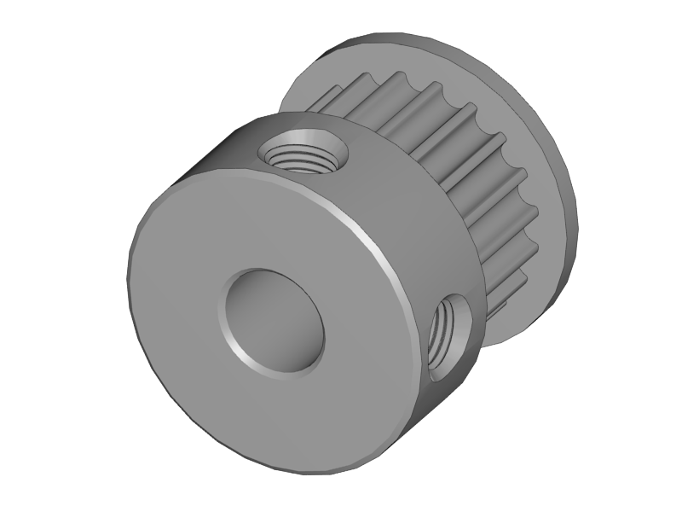
[picture p147: media/Section_1_0018.png]
1x RUMBA Board|□  +
2x GT2 Pulley|□  +
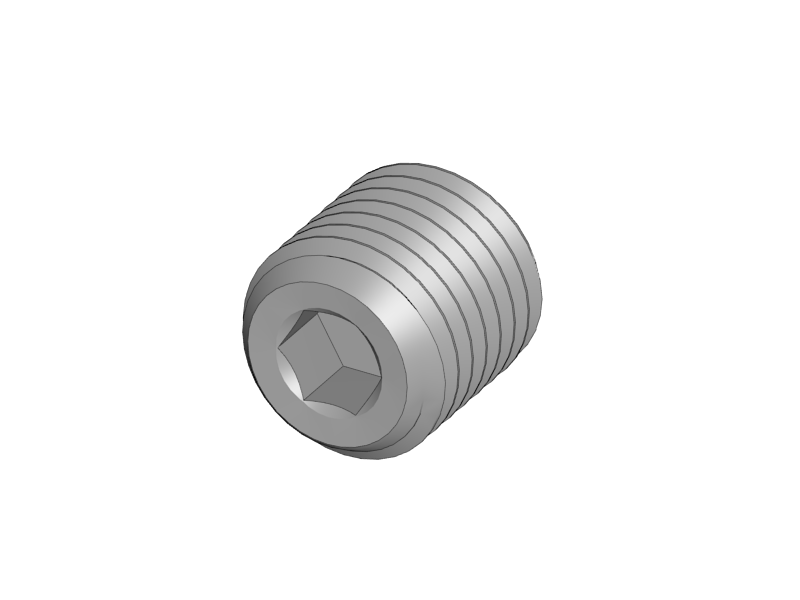
[picture p148: media/Section_1_0104.png]
1x 40mm Fan |□  +
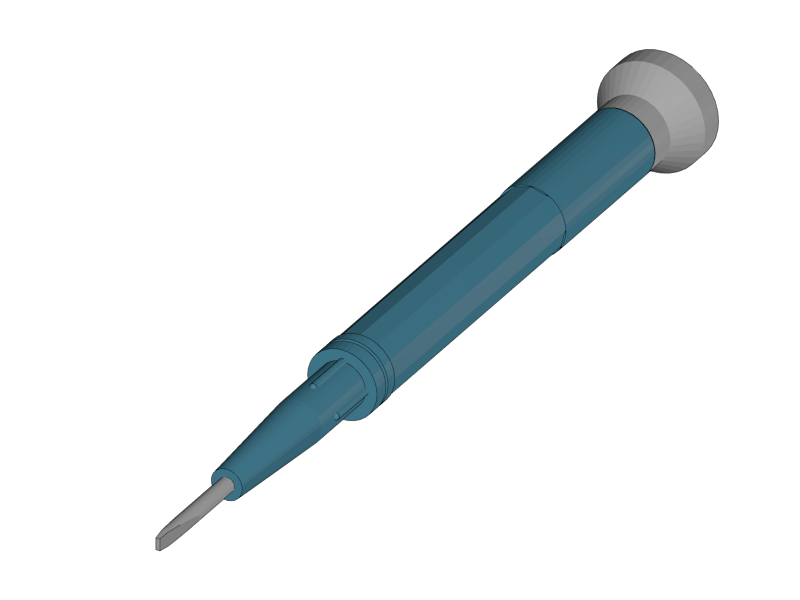
[picture p149: media/Section_1_0150.png]
4x M3x4 Set Screw |□  +
1x Ceramic Screw Driver
|=======================

.Graphic LCD Box	
|=======================
|□  +
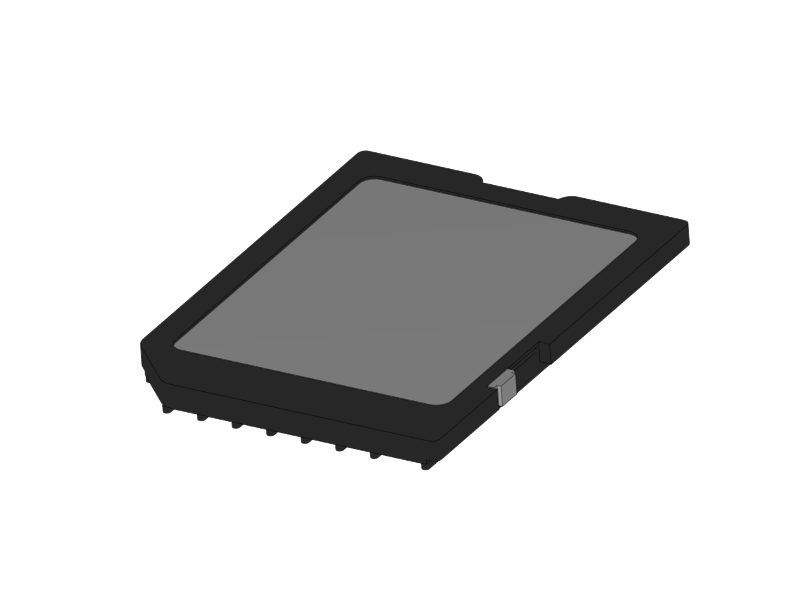
[picture p150: media/Section_1_0151.png]
1x Graphic LCD Controller |□  +
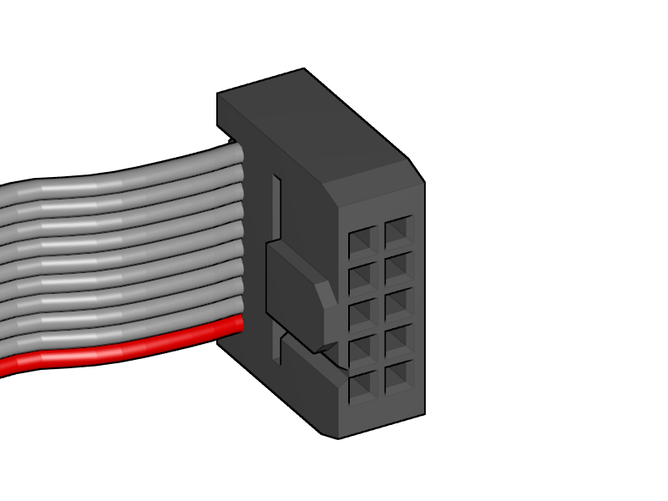
[picture p151: media/Section_4_0011b.png]
1x SD Card|□  +
2x Flatband Cable
|=======================

.Endstop Box
|=======================
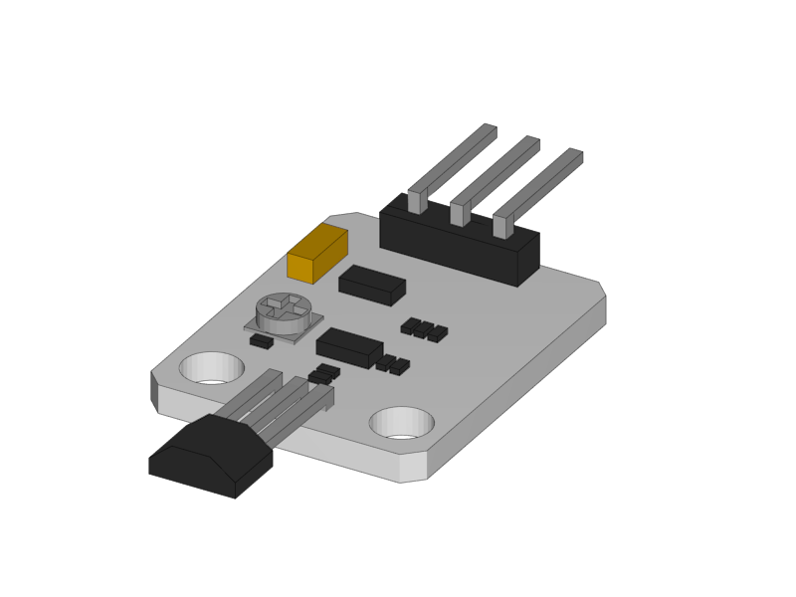
[picture p152: media/Section_1_0006.png]
|□  +
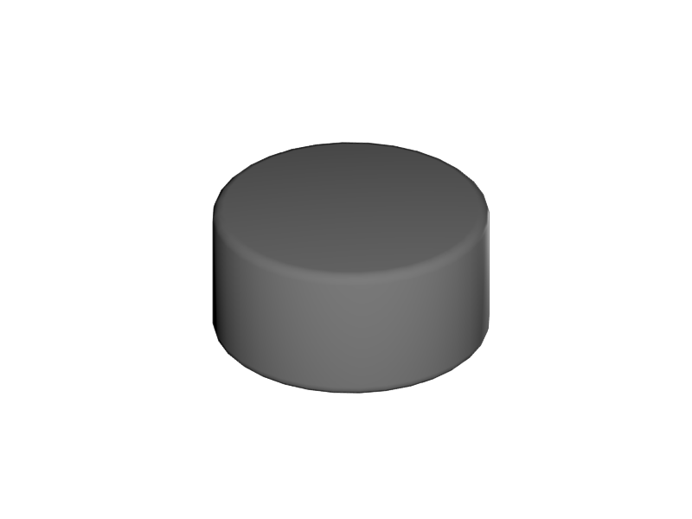
[picture p153: media/Section_1_0152.png]
1x Hall-O Endstop |□  +
6x Magnet
|=======================

.Rods Y
|=======================
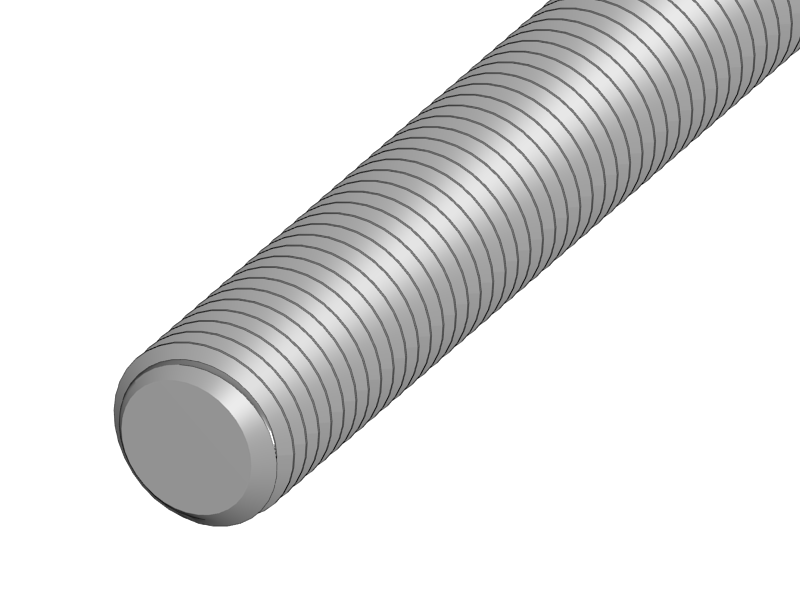
[picture p154: media/Section_1_0079.png]
|□  +
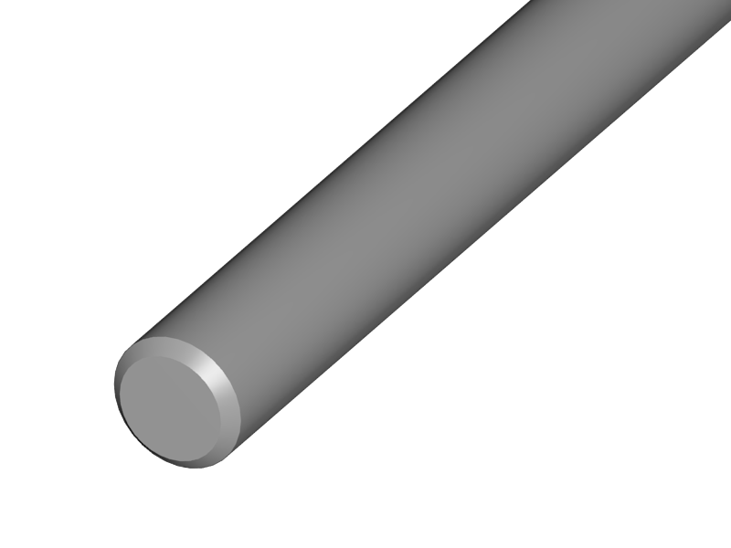
[picture p155: media/Section_1_0080.png]
2x M10 Threaded Rod |□  +
2x Smooth Rod 8 x 385 
|=======================

.Rods XZ		
|=======================
|□  +
1x 8mm x 400 Smooth Rod |□  +
1x 8mm x 343 Smooth Rod |□  +
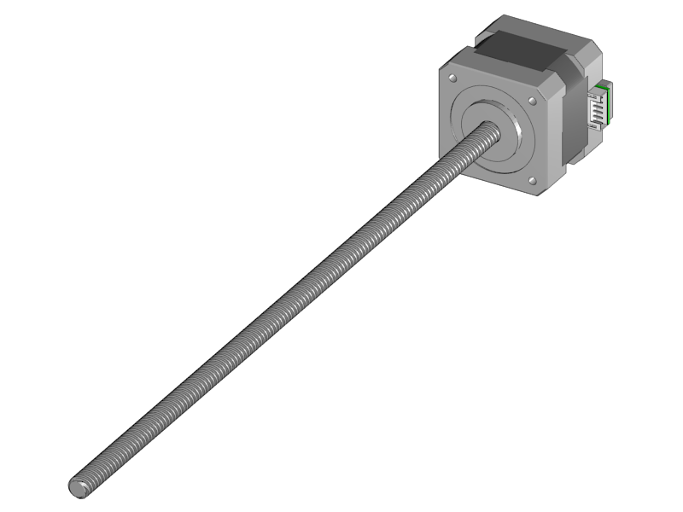
[picture p156: media/Section_1_0101.png]
2x 8x320mm Smooth Rod |□  +
2x Nema 17 Threaded Stepper
|=======================

.Screws Y	
|=======================
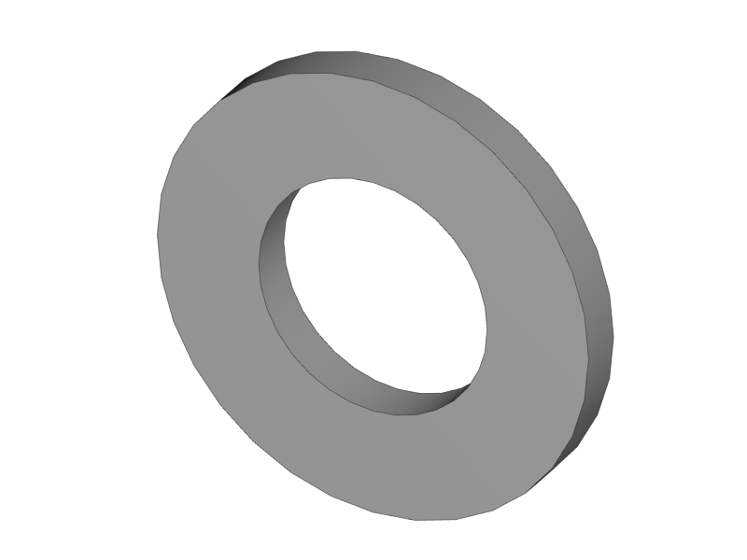
[picture p157: media/Section_1_0025.png]
|□  +
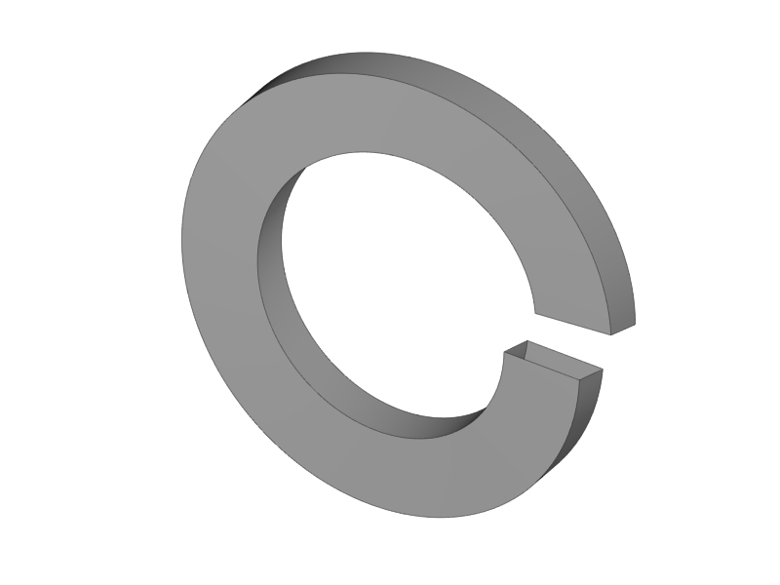
[picture p158: media/Section_1_0024.png]
8x M10 Washer |□  +
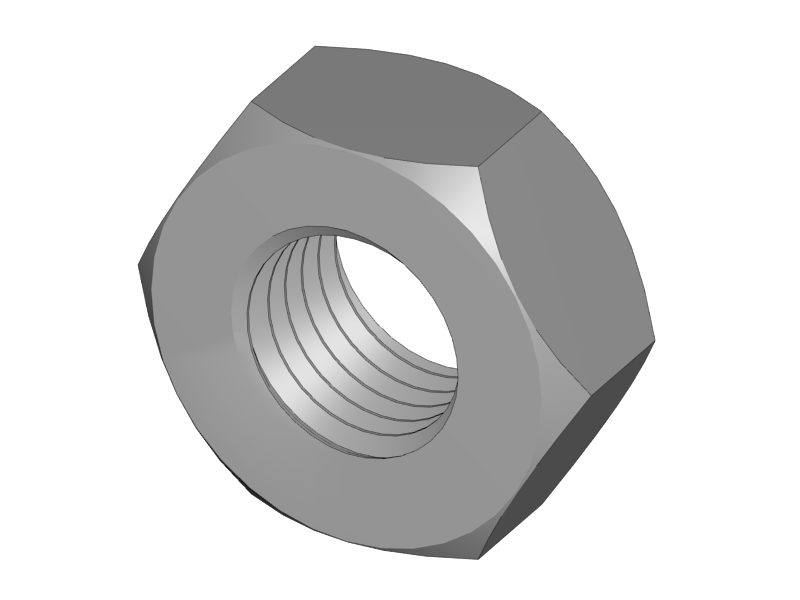
[picture p159: media/Section_1_0023.png]
8x M10 Spring Washer |□  +
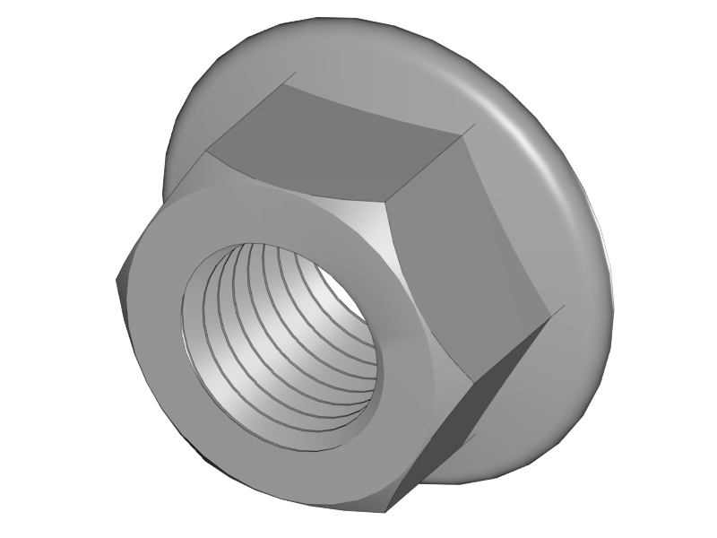
[picture p160: media/Section_1_0022.png]
12x M10 Nut |□  +
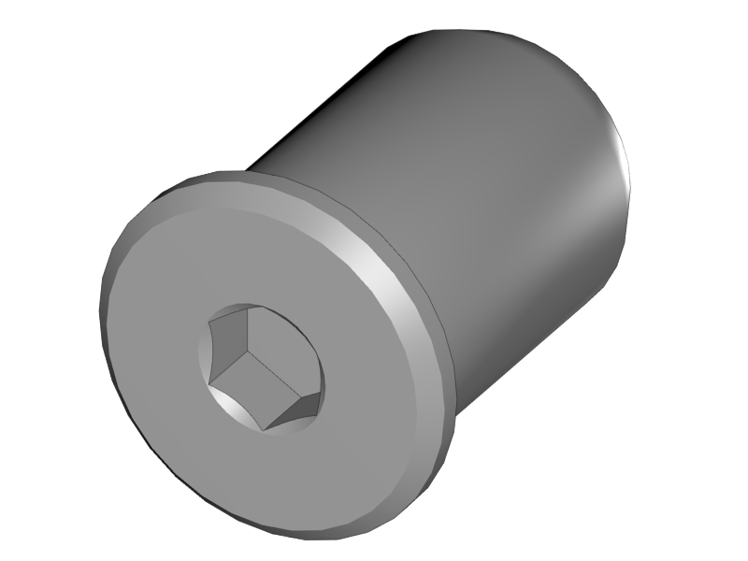
[picture p161: media/Section_1_0033.png]
2x M10 Flange Nut |□  +
4x Round Nut
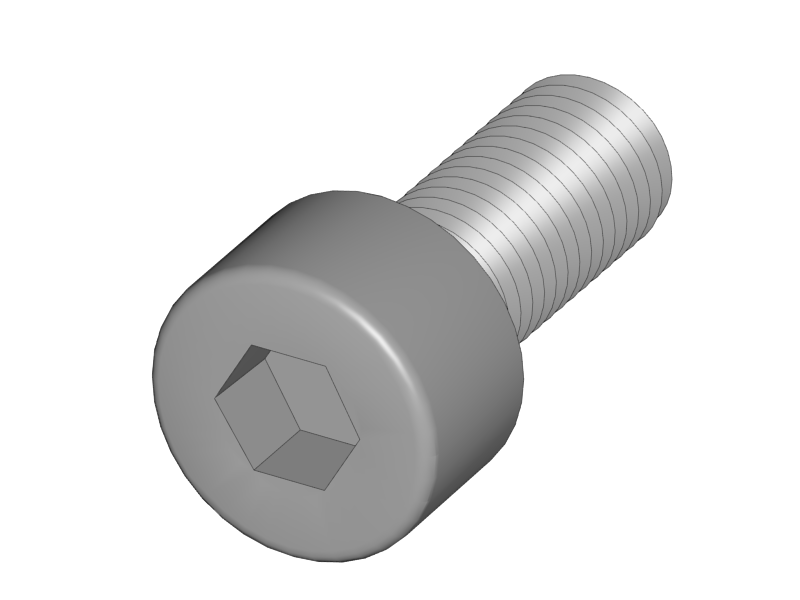
[picture p162: media/Section_1_0032.png]
|□  +
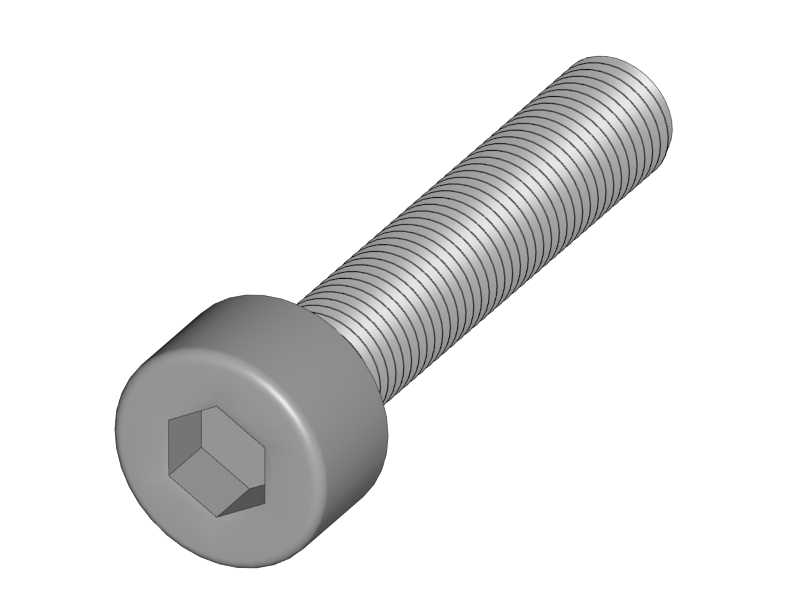
[picture p163: media/Section_1_0029.png]
4x M4x10 Cylinder Screw |□  +
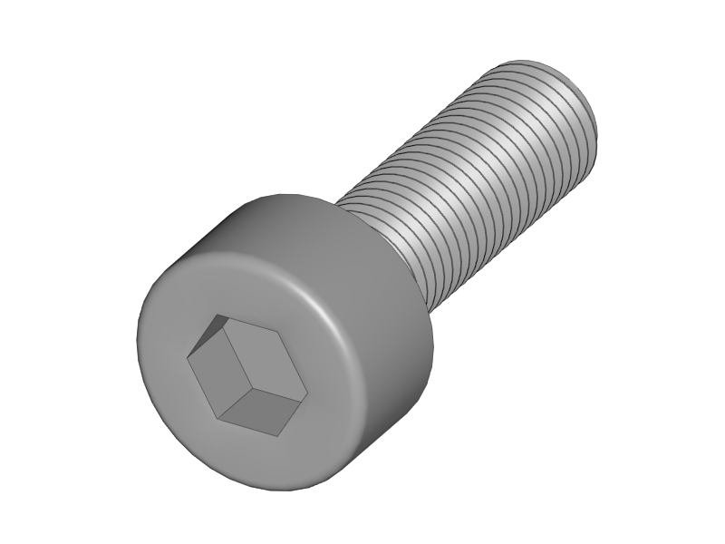
[picture p164: media/Section_1_0028.png]
1x M3x16 Cylinder Screw	|□  +
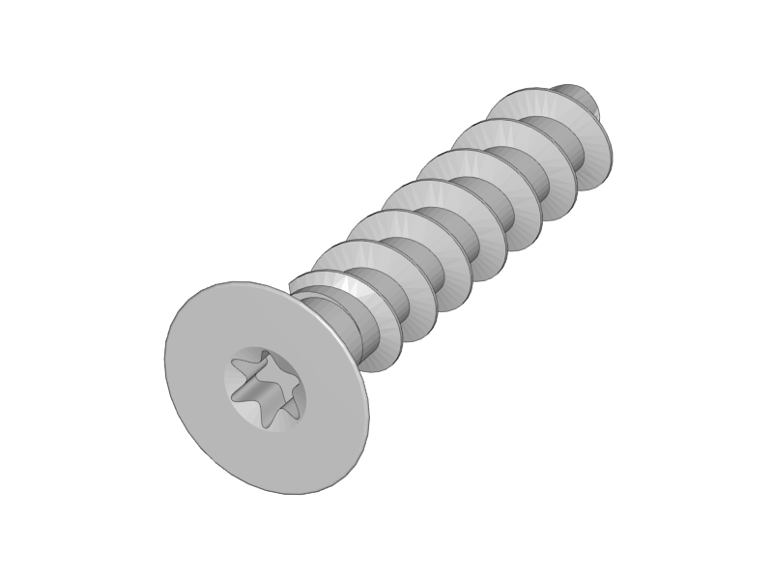
[picture p165: media/Section_1_0035.png]
3+1 M3x10 Cylinder Screw |□  +
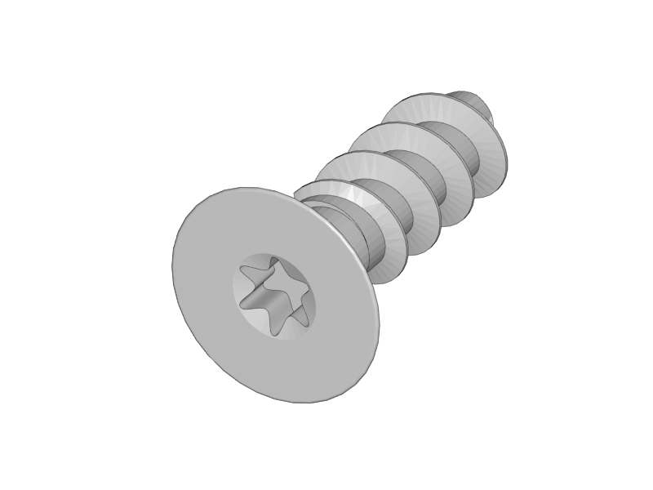
[picture p166: media/Section_1_0034.png]
3x Torx 3x16 Screw |□  +
2+1 Torx 3x10 Screw
|□  +
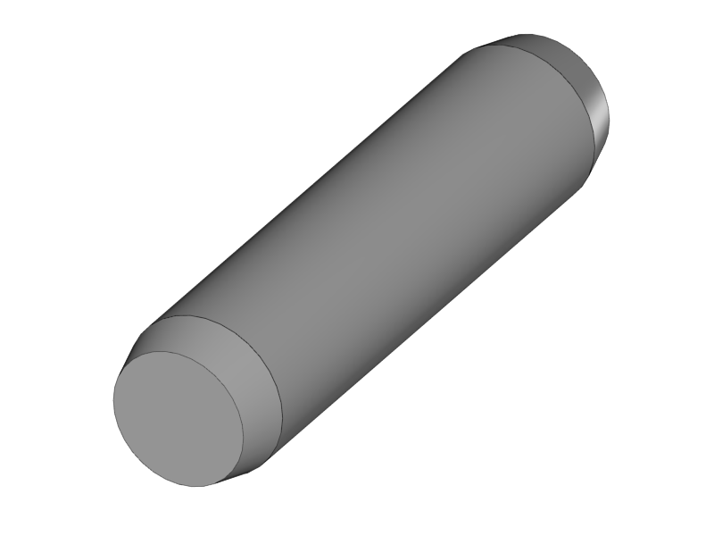
[picture p167: media/Section_1_0036.png]
1+1 M3 Locknut |□  +
1x 4h8x16 Dowel|□  +
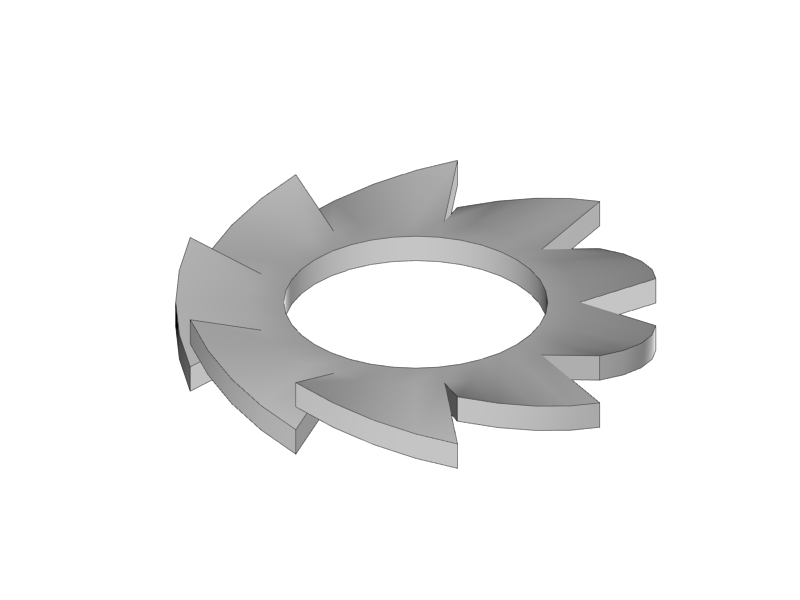
[picture p168: media/Section_1_0103.png]
1x 624ZZ Bearing |□  + 
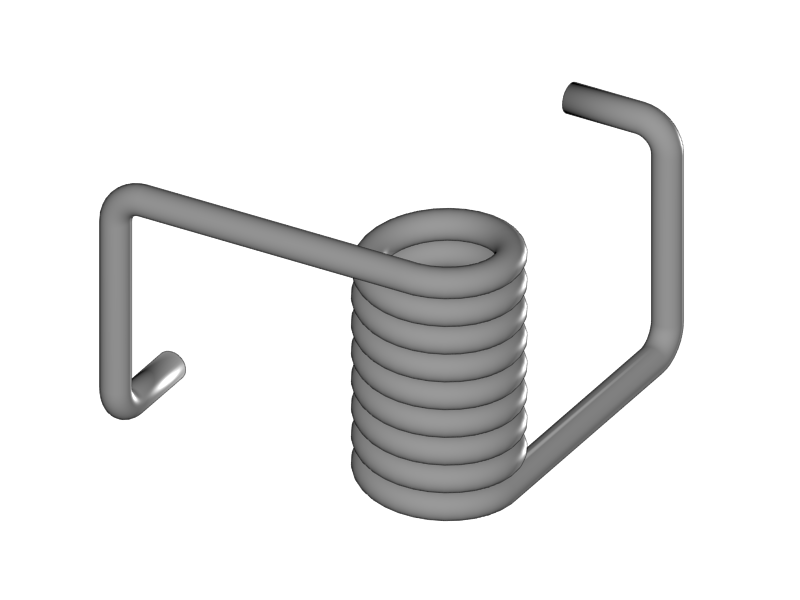
[picture p169: media/Section_1_0154.png]
1x Teethed Washer |□  + 
1x Belt Tensioner
|=======================

.Screws XZ	
|=======================	
|□  +
1x M4x10 Cylinder Screw	|□  +
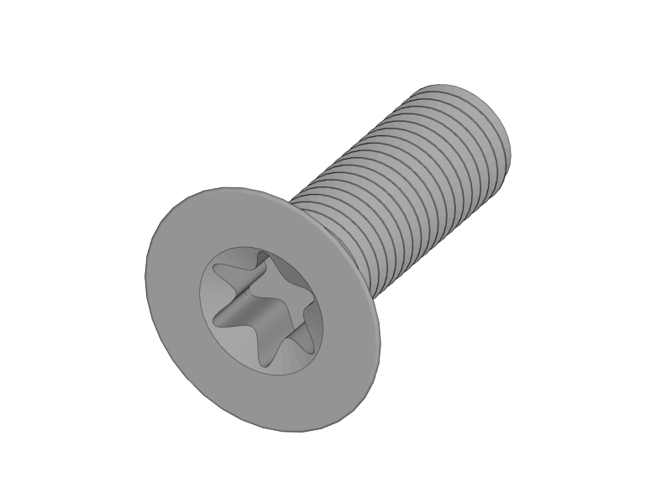
[picture p170: media/Section_1_0019.png]
5+1 M3x10 Cylinder Screw |□  +
8+1 M3x10 Counter Sunk |□  +
6x Torx 3x16 Screw |□  +
14+1 Torx 3x10 Screw
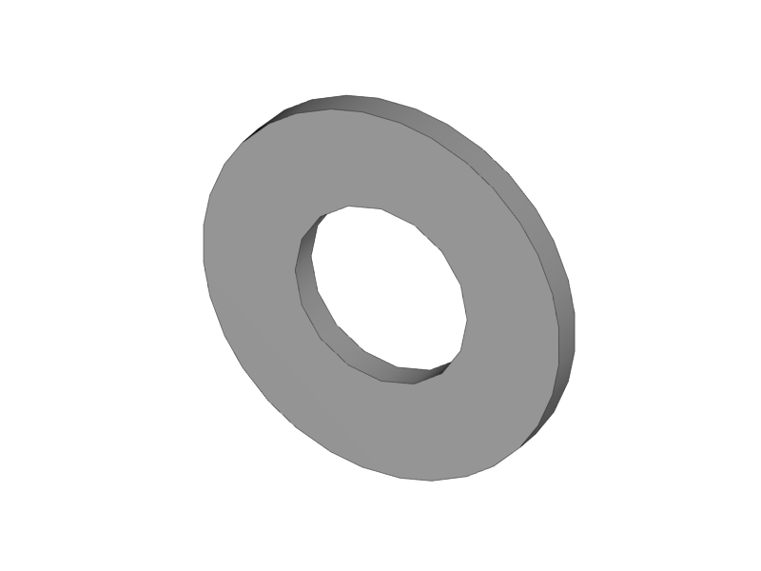
[picture p171: media/Section_1_0027.png]
|□  +
5+1 M3 Washer |□  +
1x 624ZZ Bearing |□  +
1x Belt Tensioner  |   |
|=======================

.Screws	Wiring	
|=======================
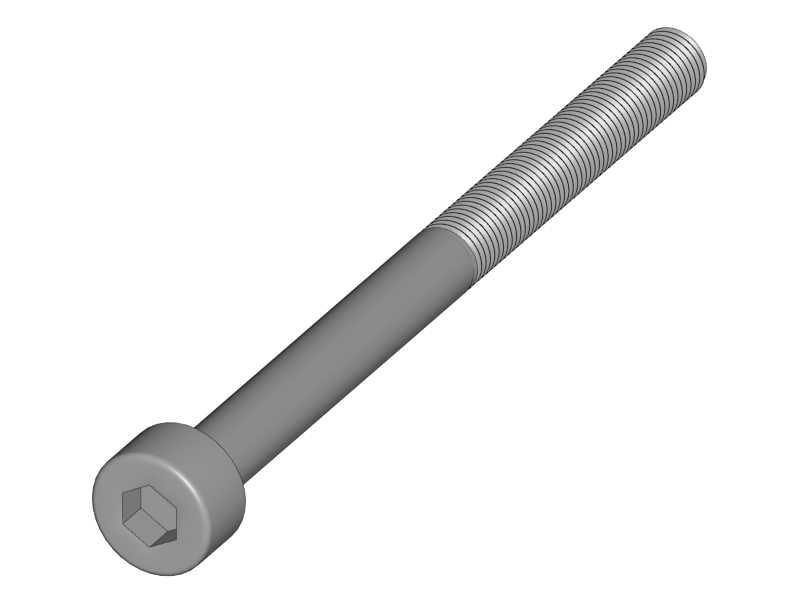
[picture p172: media/Section_1_0031.png]
|□  +
2x M3x40 Cylinder Screw |□  +
2x M3x10 Cylinder Screw |□  +
3x M3x20 CounterSunk |□  +
3x M3 Locknut |□  +
3x M3 Knurled Nut
|□  +
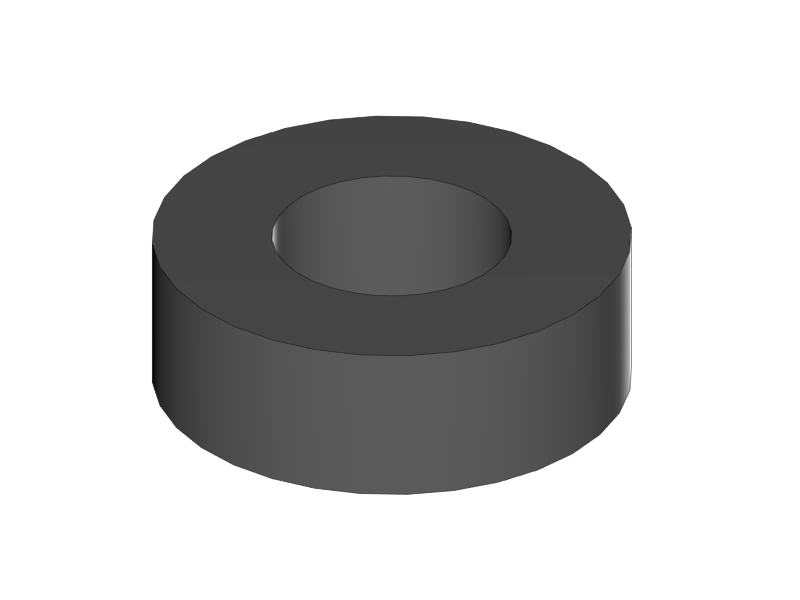
[picture p173: media/Section_1_0144.png]
3x Spring |□  +
2x Spacers |   |   |
|=======================
		
.Screws Extruder 		
|=======================
|□  +
4x M3x20 Cylinder Screw |□  +
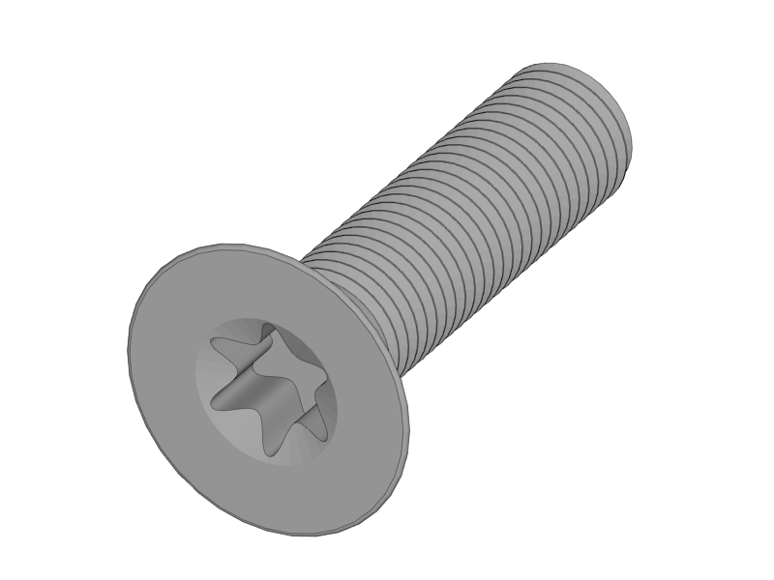
[picture p174: media/Section_1_0020.png]
6x M3x20 Counter Sunk |□  +
2x M3x12 Counter Sunk |□  +
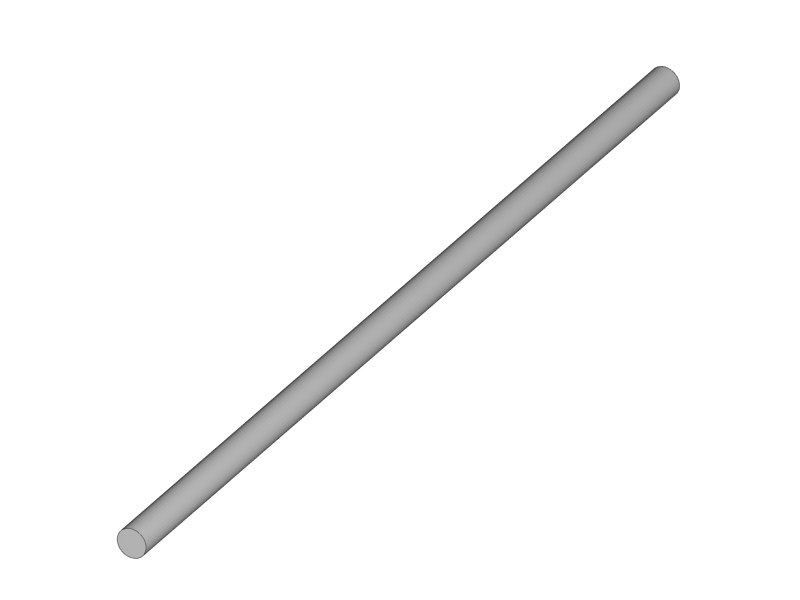
[picture p175: media/Section_1_0106.png]
8x Torx 3x16 Screw |□  +
4x Extruder Spring 
|□  +
2x 4h8x16 Dowel |□  +
2x 624ZZ Bearing |    |    |  
|=======================

.Hotend
|=======================
|□  +
1x M3x3 Set Screw |□  +
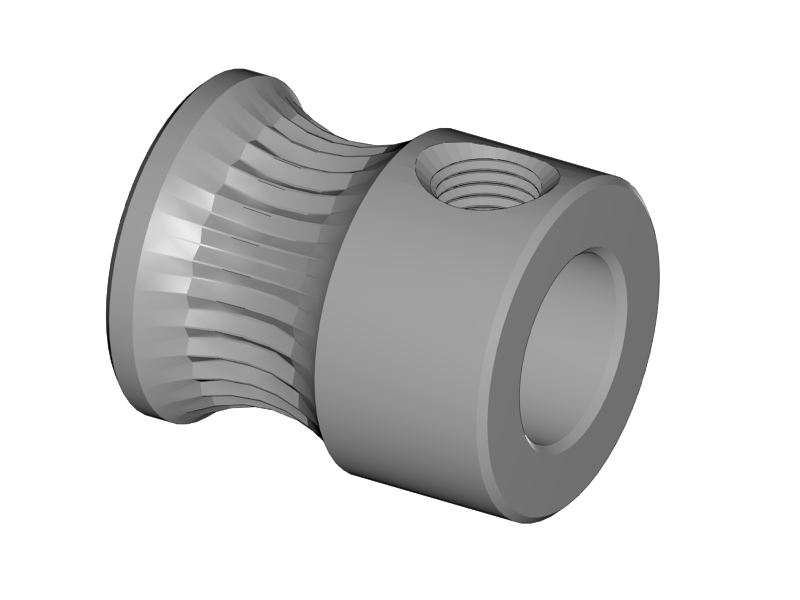
[picture p176: media/Section_1_0099.png]
1x M3x4 Set Screw | □  +
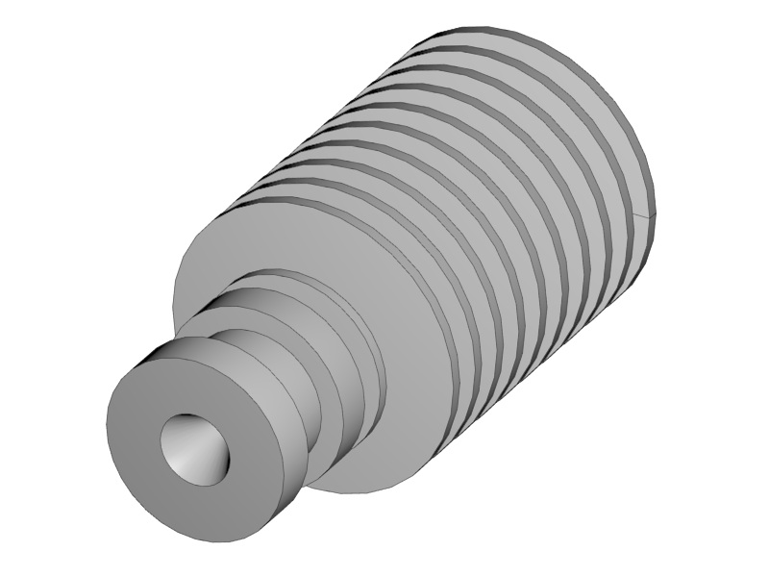
[picture p177: media/Section_1_0098.png]
1x Filament Pulley |□  +
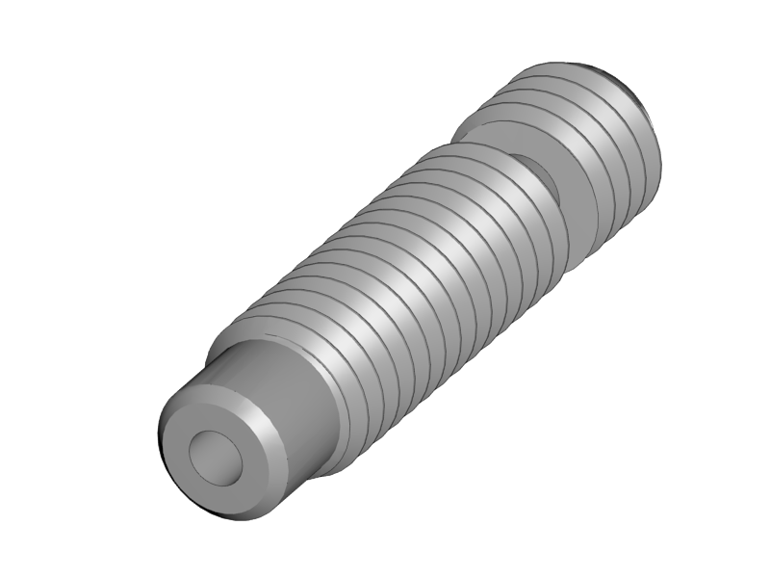
[picture p178: media/Section_1_0096.png]
1x E3D Cooler Body |□  +
1x E3D Heat Break 
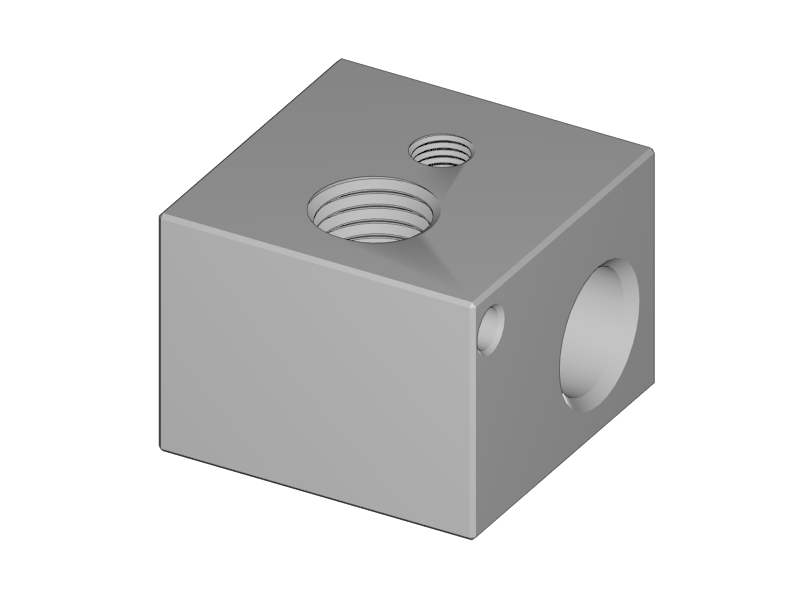
[picture p179: media/Section_1_0097.png]
|□  +
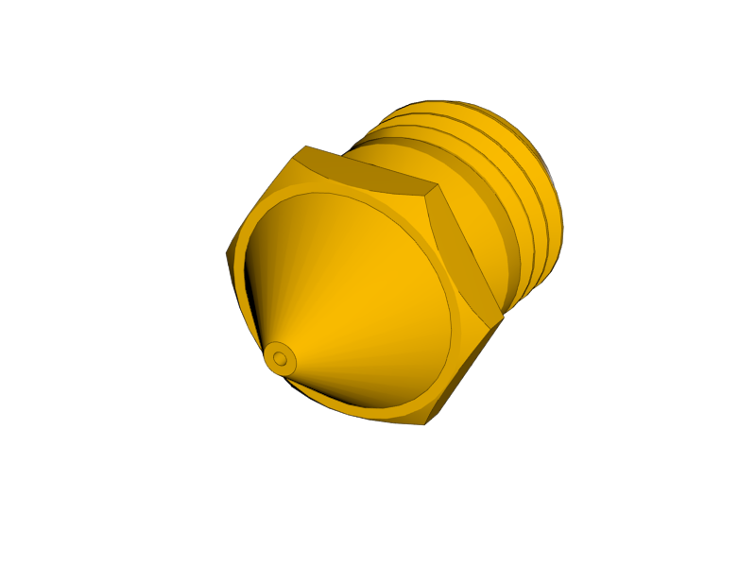
[picture p180: media/Section_1_0095.png]
1x E3D Heater Block |□  +
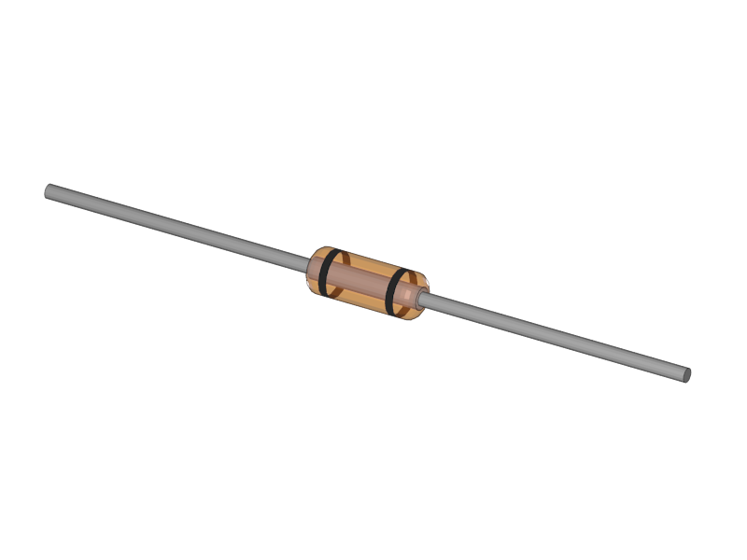
[picture p181: media/Section_1_0094.png]
1x E3D Nozzle |□  +
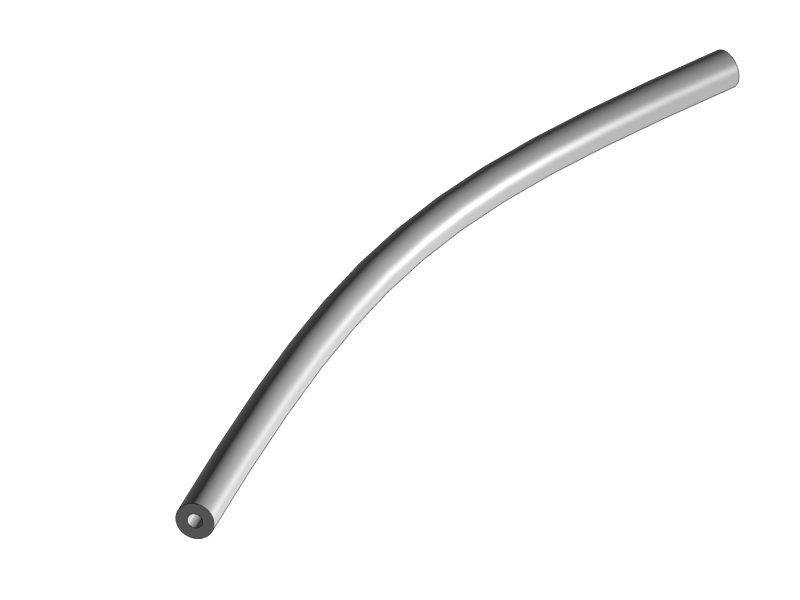
[picture p182: media/Section_1_0153.png]
1x Thermistor |□  +
1x Thermistor insulation 5cm |
|=======================

.Electronics	
|=======================
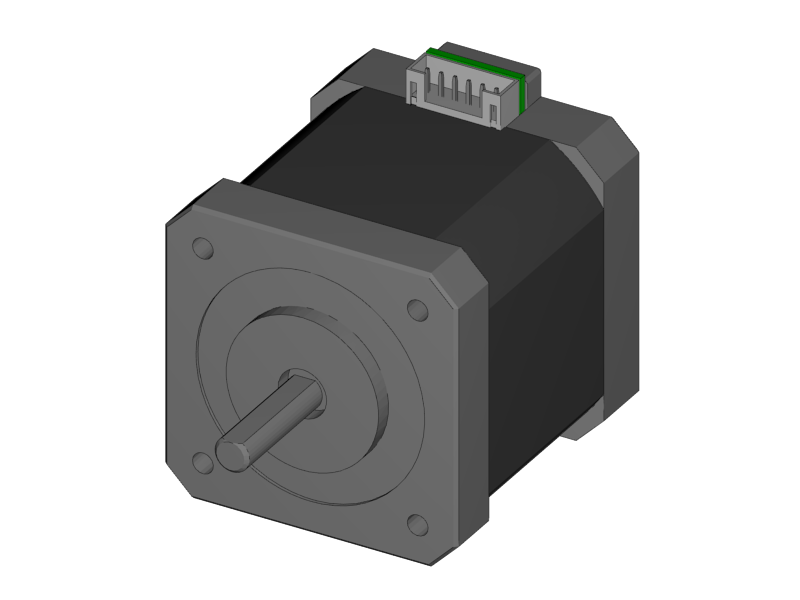
[picture p183: media/Section_1_0161.png]
|□  +
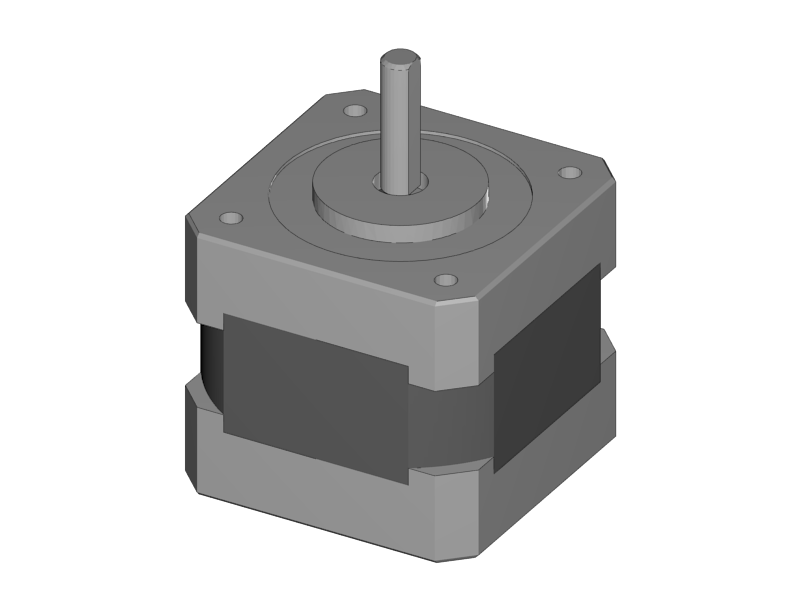
[picture p184: media/Section_1_0017.png]
2x Nema 17 48mm |□  +
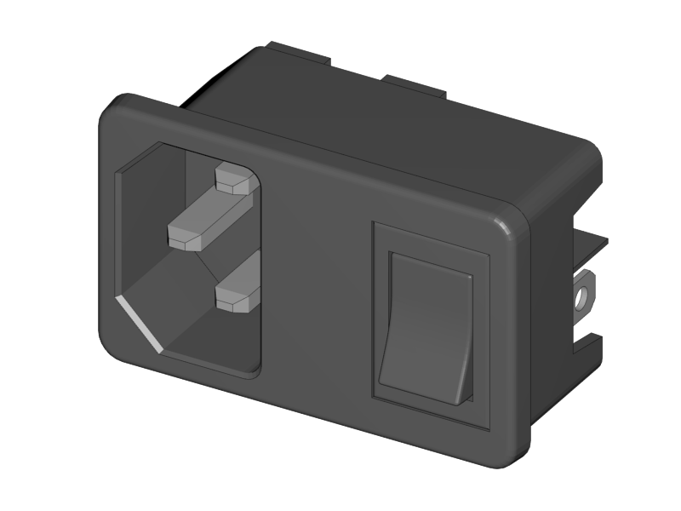
[picture p185: media/Section_1_0009.png]
1or2 Nema 17 40mm |□  +
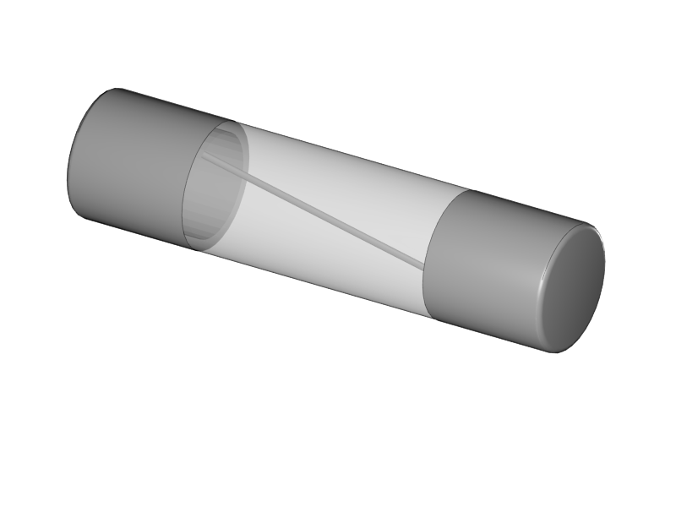
[picture p186: media/Section_1_0089.png]
1x Power Connector |□  +
2x Glass Fuse |
|=======================

.Cables
|=======================
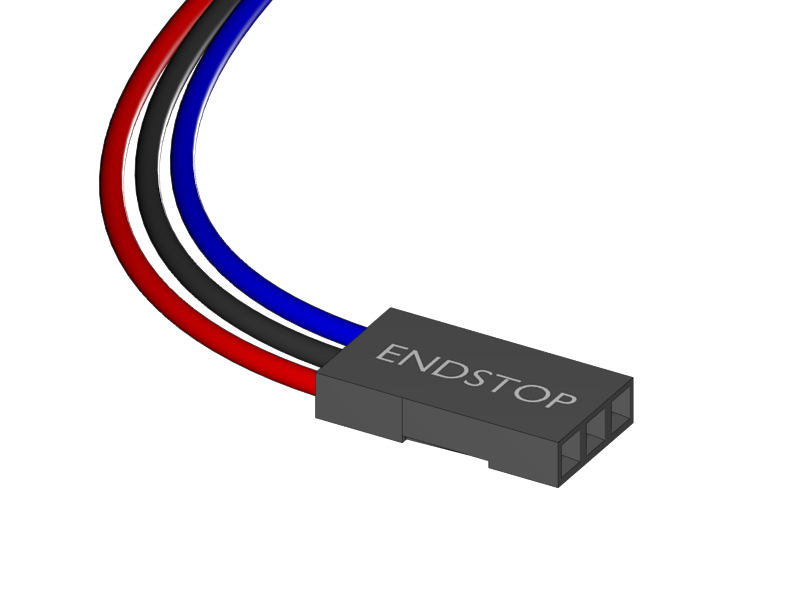
[picture p187: media/Section_1_0084.png]
|□  +
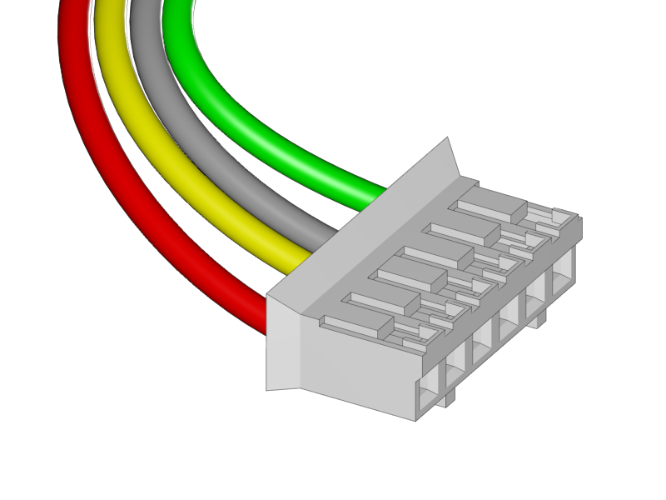
[picture p188: media/Section_1_0083.png]
1x X Endstop 60cm |□  +
1x X Motor 53cm |□  +
1x Y Endstop 60cm |□  +
1x Y Motor 55cm |□  +
1x Z Endstop 65cm
|□  +
1x Z-Motor Serial |□  +
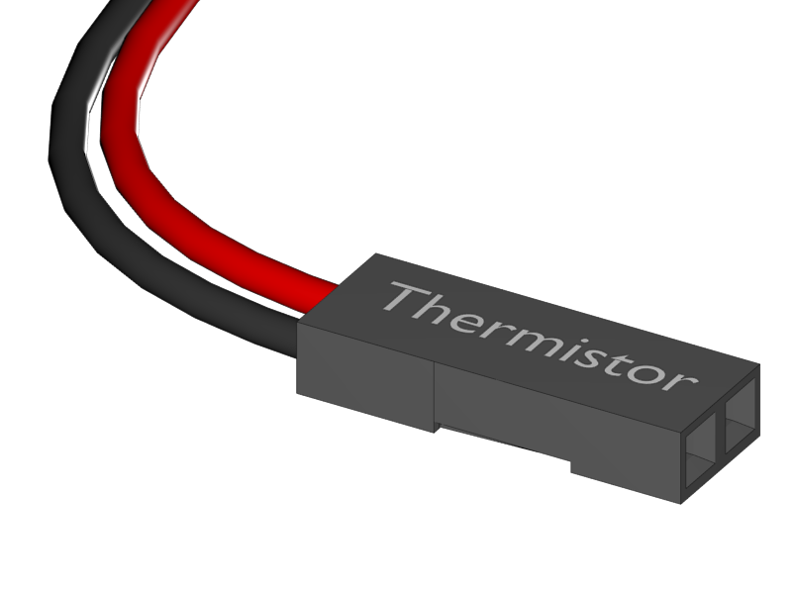
[picture p189: media/Section_1_0085.png]
1or2 Extruder Motor 100cm |□  +
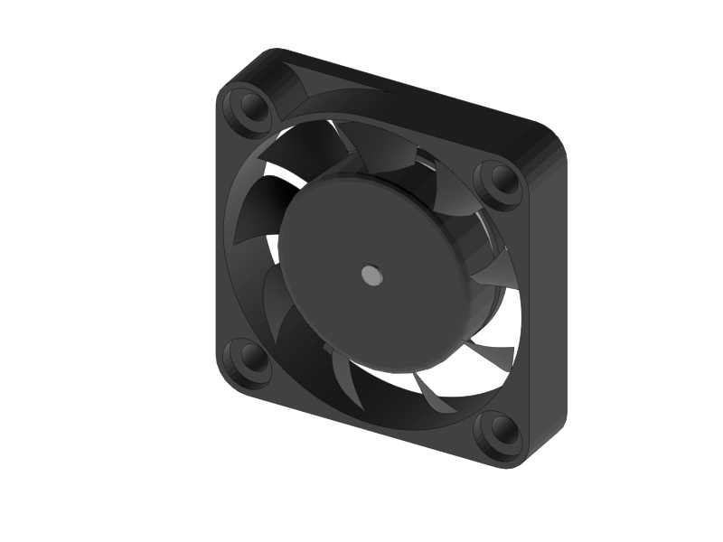
[picture p190: media/Section_1_0092.png]
1or2 Extruder Thermistor 110cm |□  +
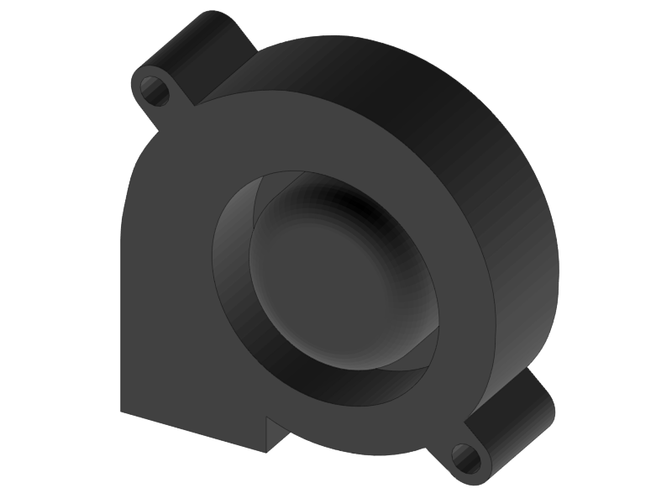
[picture p191: media/Section_1_0093.png]
1or2 Extruder Fan Passive 110cm |□  +
1x Extruder Fan Active 100cm
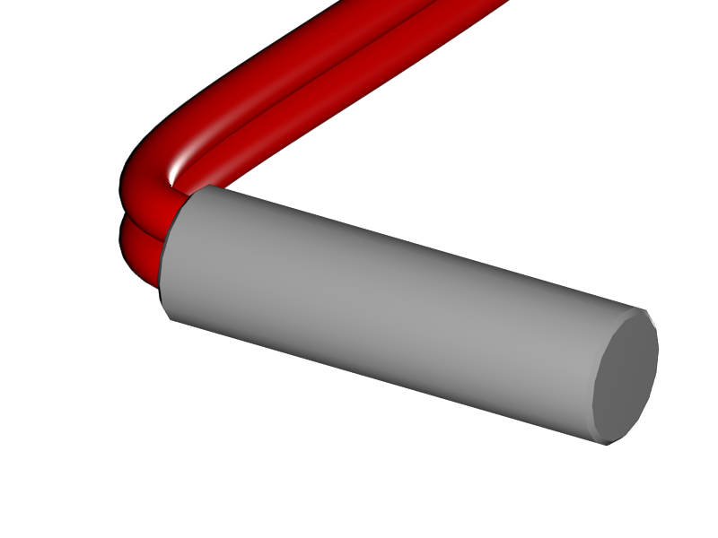
[picture p192: media/Section_1_0091.png]
|□  +
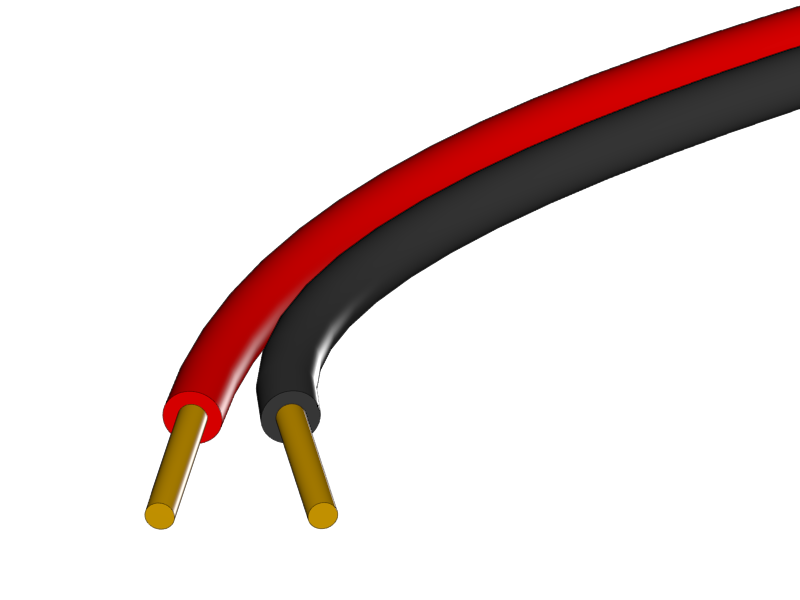
[picture p193: media/Section_1_0081.png]
1or2 Extruder HeatCartridge 100cm |□  +
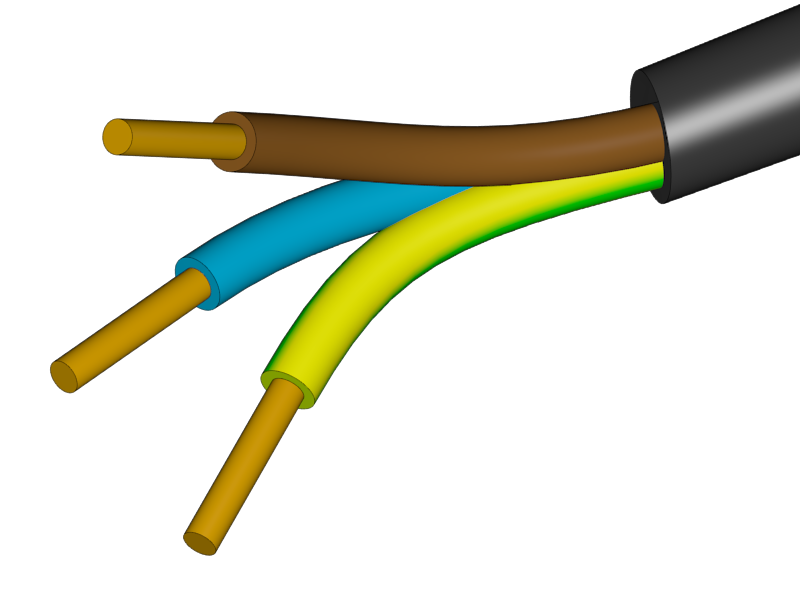
[picture p194: media/Section_1_0082.png]
1x PSU-Power 12V 44cm |□  +
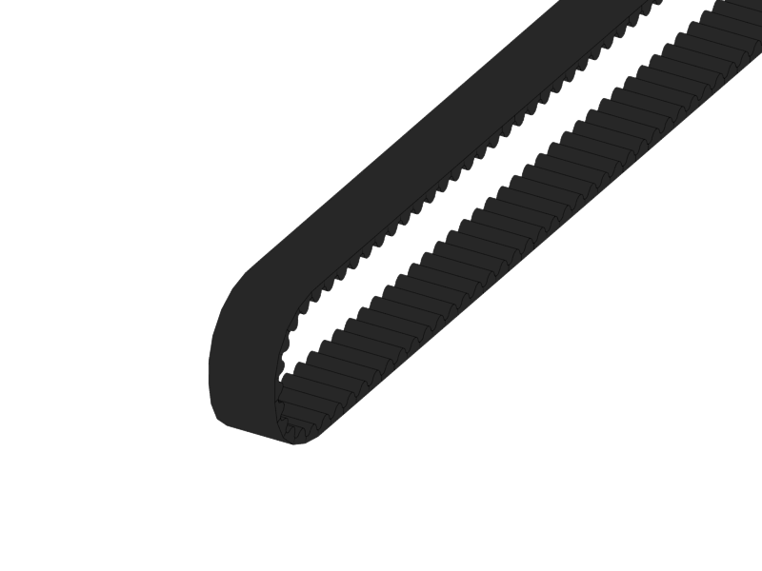
[picture p195: media/Section_1_0042.png]
1x PSU-Power 220V 29cm |□  +
1x Timing Belt-X 83,6cm |□  +
1x Timing Belt-Y 72,8cm
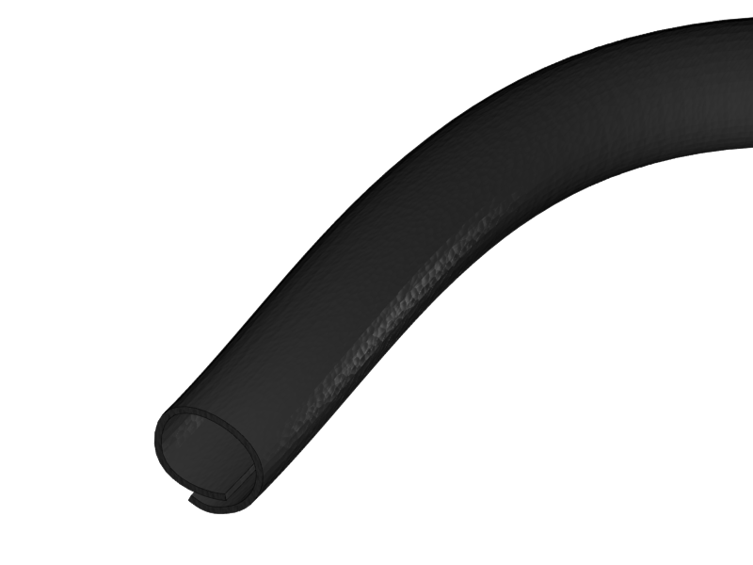
[picture p196: media/Section_1_0155.png]
|□  +
1x Braided Sleeve 39cm |□  +
1x Braided Sleeve 54cm |□  +
1x Braided Sleeve 50cm |□  +
1x Braided Sleeve 31cm |□  +
1x Braided Sleeve 74cm
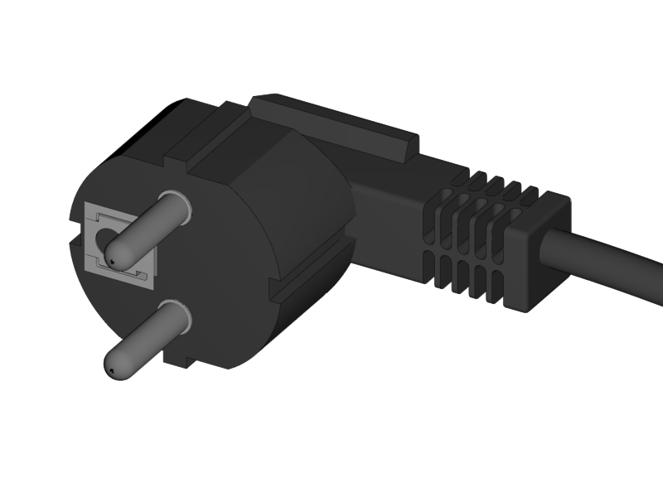
[picture p197: media/Section_1_0162.png]
|□  +
1x Power Cable |   |   |   |   
|=======================

.Filament Holder + Heatbed
|=======================
|□  +
1x Mirror Clamp |□  +
1x Filament Holder |□  +
4x 624ZZ Bearing |□  +
2x 4mm Rod |□  +
1x Teflon pipe 1m
|□  +
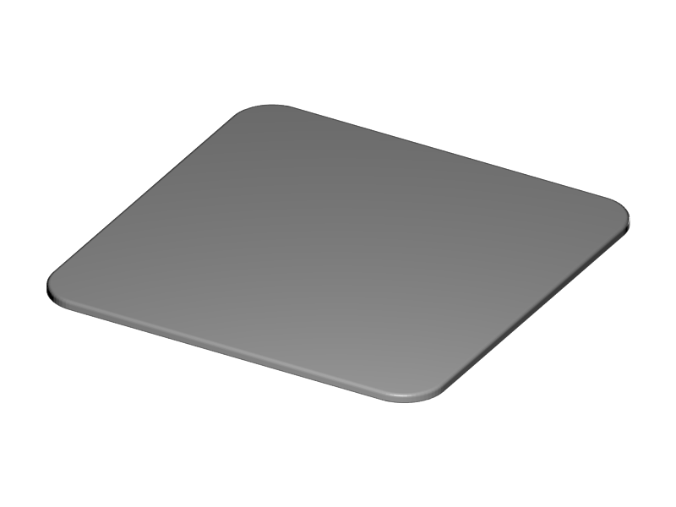
[picture p198: media/Section_1_0037.png]
1x Heatbed |□  +
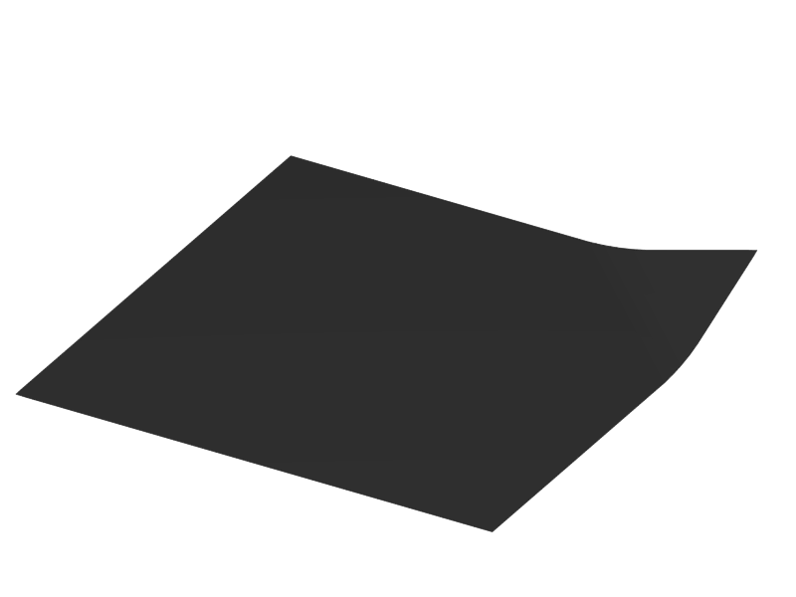
[picture p199: media/Section_1_0163.png]
1x Mirror |□  +
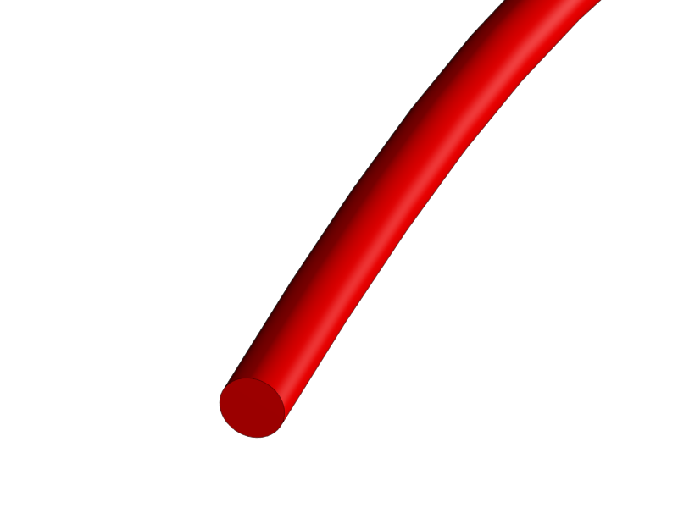
[picture p200: media/Section_1_0159.png]
1x Power Supply Sticker |□  +
5m Test Filament |
|=======================

.Other
|=======================
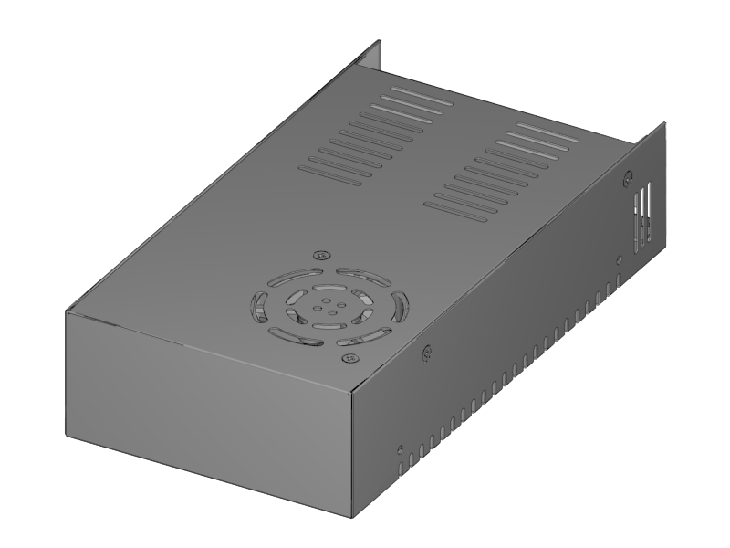
[picture p201: media/Section_1_0008.png]
|□  +
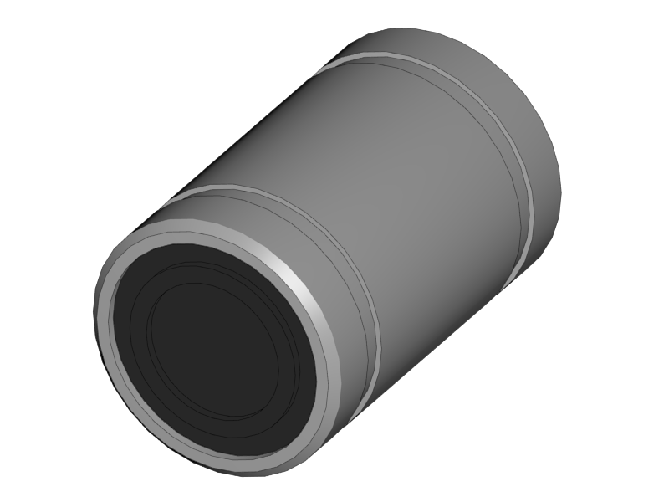
[picture p202: media/Section_1_0002.png]
1x Power Supply |□  +
10x LM8UU Linear Bearing |□  +
50x Zipties |□  +
1x superglue
|=======================

link:Section-1.3-Preparing-Casings[Next]
