Pete30/3dtiskarna/Section-3.3-Assembly-of-the-XZ-Unit-Mounting-the-Timing-Belt.asciidoc

link:Section-3.4-Assembling-the-Extruder[Next]

|====
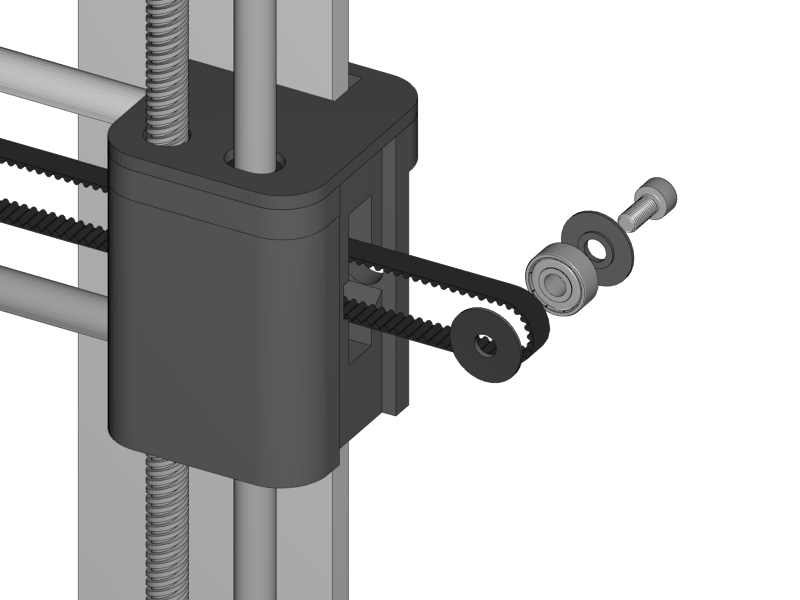
[picture p226: media/Section_3_0015.png]
1.5+||
 +
2x Belt Guiding Disc
|
 +
1x M4x10 Cylinder Screw
|
 +
1x 624ZZ Bearing
|
 +
1x GT2 Timing Belt 836mm
|
 +
1x Belt Tensioner
|====

* Put the bearing onto the M4 screw with a Belt Guiding Disc on both sides
** Make sure that the little notch of the discs is facing the bearing. The smooth surface is facing outwards.
* Lead the timing belt throught the opening of the X-Idler holder.
* Put the bearing assembly throught the loop
* Pull it back into the X-Idler holder.
** You just slide in the idler bearing with screw from the side. No need to screw anything, the tension of the belt will keep the bearing in its place.

''''
<<<

|====
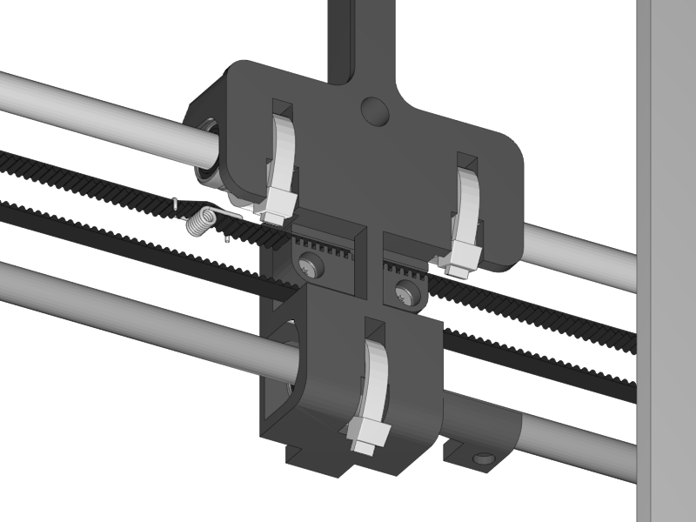
[picture p227: media/Section_3_0016.png]
|
|====

* Push one end of the timing belt into the teeth of the X-Axis
* Lead the remaining long side through the opening underneath the Teeth.
* Loosen the screws of the X-Motor a little bit, and slide the motor some millimeters in the direction of the X-Carriage.
* Lead the timing belt over the motor pulley 
* Lead it back into the direction of the X-Carriage.
* Put the Belt Tensioner on the belt as shown.
* Push the remaining end of the timing belt into the X-Teeth. 
* Set the tension not too tight.
* Tighten the timing belt by sliding the motor to the right and fix it again with its screws. 
** If the belt moves up and down a little when you move the X-Carriage the belt is too loose
** If the belt makes sound like a guitar string, it is too tight.
* If the belt tensioner is (almost) straight as shown the tension is right.

''''
<<<

|====
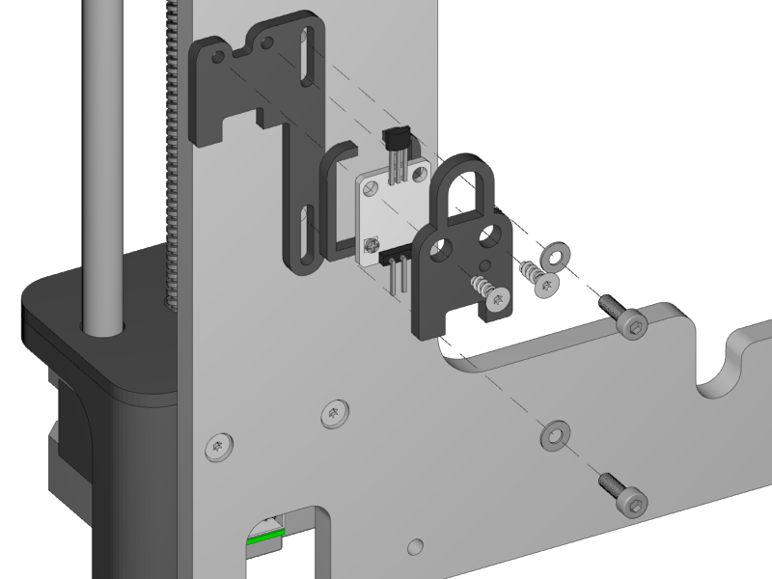
[picture p228: media/Section_3_0017.png]
1.7+||
 +
1x Z-Endstop Holder
|
 +
1x Endstop Cover Top
|
 +
1x Endstop Cover Rim
|
 +
1x Hall-O Endstop
|
 +
2x Torx 3x10 Screw
|
 +
2x M3x10 Screw
|
 +
2x M3 Washer

|====

* Mount the end-stop and its cover onto the Z-Endstop holder with the Torx screws.
** Be careful to not tighten the screws too much.
* Mount the Z-Endstop assembly onto the backside of the aluminium frame in the most upper position. 
* Mount the Z-Endstop in the upper position as shown below. 

|====
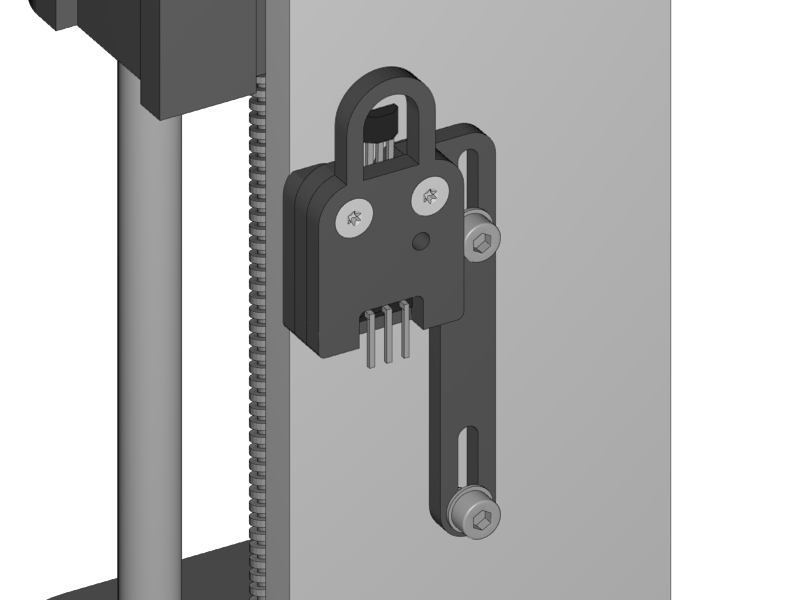
[picture p229: media/Section_3_0018.png]
|
|====

''''
<<<

|====
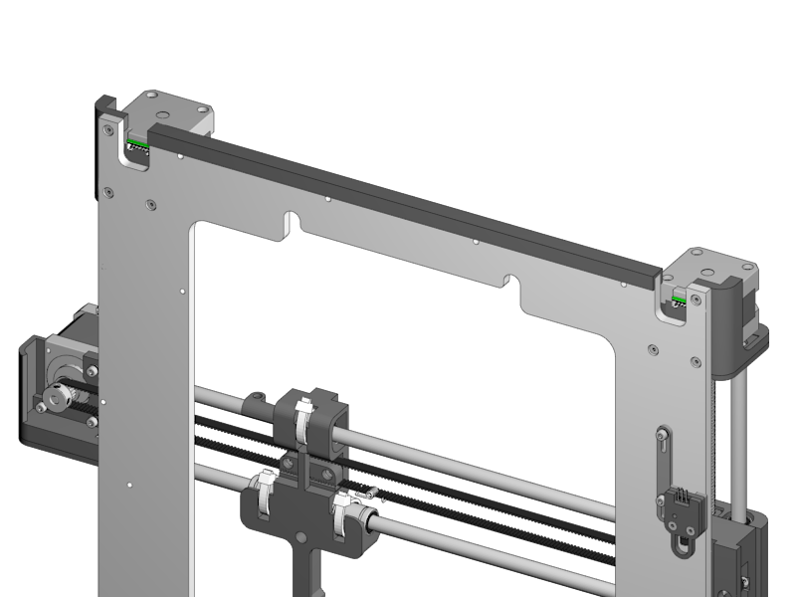
[picture p230: media/Section_3_0019.png]
1.1+||
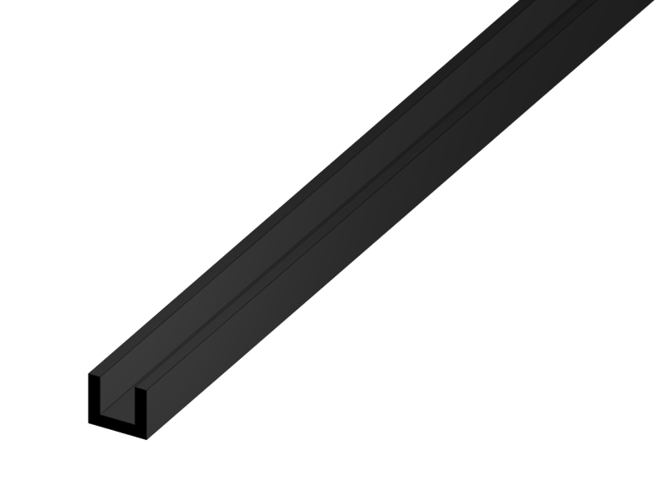
[picture p231: media/Section_1_0165.png]
 +
1x Rubber Strip
|====

* Put the rubber strip to the bottom of the XZ-Frame with some drips of super glue.

link:Section-3.4-Assembling-the-Extruder[Next]
