Pete30/3dtiskarna/Section-2.2-Assembly-of-the-Y-Unit-Mounting-the-Front-and-Back-Plate.asciidoc

link:Section-2.3-Assembly-of-the-Y-Unit-Mounting-the-Y-Carriage-and-Timing-Belt[Next]

link:Section-2-Assembly-of-the-Y-Unit[Section Menu]

|====
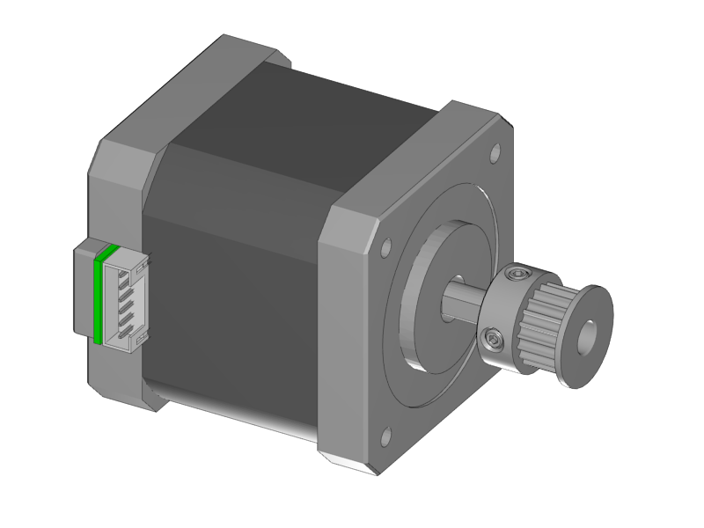
[picture p254: media/Section_2_0010.png]
1.2+||
 +
1x Nema 17 48mm Stepper Motor
|
 +
1x GT2 Pulley
|====

* Mount the pulley onto the motorshaft with the two little set screws. You can find these screws in the little white bag in the box of your RUMBA electronics. 
* The distance between the pulley and the motor is 8mm.

''''
<<<

|====
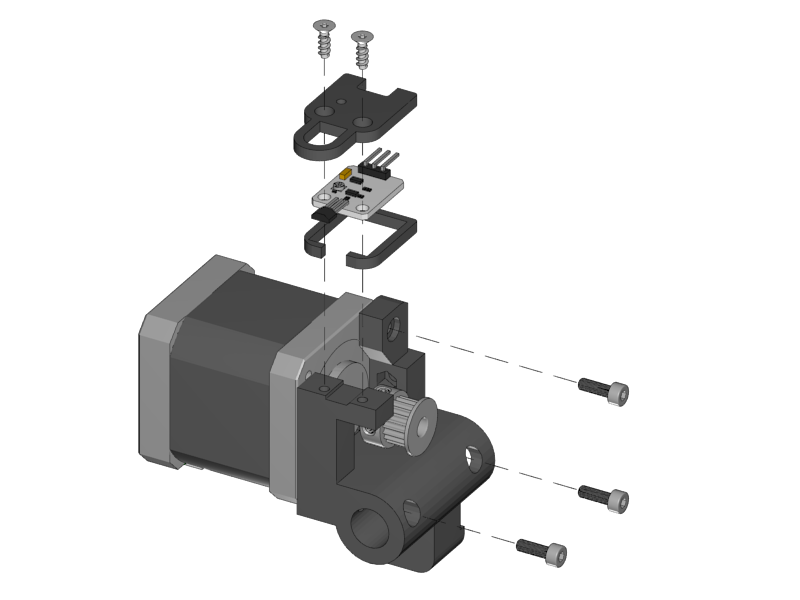
[picture p255: media/Section_2_0011.png]
1.6+||
 +
1x Y-Motor mount 
|
 +
1x End-stop Cover Top
|
 +
1x End-stop Cover Rim
|
 +
1x Hall-O End-stop
|
 +
3x M3x10 Cylinder Screw
|
 +
2x Torx 3x10 Screw
|====

* Mount the motor onto the Y-Motor Holder
* Be sure that the motor connector is facing downwards.
* Mount the end-stop with its cover. Don't make the screws too tight.
** Find the covers in the bag with Acrylic laser cut parts
* In the little box of the end-stops you will find 6 little magnets: don't loose them!

|====
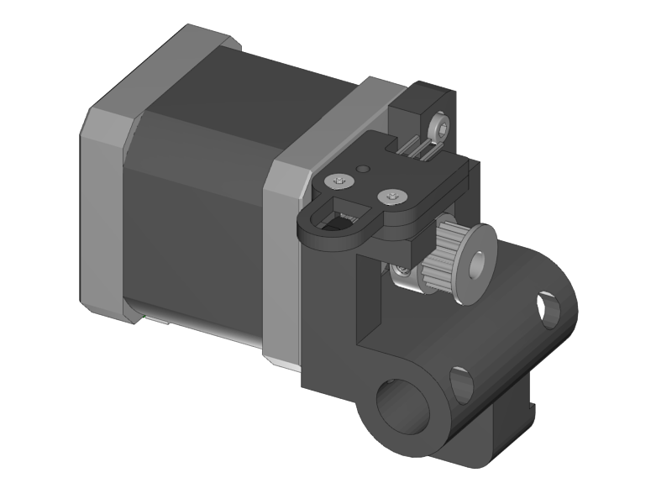
[picture p256: media/Section_2_0012.png]
|
|====

The result looks like this

''''
<<<

|====
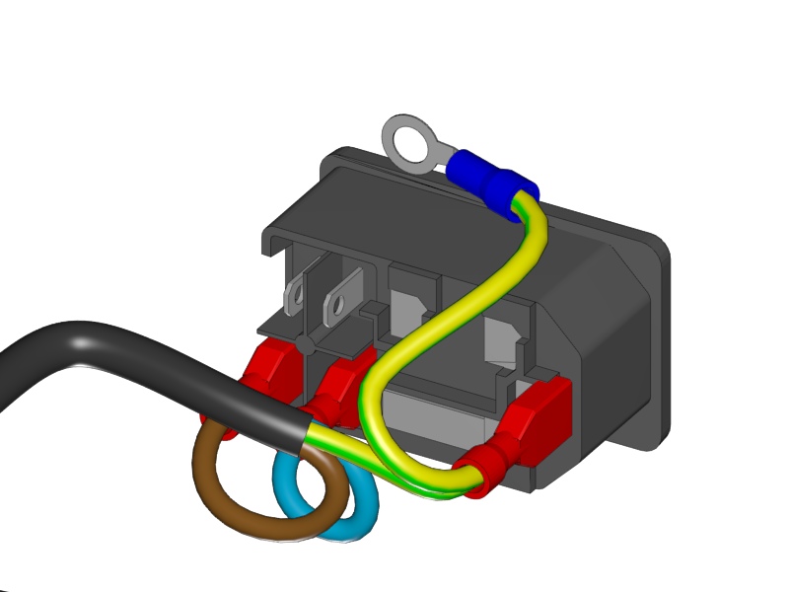
[picture p257: media/Section_2_0013.png]
1.2+||
 +
1x Power Connector
|
 +
2x Glass Fuse
|====

* Put the two glass fuses into the power connector
* Connect the high voltage power cable to the Power connector as shown.
** The connection might be stiff. Be patient and firm, but be careful not to break the power connector pins.

''''
<<<

|====
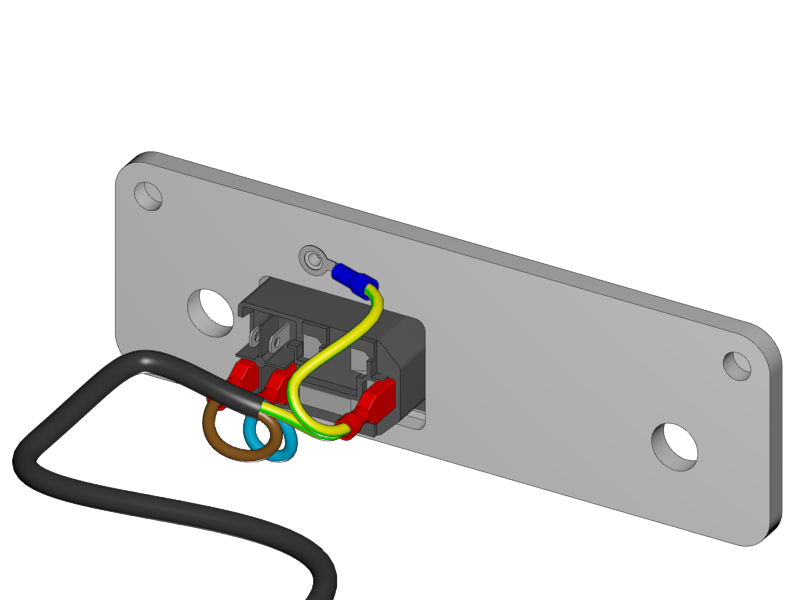
[picture p258: media/Section_2_0014.png]
1.1+||
 +
1x Back Plate
|====

* Be gentle with the aluminium plates. You don't want to scratch them already. 
* Click the power connector into the Back Plate.

''''
<<<

|====
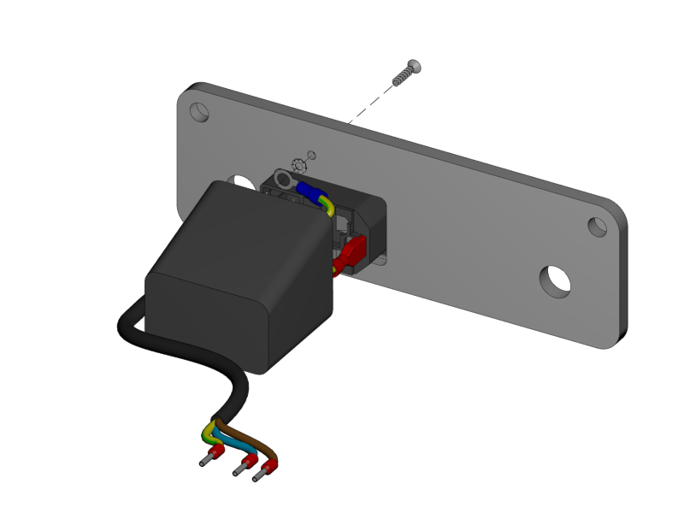
[picture p259: media/Section_2_0015.png]
1.3+||
 +
1x Power Connector Cover
|
 +
1x Torx 3x16 Screw
|
 +
1x Teethed Washer

|====

* Pull the power cable through the hole on the left of the Power Connector Cover.
* Mount the Power Connector Cover with the plastic screw.
* The teeth washer should ensure electrical contact between the ground wire and the aluminium back plate. 

''''
<<<

|====
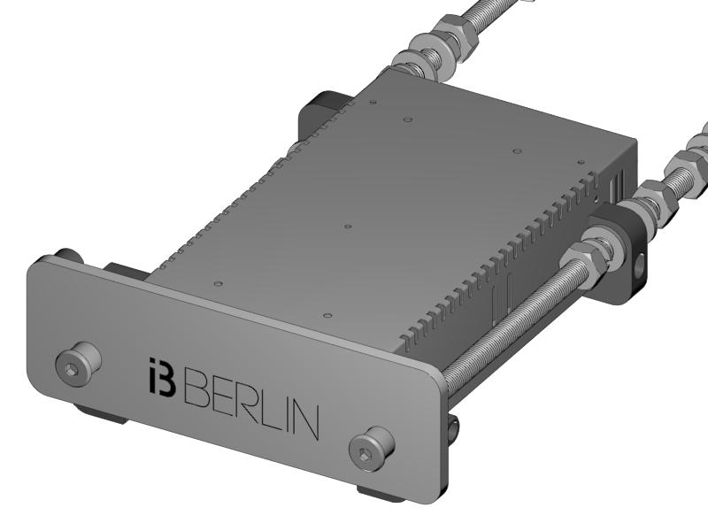
[picture p260: media/Section_2_0016.png]
1.2+||
 +
1x Front Plate
|
 +
2x Round Nut
|====

* Put the front plate onto the threaded rods.
* Put the round nuts to the M10 Threaded rods. Do not fix the front plate yet. 
* Firmly hold the M10 rod and fix the round nut onto the M10 rod.
* The front plate should still be loose now. 

|====
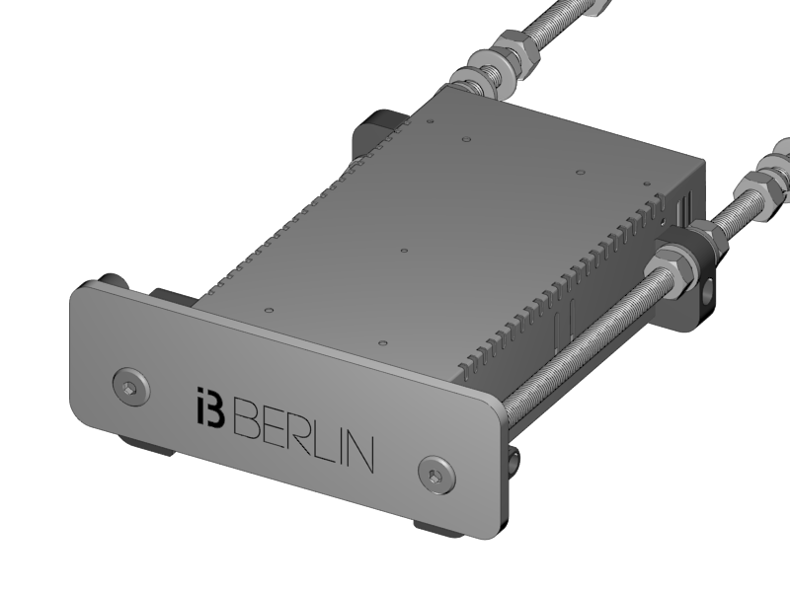
[picture p261: media/Section_2_0017.png]
|
|====

* Fix the front plate by tightening the round nuts. 

''''
<<<

|====
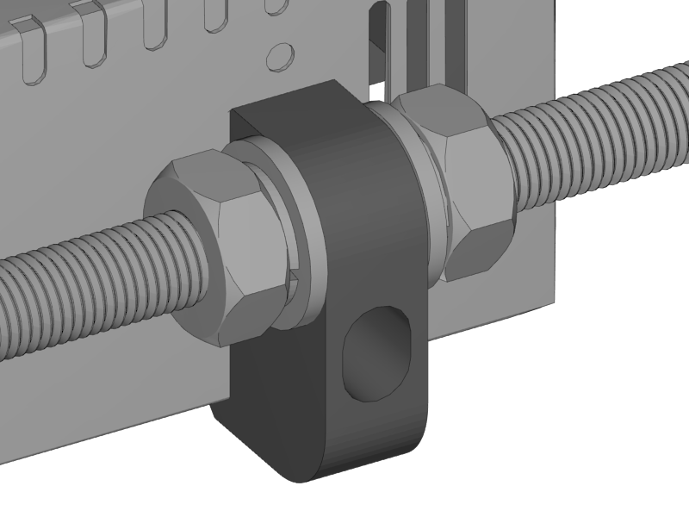
[picture p262: media/Section_2_0018.png]
|
|====

* Tighten the M10 nuts on both sides of both Y-Middle parts
* Make sure that both parts remain straight.

''''
<<<

|====
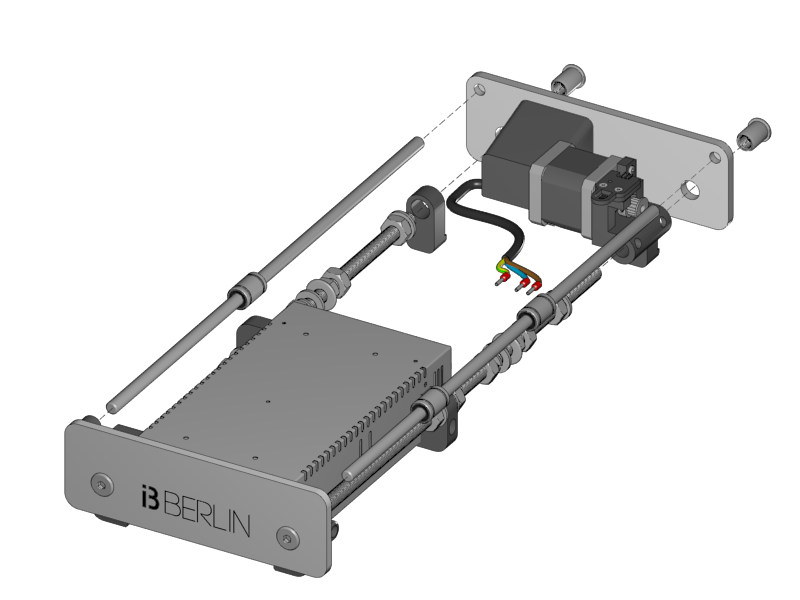
[picture p263: media/Section_2_0019.png]
1.4+||
 +
2x Smooth Rod 8 x 385
|
 +
3x LM8UU Linear Bearing 
|
 +
1x Y-Back Left
|
 +
2x Round Nut
|====

* In general be careful with the aluminium parts and prevent scratches by putting a towel on the table. 
* Test if the smooth rods can enter the hole in the aluminium plates. The holes in the aluminium plates are very accurate and the smooth rods might have a little bur from cutting them. If they don't fit, carefully file of the edge of the rods a little bit until they all fit.
* Put the linear bearings on the rods.
* Put the Y-Motor Holder and the Y-Back Left part on the M10 threaded rods
* Put the smooth rods on the front plate. 
** Mind that the right hand rod has two bearings, the left rod only one.
** Make sure that the left hand rod enters the slot hole in the front plate through the slot hole of the Y-Height adjuster. With the height adjuster you will later make the two smooth rods perfectly parallel.
* Put the Back Plate on the M10 Rods. 
* Tighten the round nuts and the corresponding M10 nuts in such a way that the back plate is nice and straight.

The result looks like this:

|====
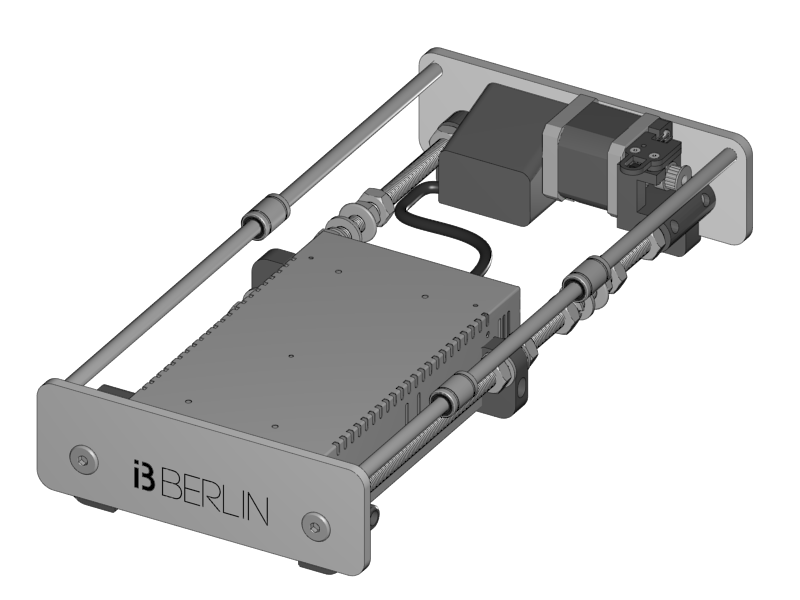
[picture p264: media/Section_2_0020.png]
|
|====

''''
<<<

|====
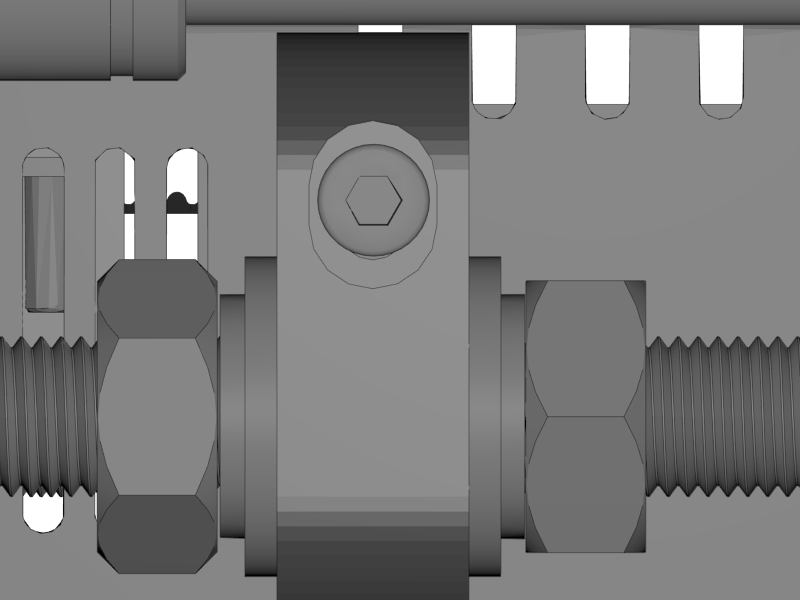
[picture p265: media/Section_2_0020a.png]
|
|====

* If you are having difficulties making the unit straight, see what happens when you loosen the M4 screw on the Power Supply, make the unit straight and fix it again. 

link:Section-2.3-Assembly-of-the-Y-Unit-Mounting-the-Y-Carriage-and-Timing-Belt[Next]
