Pete30/3dtiskarna/Section-2-Assembly-of-the-Y-Unit.asciidoc

link:Section-3-Assembly-of-the-XZ-Unit[Next Section]

|====
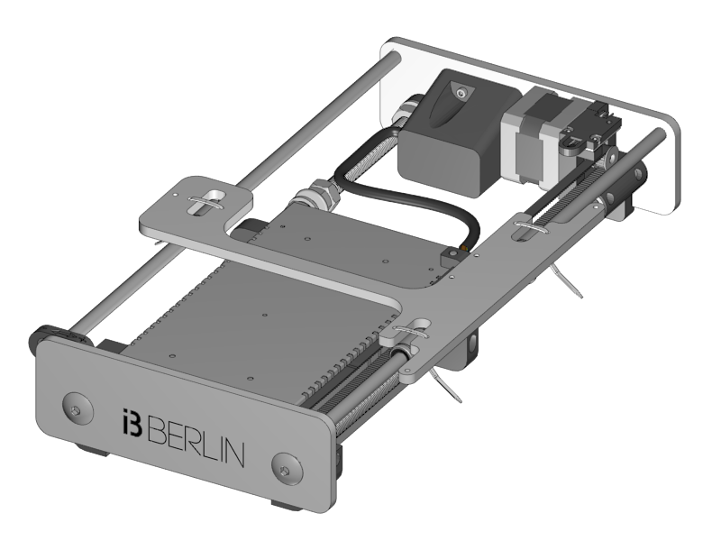
[picture p276: media/Section_2_0001.png]
|
|====

This is what you will build in this section. It is the Unit that moves the print platform, also known as the Y-Movement. Below are the steps for building it. 

link:Section-2.1-Assembly-of-the-Y-Unit-Mounting-the-threaded-Rods-and-Power-Supply[Section 2.1]: Mounting the Threaded Rods and Power Supply +

link:Section-2.2-Assembly-of-the-Y-Unit-Mounting-the-Front-and-Back-Plate[Section 2.2]: Mounting the Front- and Back- Plate +

link:Section-2.3-Assembly-of-the-Y-Unit-Mounting-the-Y-Carriage-and-Timing-Belt[Section 2.3]: Mounting Motor and Y-Carriage +

link:Section-3-Assembly-of-the-XZ-Unit[Next Section]
