Pete30/3dtiskarna/Section-3-Assembly-of-the-XZ-Unit.asciidoc

link:Section-4-Wiring[Next Section]

|====
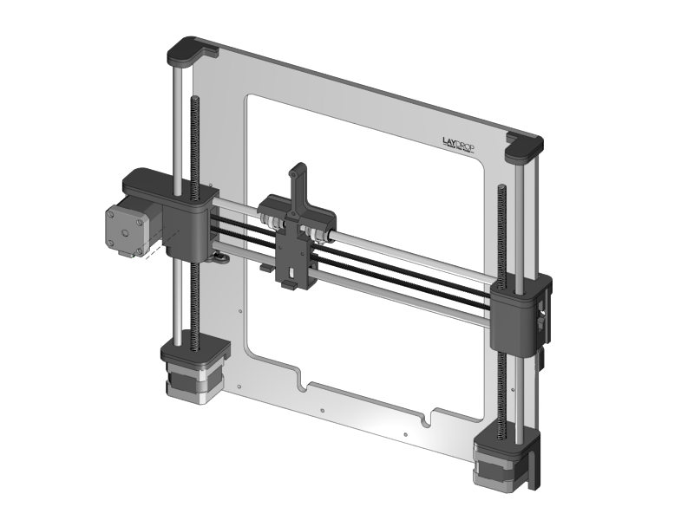
[picture p277: media/Section_3_0001.png]
|
|====

This is what you will build in this Section. Check the subsections below and have fun building!

link:Section-3.1-Assembly-of-the-XZ-Unit-Mounting-the-X-Axis[Section 3.1]: Mounting the X-Axis +

link:Section-3.2-Assembly-of-the-XZ-Unit-Mounting-the-Z-Axis[Section 3.2]: Mounting the Z-Axis +

link:Section-3.3-Assembly-of-the-XZ-Unit-Mounting-the-Timing-Belt[Section 3.3]: Mounting the Timing Belt +

link:Section-4-Wiring[Next Section]
