Pete30/3dtiskarna/Section-4-Wiring.asciidoc

link:Section-5-Calibration[Next Section]

You made the main units. After wiring up the Y-Unit you will put them together. While you're at it, just wire everything, including preparing the wiring for the extruder and the heatbed, that you will assemble later. 
We prefer organized wiring over spaghetti. It is important how you put the cables, so have a good look at all the nice 3D renders we made. 

|====
|
|====

|====
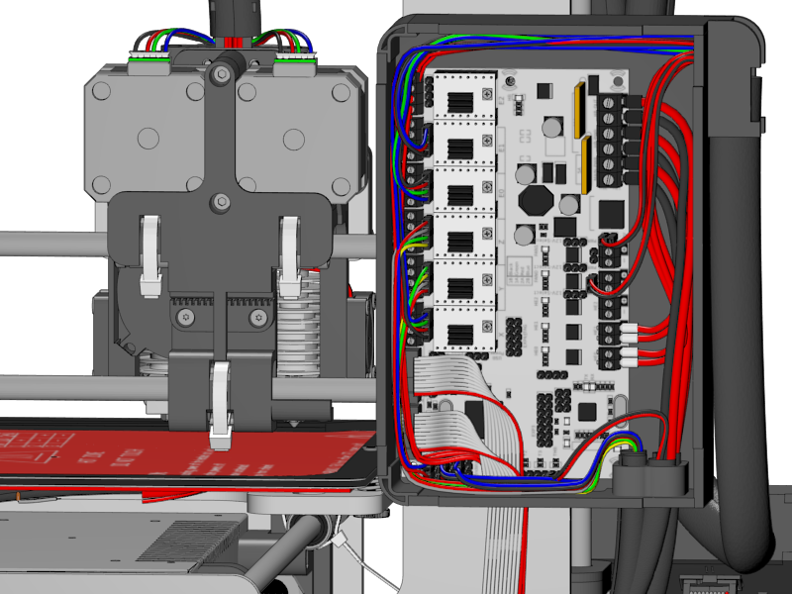
[picture p278: media/Section_4_0047.png]
|
|====

link:Section-4.1-Wiring-the-Power-Supply[Section 4.1]: Wiring the Power Supply +
link:Section-4.2-Wiring-the-Z-Unit[Section 4.2]: Wiring the Z-Unit +
link:Section-4.3-Wiring-the-Y-Unit[Section 4.3]: Wiring the Y-Unit +
link:Section-4.4-Wiring-the-X-Axis[Section 4.4]: Wiring the X-Axis +
link:Section-4.5-Gluing-the-Endstop-Magnets[Section 4.5]: Gluing the Endstop Magnets +
link:Section-4.6-Uploading-Firmware[Section 4.6]: Uploading Firmware +
link:Section-4.7-Wiring-the-Extruder[Section 4.7]: Wiring the Extruder +
link:Section-4.8-Mounting-the-Heatbed[Section 4.8]: Mounting the Heatbed +

link:Section-5-Calibration[Next Section]
