Pete30/3dtiskarna/Section-4.1-Wiring-the-Power-Supply.asciidoc

link:Section-4.2-Wiring-the-Z-Unit[Next]

|====
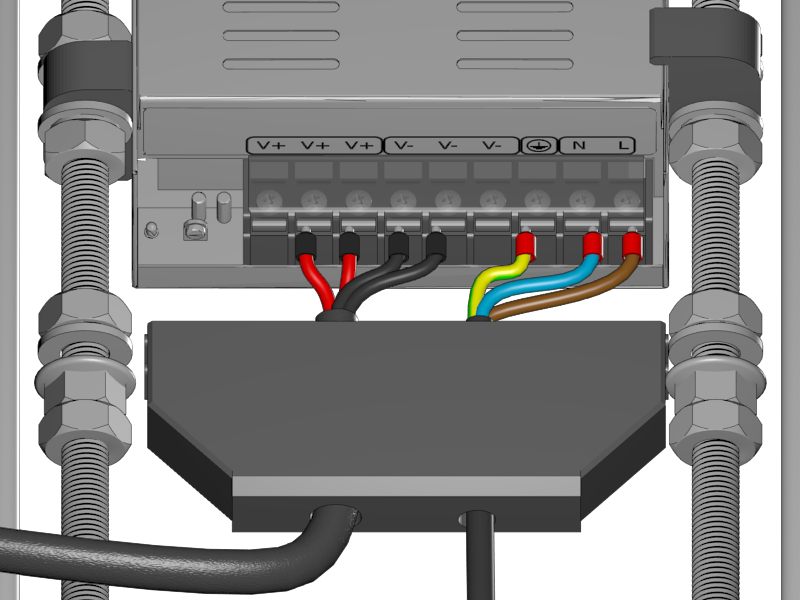
[picture p279: media/Section_4_0002.png]
1.1+||
 +
1x Power Supply Cover
|====

* Lead all the power wires through the opening of the Power Supply Cover
* Connect the red wires to the 12V+
* Connect the black wires to the 12V-
* Connect the green/yellow cable to the GND, recognizable by the symbol of a striped arrow pointing downwards. 
* Connect the brown high voltage cable to the L
* Connect the blue high voltage cable to the N
* Check again if everything is correct and that there is no chance for electrical short circuits. 
* Make the screws really tight.

''''
<<<

|====
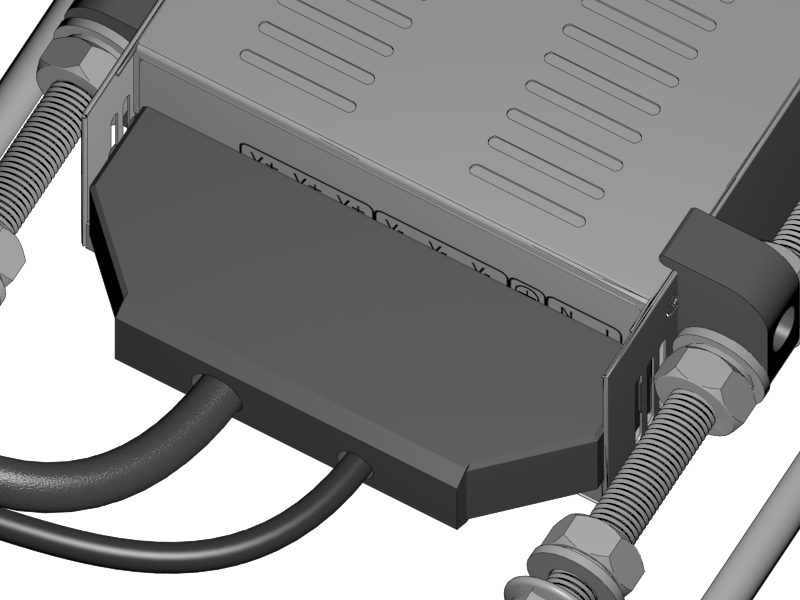
[picture p280: media/Section_4_0003.png]
|
|====
 
* Close the lid of the Power Supply
* Slide in the Power Supply Cover

''''
<<<

|====
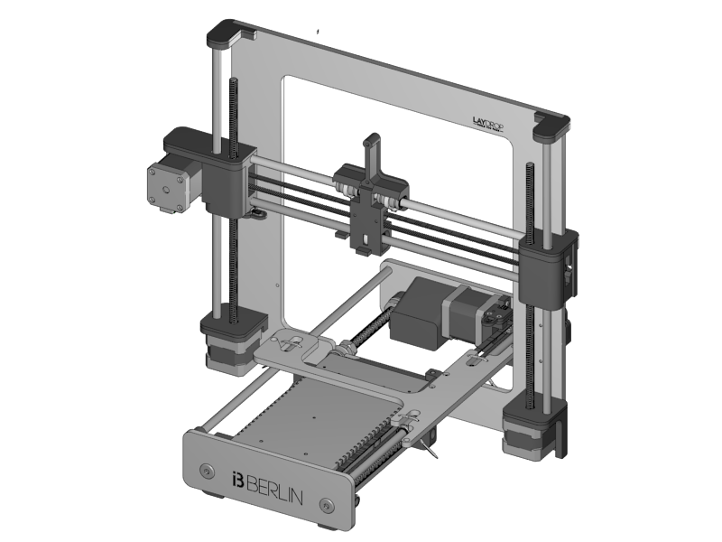
[picture p281: media/Section_4_0007.png]
|
|====

* Now is the big moment to join the two units!
* Put the Y-Unit into the XZ Unit.
* Make sure that all the washers are at the front of the XZ plate
* Make sure that the left hand nuts are still loose and have ample place for the XZ plate to fit in.
* Tighten the right hand nut
 
''''
<<<

|====
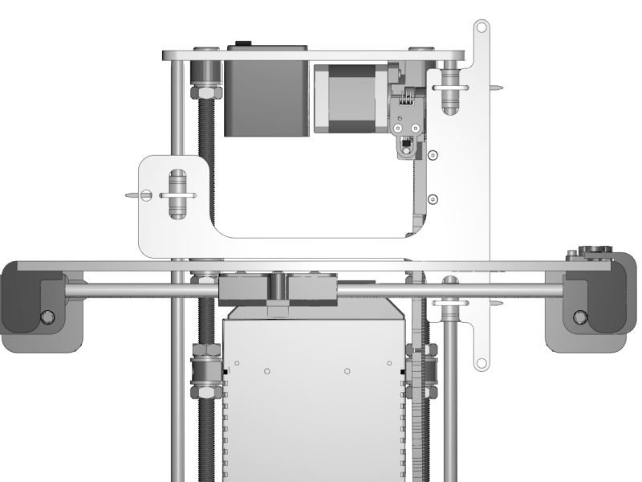
[picture p282: media/Section_4_0008.png]
|
|====

* Slide the Y-Carriage to the back
* Look from the top with one eye to see if the Y-Carriage is parallel to the XZ-Plate

''''
<<<

|====
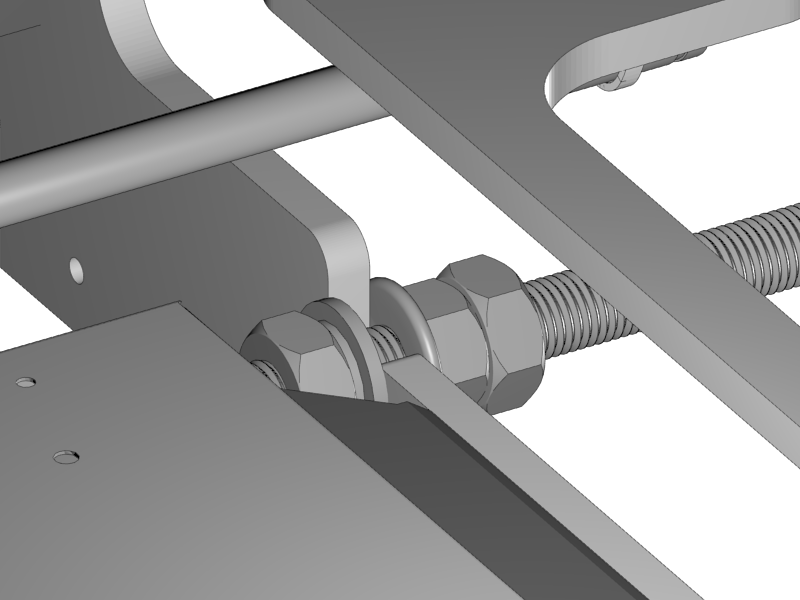
[picture p283: media/Section_4_0009.png]
|
|====

* Close the left hand front nut and the flange nut
* Always keep looking that the XZ-Plate is parallel to the Y-Carriage
* Tighten the left hand nuts completely and lock it with the rear M10 nut. 
* Congratulations! It suddenly looks much more like a 3D printer!

''''
<<<

|====
|
|====

* Search for the flatband cables in the box of your graphic display controller
* Remove the cables from the adapter
* Notice that the cable has slightly different connectors on both ends
* Pick the end where the little notch on the connector is in the same direction as the cable.

''''
<<<

|====
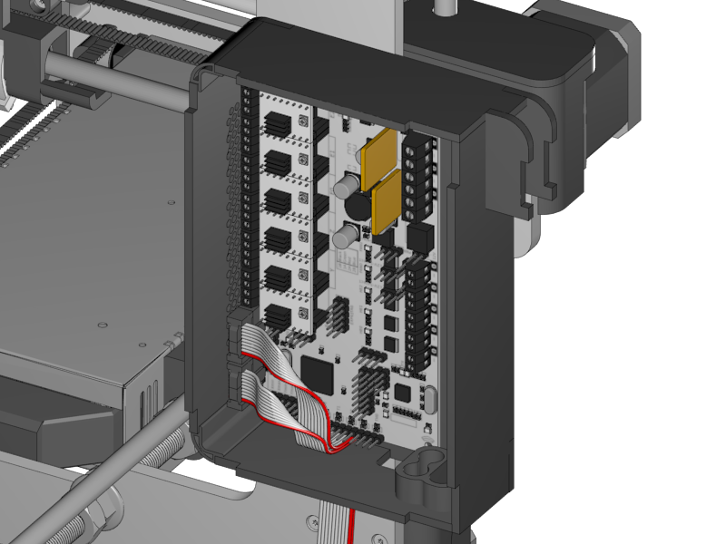
[picture p284: media/Section_4_0010.png]
1.3+||
 +
1x RUMBA
|
 +
2 x M3x10 Cylinder Screw
|
 +
2 x Spacer
|====

* Plug in the flatband cables
* There is a black mark on the PCB of the RUMBA, this is where the notch of the connector should be. Also mind the orientation of the red wire as shown in the picture above.
* Fold the flatband cables so they both leave neatly through the opening in the RUMBA Case
* Mount the RUMBA with its case to the frame with the two screws.
** Put the two spacers between the RUMBA and the case. 

''''
<<<

|====
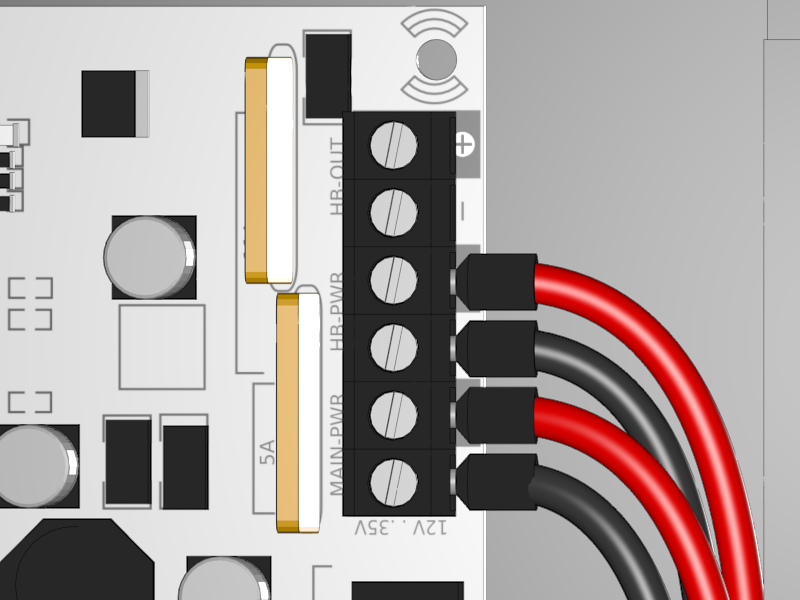
[picture p285: media/Section_4_0011.png]
1.1+||
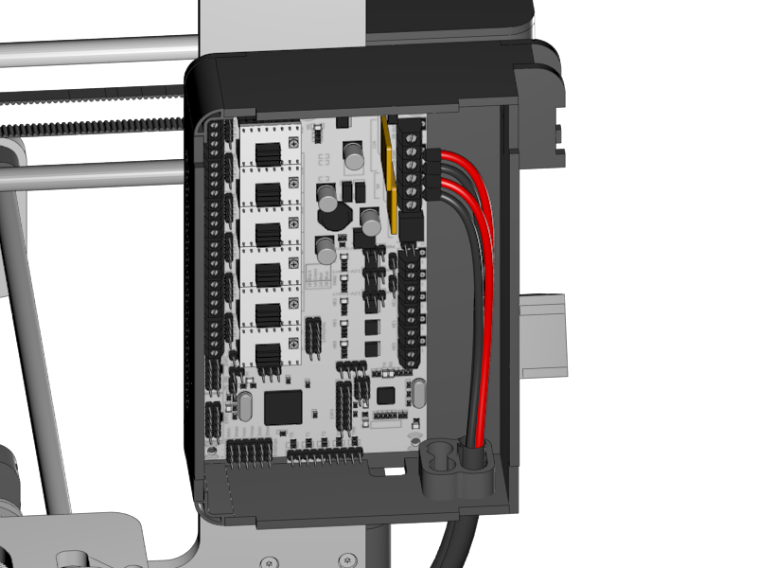
[picture p286: media/Section_4_0012.png]
 +
Power Connection
|====

* Lead the Power-wires through the inlet hole in the casing.
* Connect them to both the 12V inputs on the RUMBA
** Mind the polarity of the wires!

link:Section-4.2-Wiring-the-Z-Unit[Next]
