Pete30/3dtiskarna/Section-4.2-Wiring-the-Z-Unit.asciidoc

link:Section-4.3-Wiring-the-Y-Unit[Next]

|====
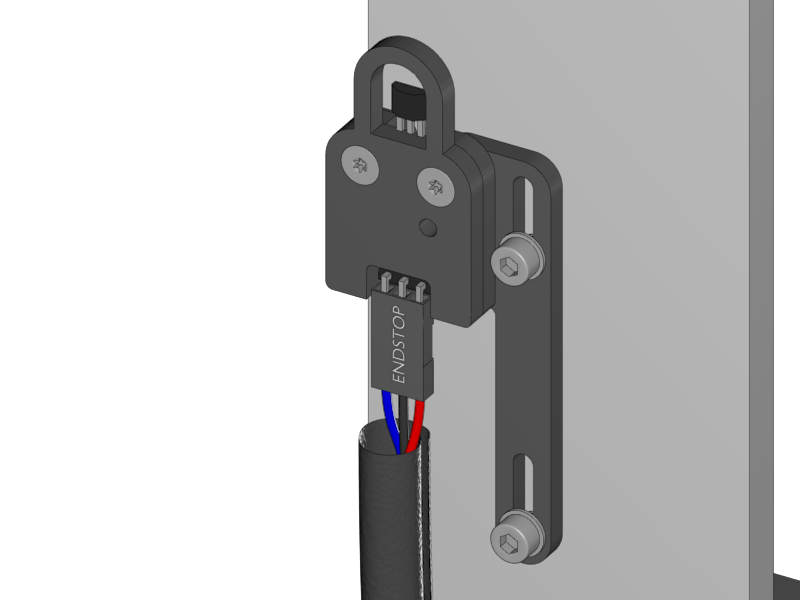
[picture p287: media/Section_4_0016.png]
||
|====

* Connect the Z-Endstop cable to the endstop, which is 67cm long. 
* Mind the orientation of the connector. The red wire should be on the right. 
* Apply a piece of 54cm long braided sleeve to the cable. 

''''
<<<

|====
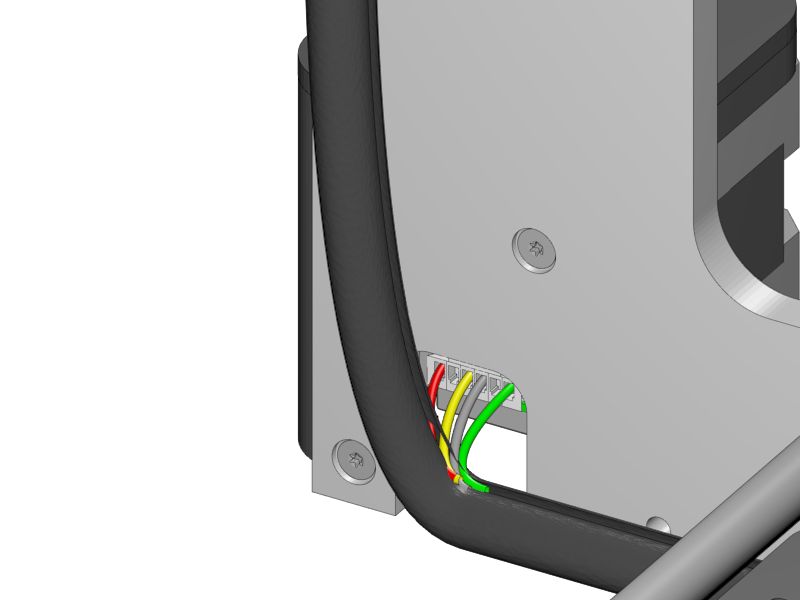
[picture p288: media/Section_4_0017.png]
|
|====

* The Z-Motors are serially connected. The cable is made to have two motor connector and one connector that goes on the electronics. 
* Connect the longer end of the Z-Motor cable to the motor closest to the endstop. 
* Join the cable into the braided sleeve. 

''''
<<<

|====
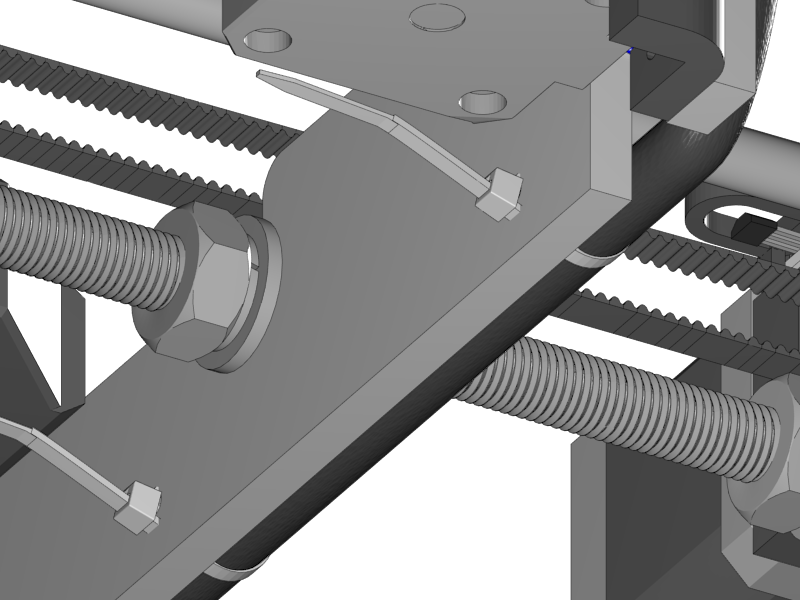
[picture p289: media/Section_4_0018.png]
|
|====

* Attach the braided sleeve to the aluminium plate with 4 zipties. 
* Be sure that the zipties are not on the bottom of the plate. Make it exactly as shown in the picture. 

''''
<<<

|====
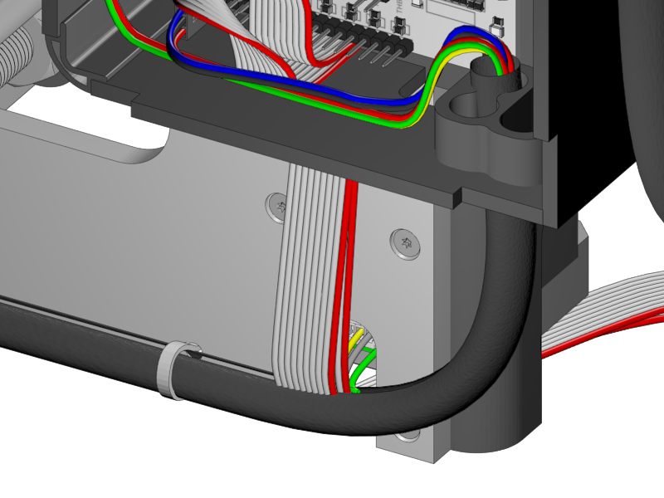
[picture p290: media/Section_4_0019.png]
|
|====

* Connect the shorter end of the Z-Motor cable to the other Z-motor and lead the cable through the braided sleeve. 
* Make sure that the flatband cable is behind the Z-Cable leaving to the front through the hole of the Z-Motor.

''''
<<<

|====
1.2+||
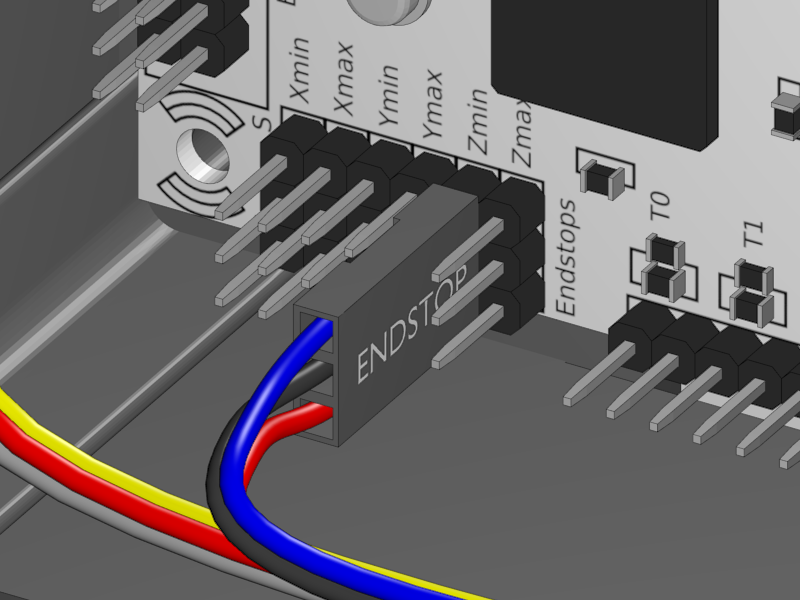
[picture p291: media/Section_4_0020.png]
 +
Z-Endstop Connection
|
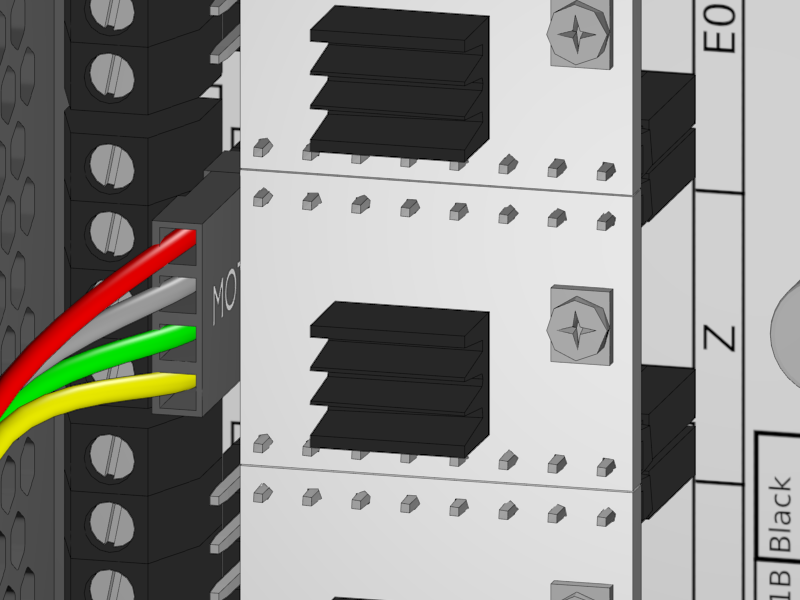
[picture p292: media/Section_4_0021.png]
 +
Z-Motor Connection
|====

* Connect the endstop and the motor to the Rumba. 
** If the motor wires are red grey yellow green put the red wire on top. 

link:Section-4.3-Wiring-the-Y-Unit[Next]
