Pete30/3dtiskarna/Section-4.4-Wiring-the-X-Axis.asciidoc

link:Section-4.5-Gluing-the-Endstop-Magnets[Next]

|====
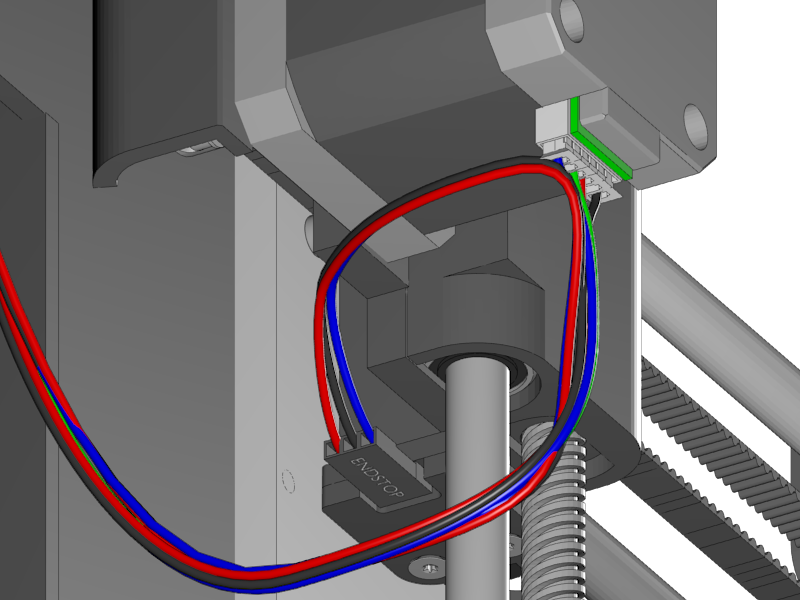
[picture p298: media/Section_4_0025.png]
|
|====

* Connect the Endstop cable (60cm) with the red wire close to the frame
* Connect the Motor wire which is 53cm long.

''''
<<<<

|====
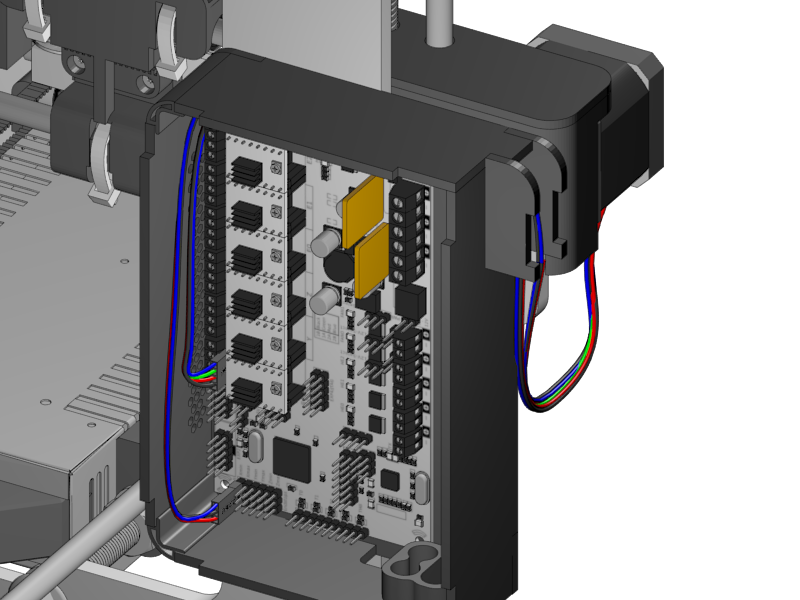
[picture p299: media/Section_4_0024.png]
1.2+||
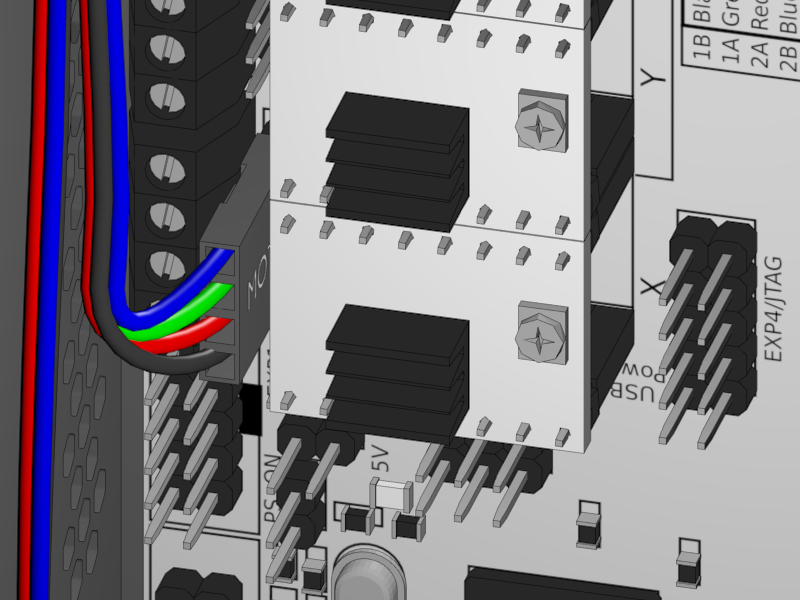
[picture p300: media/Section_4_0022.png]
 +
X-Motor Connection
|
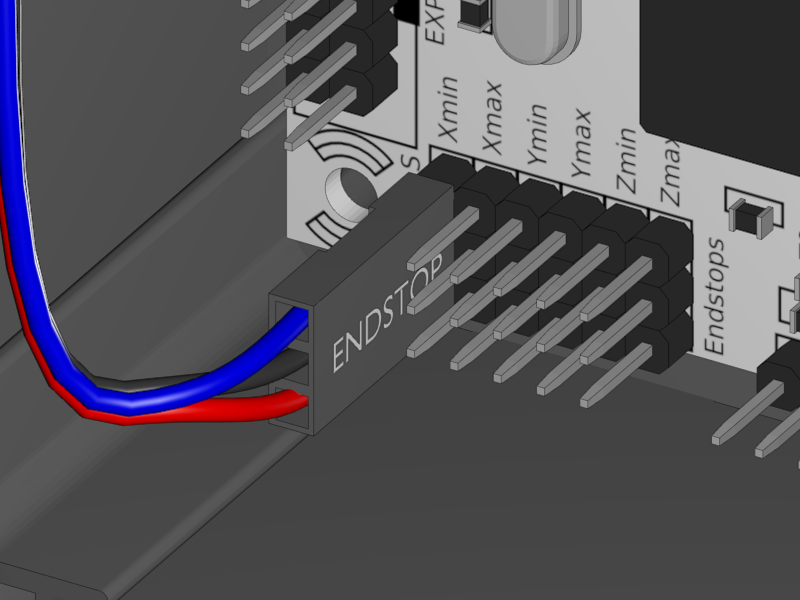
[picture p301: media/Section_4_0023.png]
 +
X-EndStop Connection
|====

* Lead the wires through the side opening. 
* Connect them to the RUMBA like you did with the Z and the Y.
* This is a temporary connection, you will make it nice in a minute. 

link:Section-4.5-Gluing-the-Endstop-Magnets[Next]
