Pete30/3dtiskarna/Section-6-Printing.asciidoc

link:Section-6.1-FilamentHolder[Section 6.1]: FilamentHolder +	
link:Section-6.2-Cura[Section 6.2]: Cura +
link:Section-6.3-Kisslicer[Section 6.3]: Kisslicer +
link:Section-6.4-Dual-Printing[Section 6.4]: Dual Printing +
