Pete30/3dtiskarna/Section-5.4-Calibrating-the-Print-Platform.asciidoc

link:Section-6-Printing[Next]

* The mirror should be well adjusted to the nozzle. 
* Turn the adjust nuts to about 1cm height.
* First home. Disable the steppers. Move the nozzle above the heatbed by hand. 
* If the nozzle is (for example) about 5mm above the heatbed, put the Z-Endstop about 4mm down.
* Home again until the nozzle is about 1mm above the mirror. 
* Move the printbed and nozzle in the position close to the left adjusting point

|====
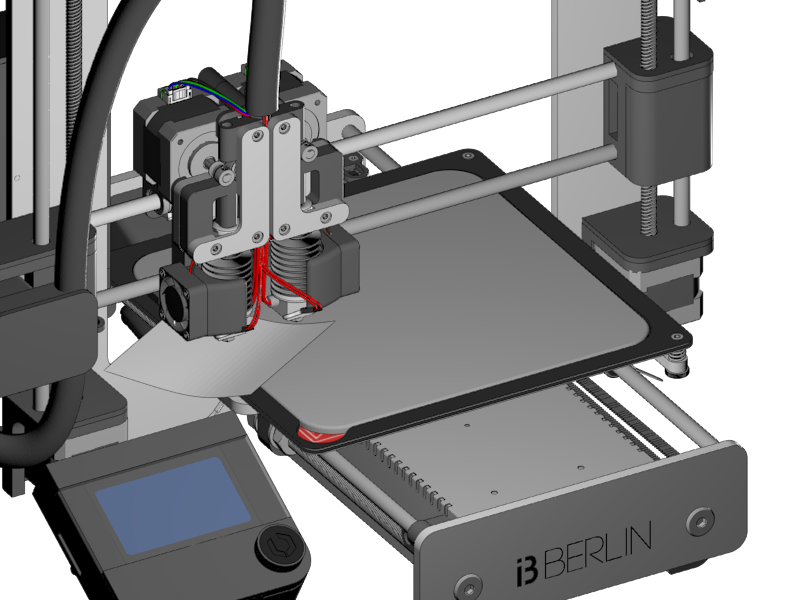
[picture p302: media/Section_5_0027.png]
|
|====

* Put a piece of paper under the nozzle
** If there is some plastic drip under the nozzle caused by previous prints, heat up the nozzle to printing temperature. 
* Turn the bed up (clock wise direction looking from the top) until the nozzle just grabs the paper. You can feel friction between the nozzle and the heatbed when you pull the paper, but your still capable to push the paper easily.

|====
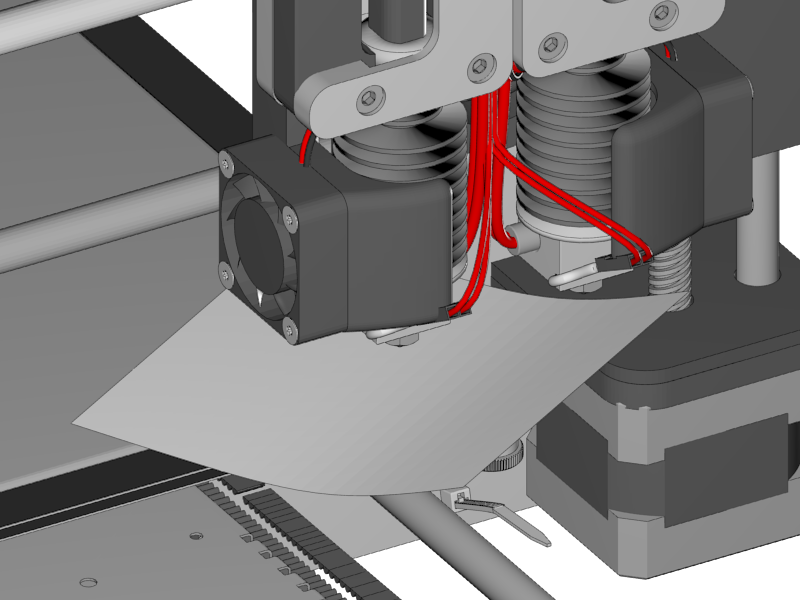
[picture p303: media/Section_5_0028.png]
|
|====

* Move the nozzle to the front right position. Keep the paper underneath the nozzle while moving to prevent scratches. 
* Adjust the height of the platform until the paper touches just right

|====
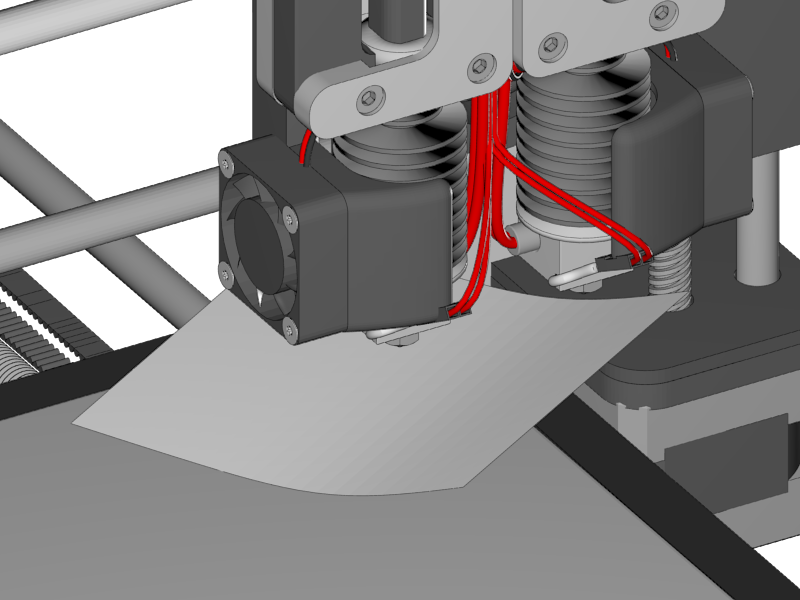
[picture p304: media/Section_5_0029.png]
|
|====

* Move the nozzle to the right back position. Keep the paper underneath the nozzle while moving to prevent scratches.
* Adjust the height of the platform until the paper touches just right.
* Repeat the adjustment of the 3 points until they are all perfectly adjusted. 

|====
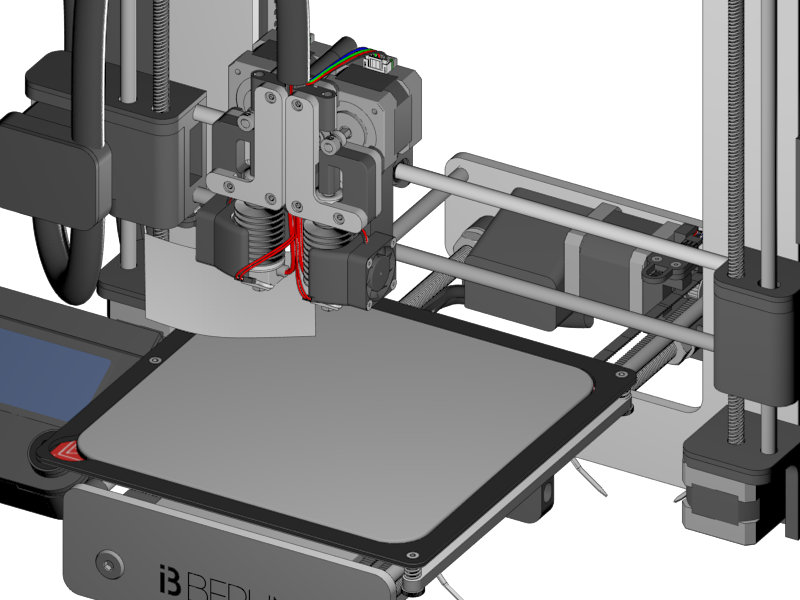
[picture p305: media/Section_5_0030.png]
|
|====

* As a last check up, check the front and back left corner. If there is a big difference you should repeat link:Section-5.2-Calibrating-the-Y-Axis[Calibrating the Y-Axis] again or try to solve it with the paper trick.

|====
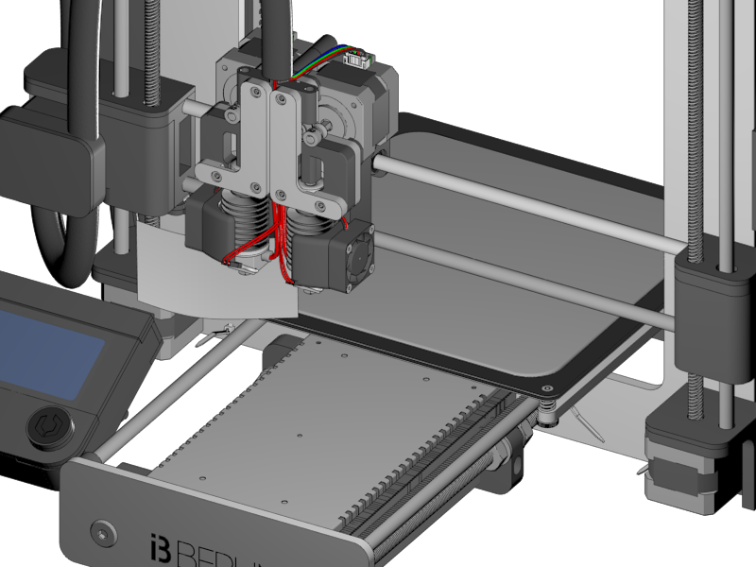
[picture p306: media/Section_5_0031.png]
|
|====

* This calibration is be best done before every print. 

link:Section-6-Printing[Next]
