Pete30/3dtiskarna/Section-5.3-Calibrate-the-X-Axis.asciidoc

link:Section-5.4-Calibrating-the-Print-Platform[Next]

|====
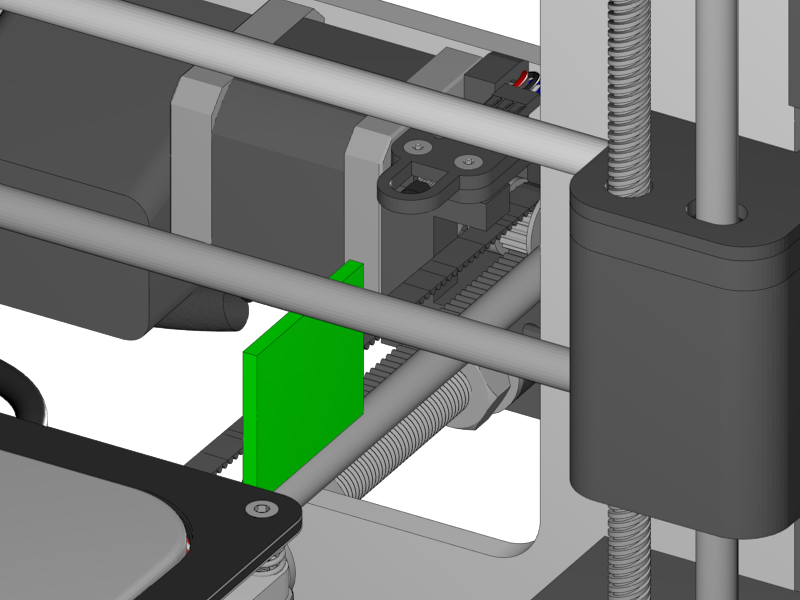
[picture p307: media/Section_5_0024.png]
|
|====

* The X Bridge needs to be parallel to the Y-Rods. 
* Do this by putting any object on the right Y-Smooth Rod, turn the right motor spindle down by hand until it just touches the object.
* Do the same on the left side until both sides are equal.

|====
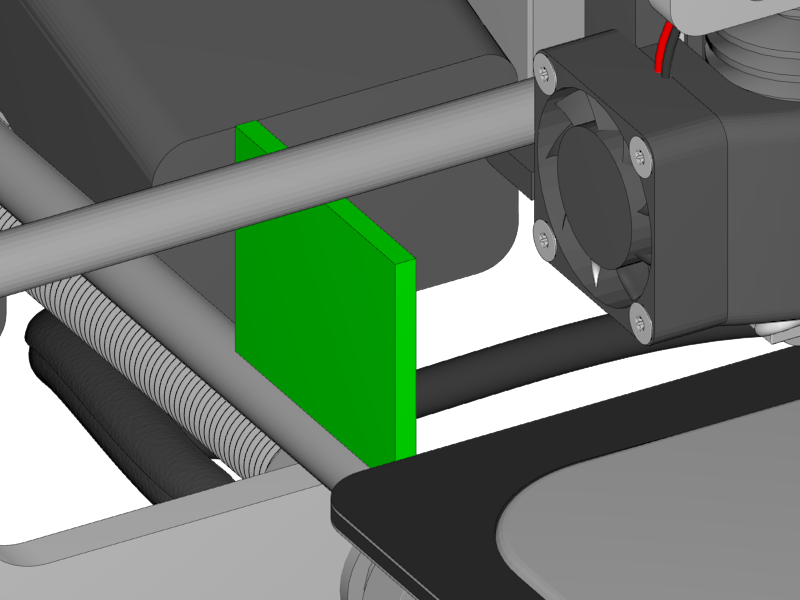
[picture p308: media/Section_5_0025.png]
|
|====

* This calibration should be repeated after transport and or once a week or so. Make sure the Y-Rods are parallel first. 

link:Section-5.4-Calibrating-the-Print-Platform[Next]
