Pete30/3dtiskarna/Section-5.2-Calibrating-the-Y-Axis.asciidoc

link:Section-5.3-Calibrate-the-X-Axis[Next]

|====
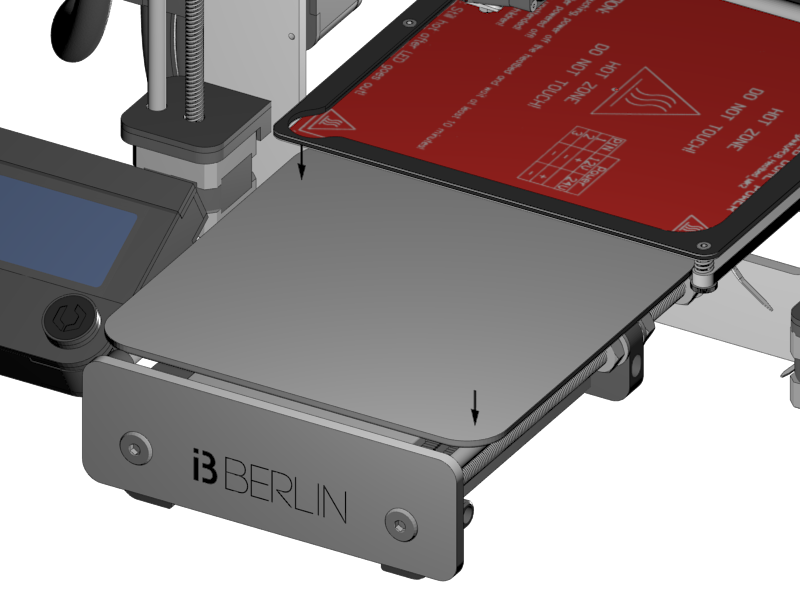
[picture p309: media/Section_5_0022.png]
|
|====

* Slide the y-carriage all the way to the back.
* Put the mirror upside down on the smoothrods.
* Tap the diagonally opposing corners and see if they make sound ticking on the smooth rods. 
* If so, the rods of the Y-Axis are not parallel and you need adjust it. 
** Do so by turning the screw of the Y-Height adjuster up or down. 
** Adjust it until the rods are parallel to the mirror.

|====
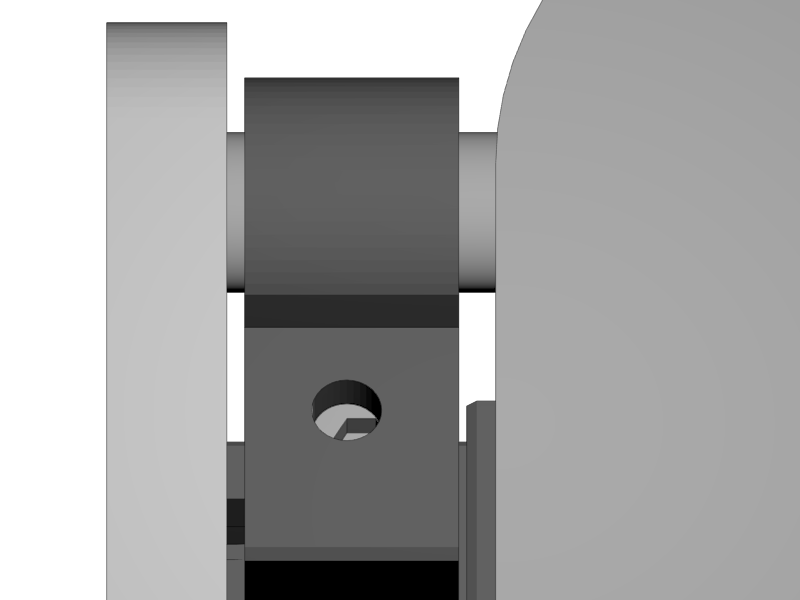
[picture p310: media/Section_5_0023.png]
|
|====

link:Section-5.3-Calibrate-the-X-Axis[Next]
