Pete30/3dtiskarna/Section-5-Calibration.asciidoc

link:Section-6-Printing[Next Section]

Finally we are getting the printer alive step by step. While doing this you will also calibrate your printer. Without proper calibration the printer will not function properly. Don´t worry, it will be easy. 

link:Section-5.1-Testing-Functionality[Section 5.1]: Testing if everything works and closing of the last bits of the casing. +
link:Section-5.2-Calibrating-the-Y-Axis[Section 5.2]: Adjusting the Y axis to be parallel. +
link:Section-5.3-Calibrate-the-X-Axis[Section 5.3]: Calibrating the X-Bridge to be straight. +
link:Section-5.4-Calibrating-the-Print-Platform[Section 5.4]: Calibrating the Print Platform. +

link:Section-6-Printing[Next Section]
