Pete30/3dtiskarna/Section-1.1-History.asciidoc

link:Section-1.2-Tools-and-Parts[Next]

link:Section-1-Introduction[Section Menu]

It all started with http://adrianbowyer.net/[Adrian Bowyer], professor at the university of Bath in the UK. He felt inspired by a much older idea of the universal constructor, a theoretical machine by the mathematician http://en.wikipedia.org/wiki/Von_Neumann_universal_constructor[John von Nuemann] just after WW2. This machine could reproduce itself and look for it´s own raw materials and take care of it´s own transport. Bowyer´s machine didn´t have to be that complicated, if it could only make half of it´s own parts it would already be a breakthrough. 

|====
| + 
Adrian Bowyer
|====

In the year 2004 he wrote down this idea in his manifesto: http://reprap.org/wiki/Wealth_Without_Money[“wealth without money”]. He called the project RepRap, which stands for self-REPlicating RAPid prototyper. He decided that this project should evolve like nature, which is based on the free multiplication of information. 

These ideas inspired many around the globe, but it still took until the year 2008 before the first working RepRap actually became a mother of the next RepRap.  

|====
| +
RepRap Darwin
|====

This first machine was called the Darwin, and was a difficult to build and difficult to operate piece of machinery. It worked, but could also be improved. 

|====
| +
RepRap Mendel
|====

The first improvements came from Bowyers own lab in the shape of the Mendel. This was a much better machine, but still difficult to build, and that is where a young enthusiast from Prague came on the stage. 

|====
| +
Prusa Mendel
|====

His name Josef Prusa and he redesigned the Mendel into the Prusa-Mendel, a much easier to build machine and therefore much more accessible. Thousands of people built this open source machine. The software improved, as well as the electronics. An entire RepRap economy started growing and many other people started making their own printer designs. 

|====
| +
Prusa i3
|====

In 2012 Prusa did it again and made a complete new 3D printer design which was even easier to build. He called it the Prusa i3, which stands for “iteration 3”.

We, as Open 3d Engineering started to host workshops in building the Prusa i3 in our hometown Berlin. After 50 printers build we decided to pimp up the Prusa i3, our design is called the i3 Berlin. 
This is the printer that we will build in this video. We believe that this is an even easier to build desktop 3D printer, and of course it is completely open source. 

|====
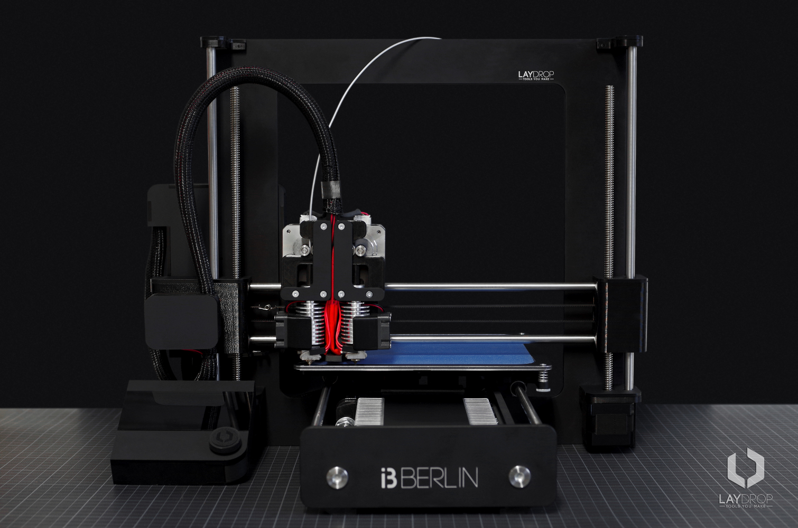
[picture p317: staticmedia/i3_Berlin_small.jpg]
| 
|====

We, nor Josef Prusa, nor Adrian Bowyer could have done anything without the vibrant RepRap community.  
We like to end this little history lesson by thanking the RepRap community on the IRC and on the reprap.org website. The fantastic blogs of http://richrap.blogspot.de/[RichRap] and http://hydraraptor.blogspot.de/[Nophead]. The editors of the http://reprapmagazine.com/[Reprap magazine]. And most of all the software developers like https://www.youtube.com/watch?v=sr-ASAqxiJg[Kliment Yanev], http://slic3r.org/[Alessandro Ranellucci], http://reprap.org/wiki/Marlin[Erik van der Zalm], the Arduino community and many many others. Thank you!

link:Section-1.2-Tools-and-Parts[Next]
