Pete30/3dtiskarna/(commit log)

2015-08-17 inserted manual
2016-02-28 fixed cura install and display contoller cable
2016-02-28 Revert "fixed cura install and display contoller cable"
    This reverts commit f587e5d1a2c4d09723449b0129b63eed05d2d0ad.
    Conflicts:
    Section-6.3-Kisslicer.asciidoc
2016-06-14 Updated Section 2 Assembly of the Y Unit (asciidoc)
2016-06-14 Updated Section 2.1 Assembly of the Y Unit Mounting the threaded Rods and Power Supply (asciidoc)
2016-06-14 Updated Section 2.2 Assembly of the Y Unit Mounting the Front and Back Plate (asciidoc)
2016-06-14 Updated Section 2.3 Assembly of the Y Unit Mounting the Y Carriage and Timing Belt (asciidoc)
2016-06-14 Updated Section 3.1 Assembly of the XZ Unit Mounting the X Axis (asciidoc)
2016-06-14 Updated Section 3.2 Assembly of the XZ Unit Mounting the Z Axis (asciidoc)
2016-06-14 Updated Section 3.3 Assembly of the XZ Unit Mounting the Timing Belt (asciidoc)
2016-06-14 Updated Section 3.4 Assembling the Extruder (asciidoc)
2016-06-14 Updated Section 4.5 Gluing the Endstop Magnets (asciidoc)
2016-06-14 Updated Section 4.7 Wiring the Extruder (asciidoc)
2016-06-14 Updated Section 4.8 Mounting the Heatbed (asciidoc)
2016-06-14 Updated Section 5 Calibration (asciidoc)
2016-06-14 Updated Section 5.2 Calibrating the Y Axis (asciidoc)
2016-06-14 Updated Section 5.3 Calibrate the X Axis (asciidoc)
2016-06-14 Updated Section 5.4 Calibrating the Print Platform (asciidoc)
2016-06-14 Updated Section 6.1 FilamentHolder (asciidoc)
